AndChen153/Stability-Setup/data/Mar-15-2023/README.txt

scanlightMar-15-2023 13_34_51.csv
actually a light scan just renamed to dark scan for powerpoint testing purposes
