AndChen153/Stability-Setup/data/July-11-2022/DataPPT.pptx

## Slide 2

## Slide 3

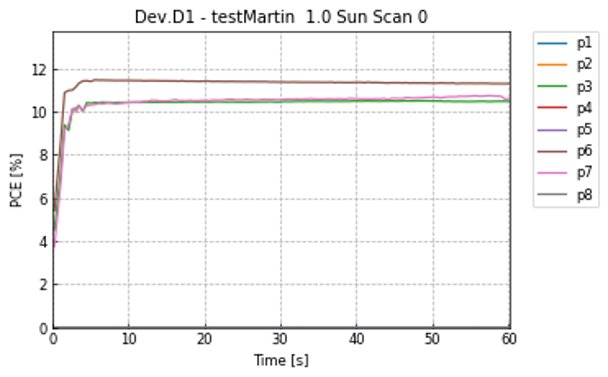
[picture p5: figure]
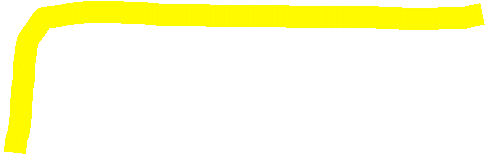
[picture p6: figure]

## Next Steps

- fine tune scan rate
- wire up new chips to samtec connector
- develop code to allow for collection of 8 pixels of data
- improve mppt algorithm to be faster and more accurate
- stress test setup for long time
