AndChen153/Stability-Setup/pcb/old/altium/LitosConnector/LitosConnector.txt

Board Information Report
Filename     : C:\Users\Andrew Chen\Dropbox\code\Stability-Setup\pcb\altium\LitosConnector\LitosConnector.PcbDoc
Date         : 3/11/2023
Time         : 11:18:13 PM
Time Elapsed : 00:00:00

General
    Board Size, 53mmx160.5mm
    Components on board, 7
count : 2
