AndChen153/Stability-Setup/data/Apr-25-2023 15_50_01/Apr-25-2023 15_50_06lightscan/Apr-25-2023 15_50_06lightscan DEVICE_1.png

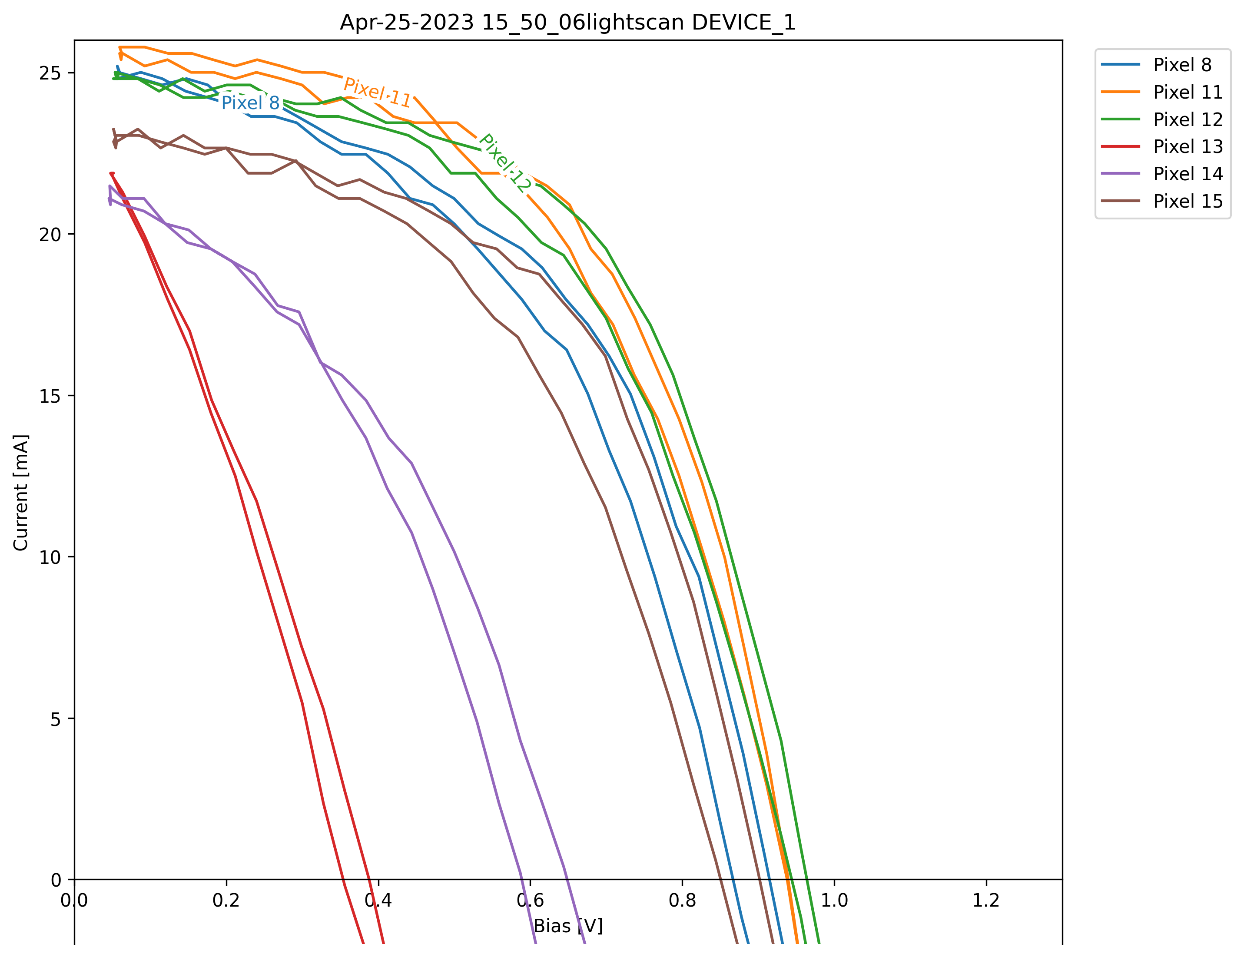
data/Apr-25-2023 15_50_01/Apr-25-2023 15_50_06lightscan/Apr-25-2023 15_50_06lightscan DEVICE_1.png
