AndChen153/Stability-Setup/data/Apr-25-2023 15_50_01/Apr-25-2023 15_50_06lightscan/Γ_JSC_BoxPlot.png

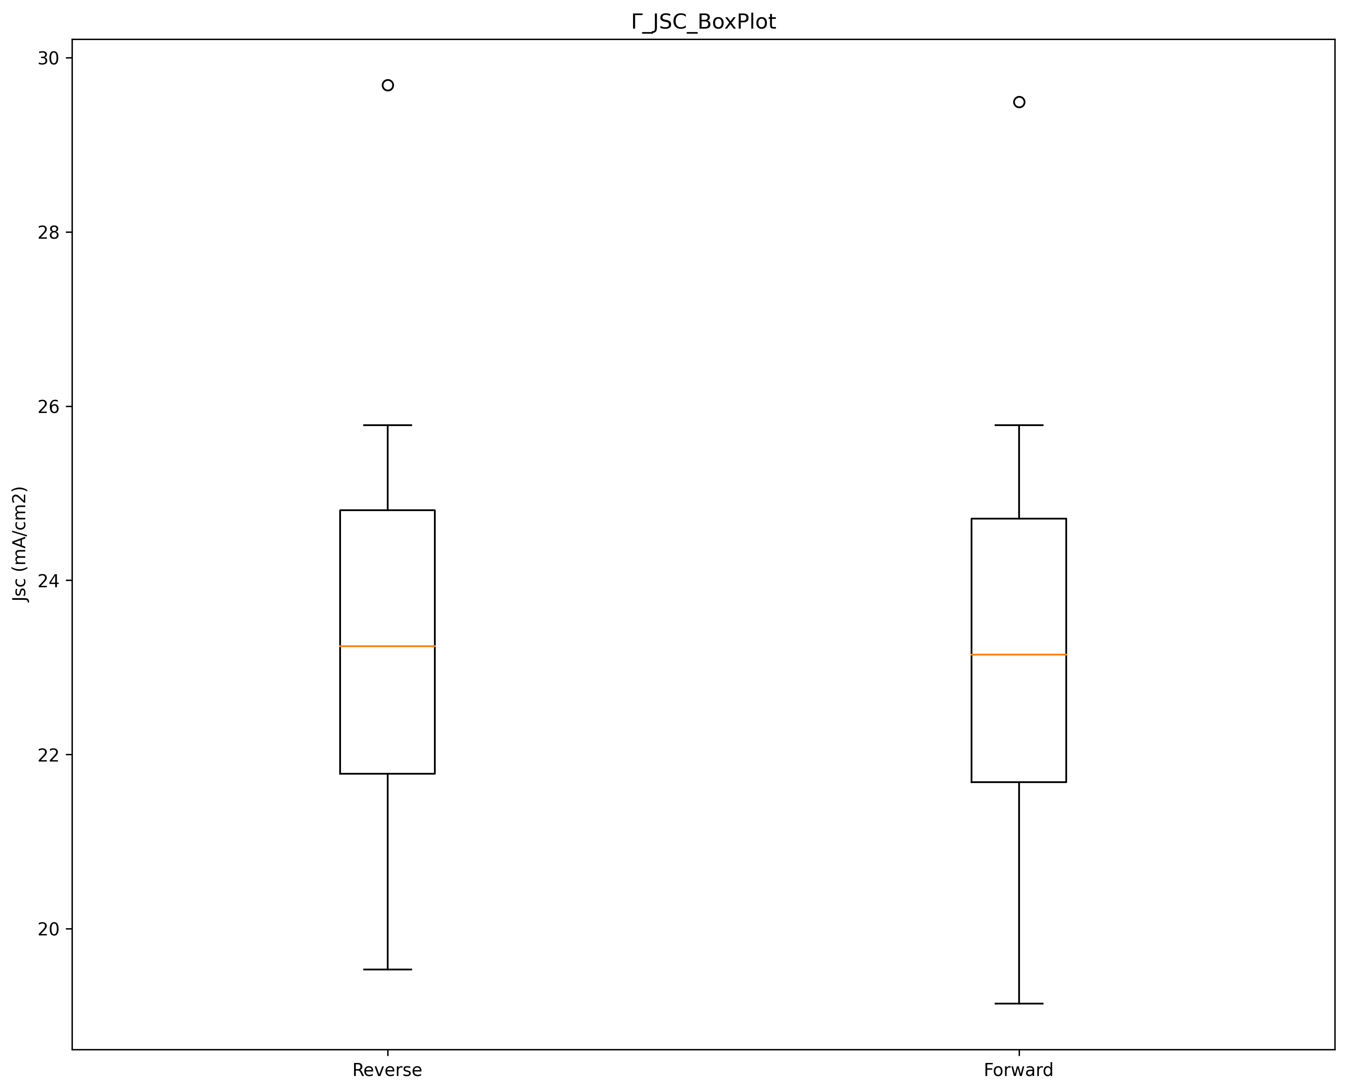
data/Apr-25-2023 15_50_01/Apr-25-2023 15_50_06lightscan/Γ_JSC_BoxPlot.png
