AndChen153/Stability-Setup/data/Apr-25-2023 15_50_01/Apr-25-2023 15_51_12PnO/Apr-25-2023 15_51_12PnO DEVICE_3.png

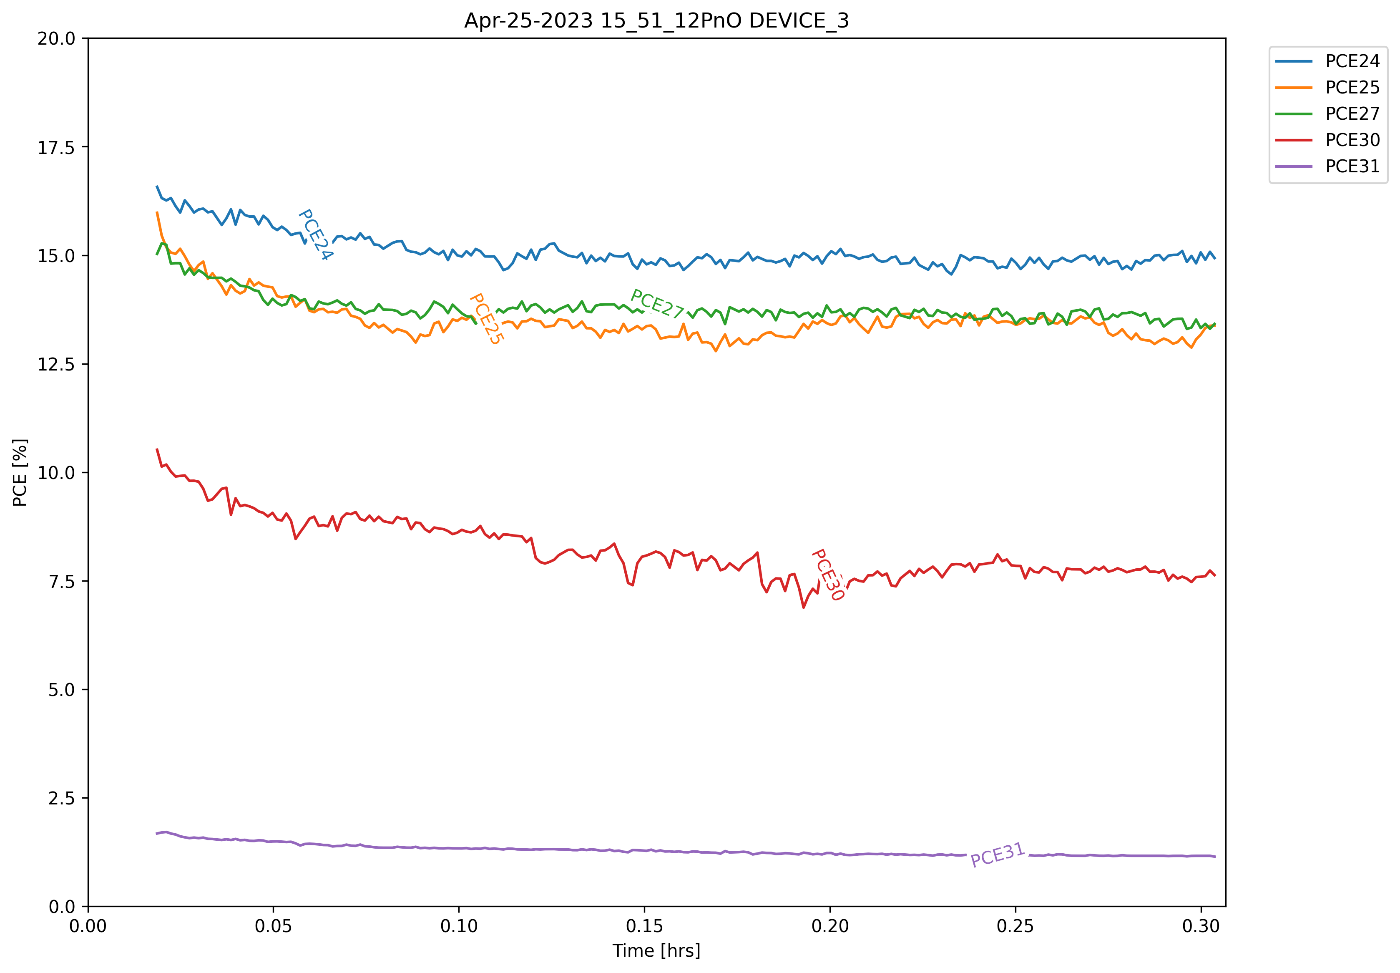
data/Apr-25-2023 15_50_01/Apr-25-2023 15_51_12PnO/Apr-25-2023 15_51_12PnO DEVICE_3.png
