AndChen153/Stability-Setup/data/Apr-25-2023 15_50_01/Apr-25-2023 15_51_12PnO/Γ_PCE_BoxPlot_(last values).png

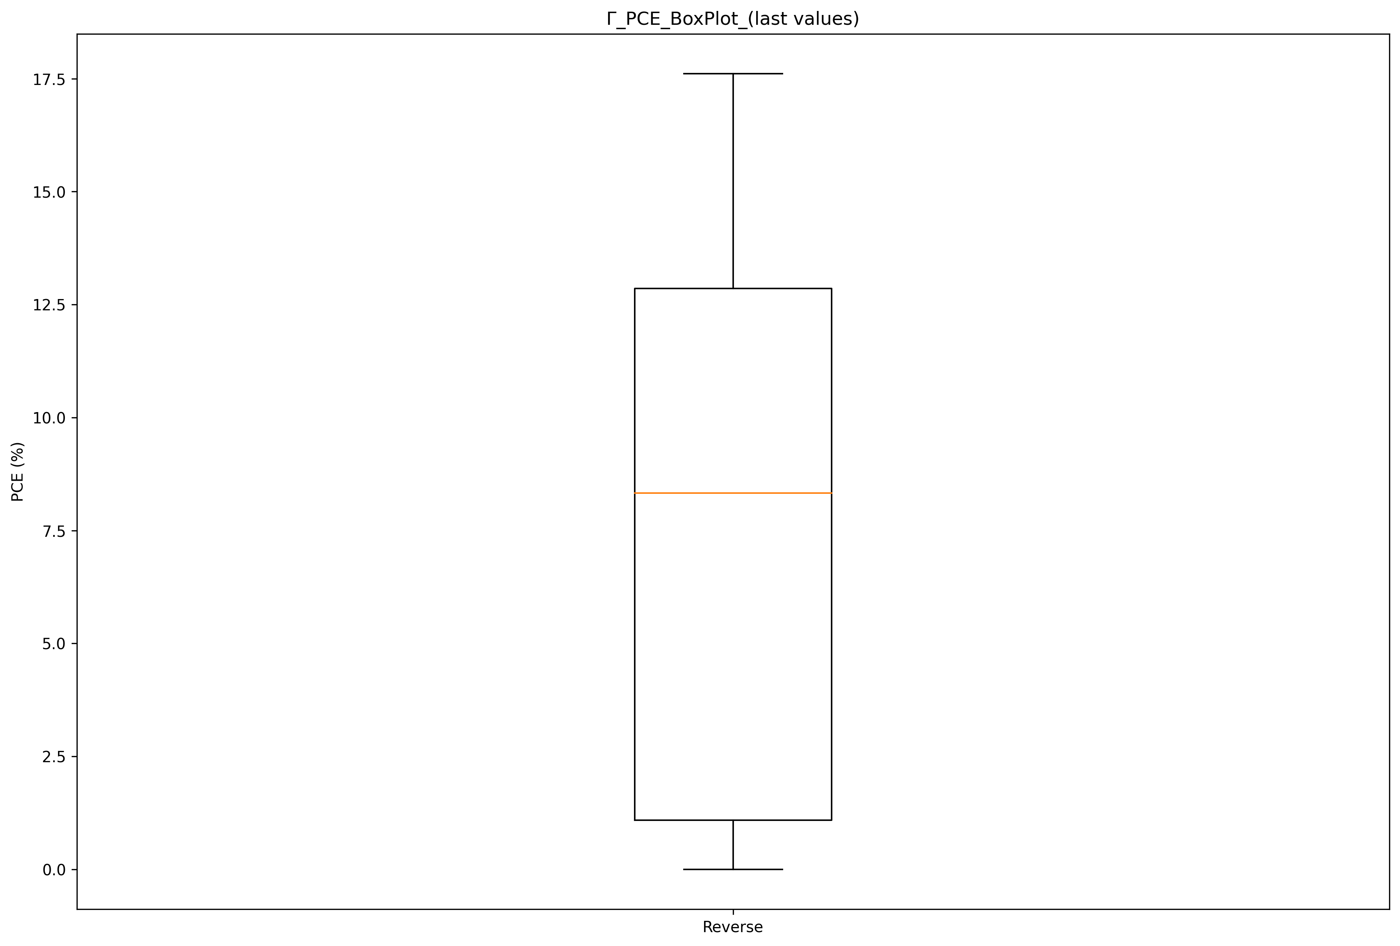
data/Apr-25-2023 15_50_01/Apr-25-2023 15_51_12PnO/Γ_PCE_BoxPlot_(last values).png
