AndChen153/Stability-Setup/data/Apr-26-2023 16_10_47/Apr-26-2023 16_13_25lightscan/Apr-26-2023 16_13_25lightscan DEVICE_0.png

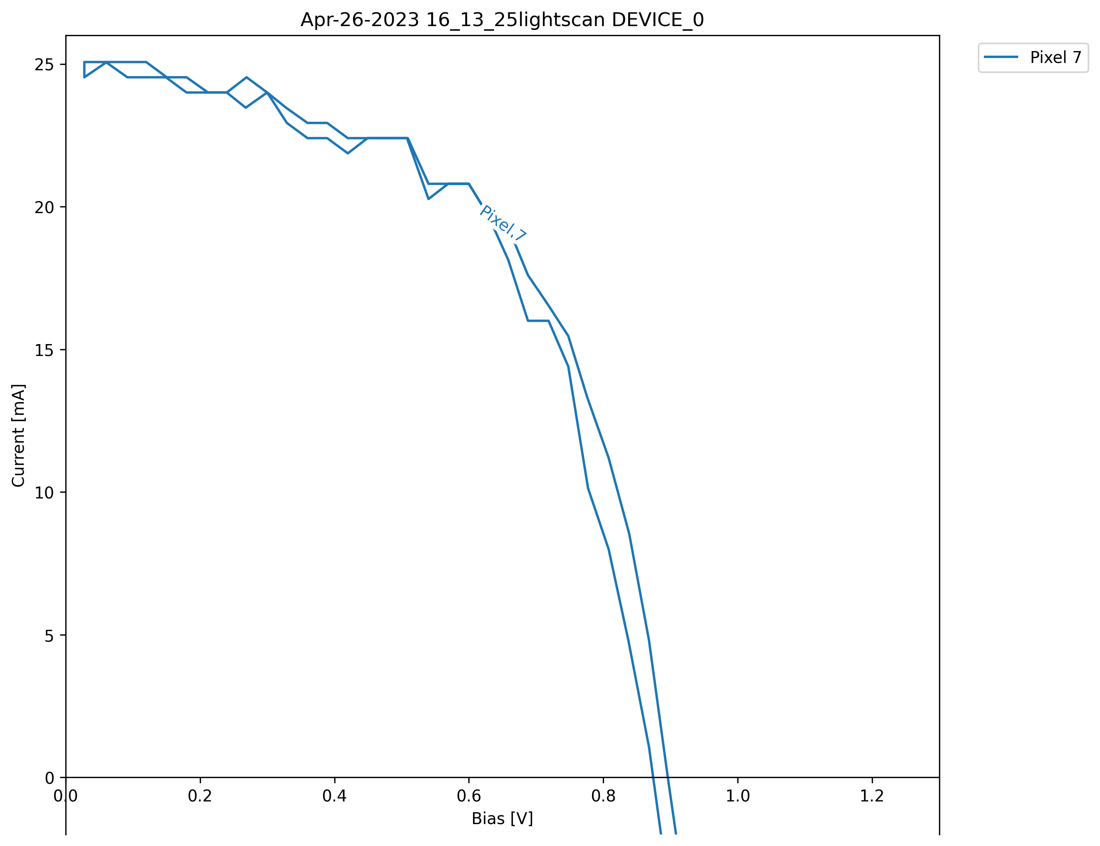
data/Apr-26-2023 16_10_47/Apr-26-2023 16_13_25lightscan/Apr-26-2023 16_13_25lightscan DEVICE_0.png
