AndChen153/Stability-Setup/data/Apr-26-2023 16_10_47/Apr-26-2023 16_14_17PnO/Apr-26-2023 16_14_17PnO DEVICE_0.png

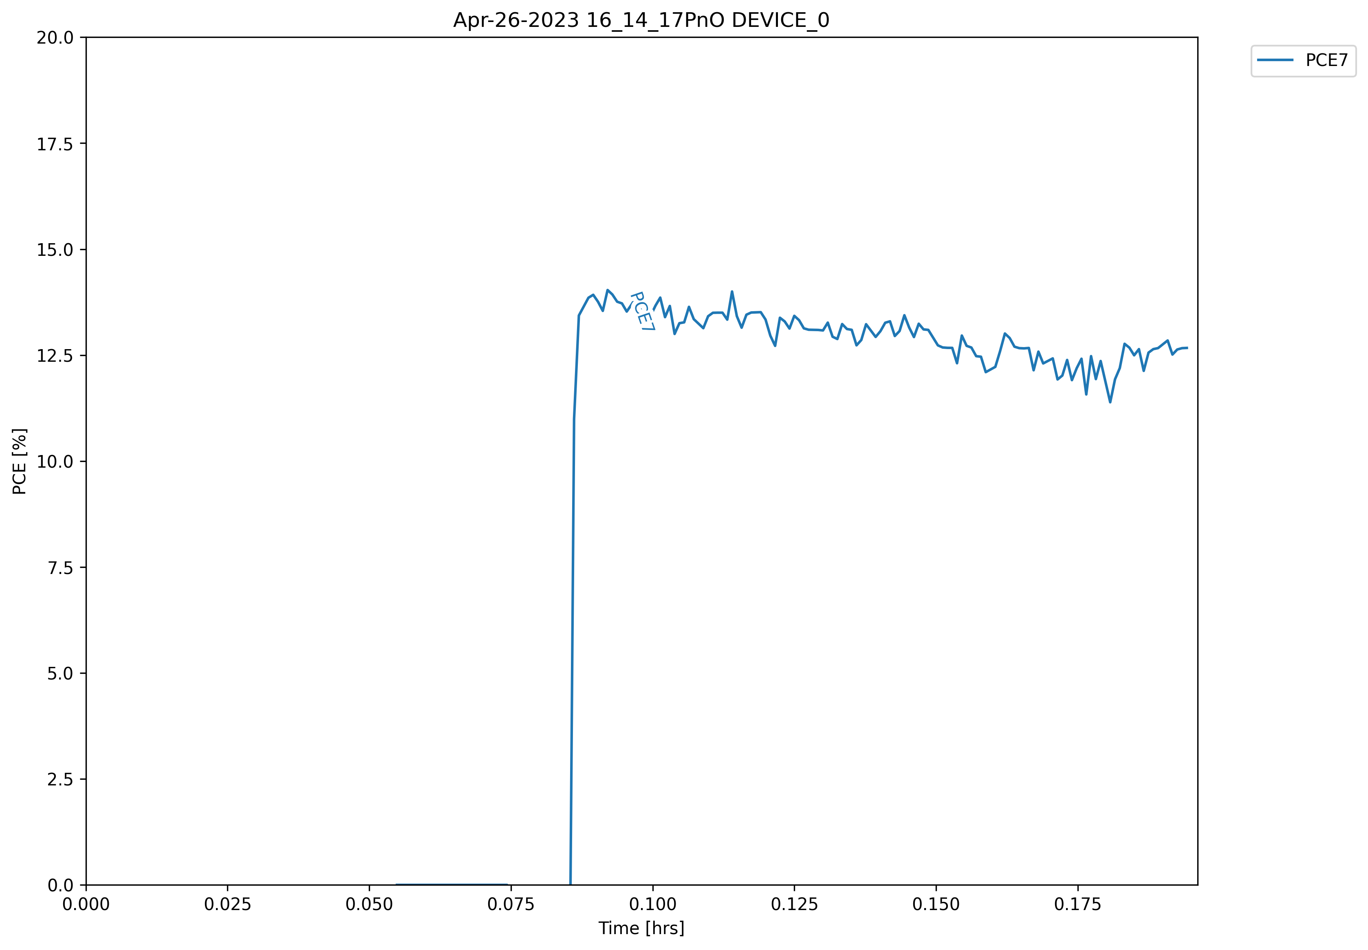
data/Apr-26-2023 16_10_47/Apr-26-2023 16_14_17PnO/Apr-26-2023 16_14_17PnO DEVICE_0.png
