AndChen153/Stability-Setup/data/Mar-15-2023/PnOMar-15-2023 13_29_55/PnOMar-15-2023 13_29_55 DEVICE_3.png

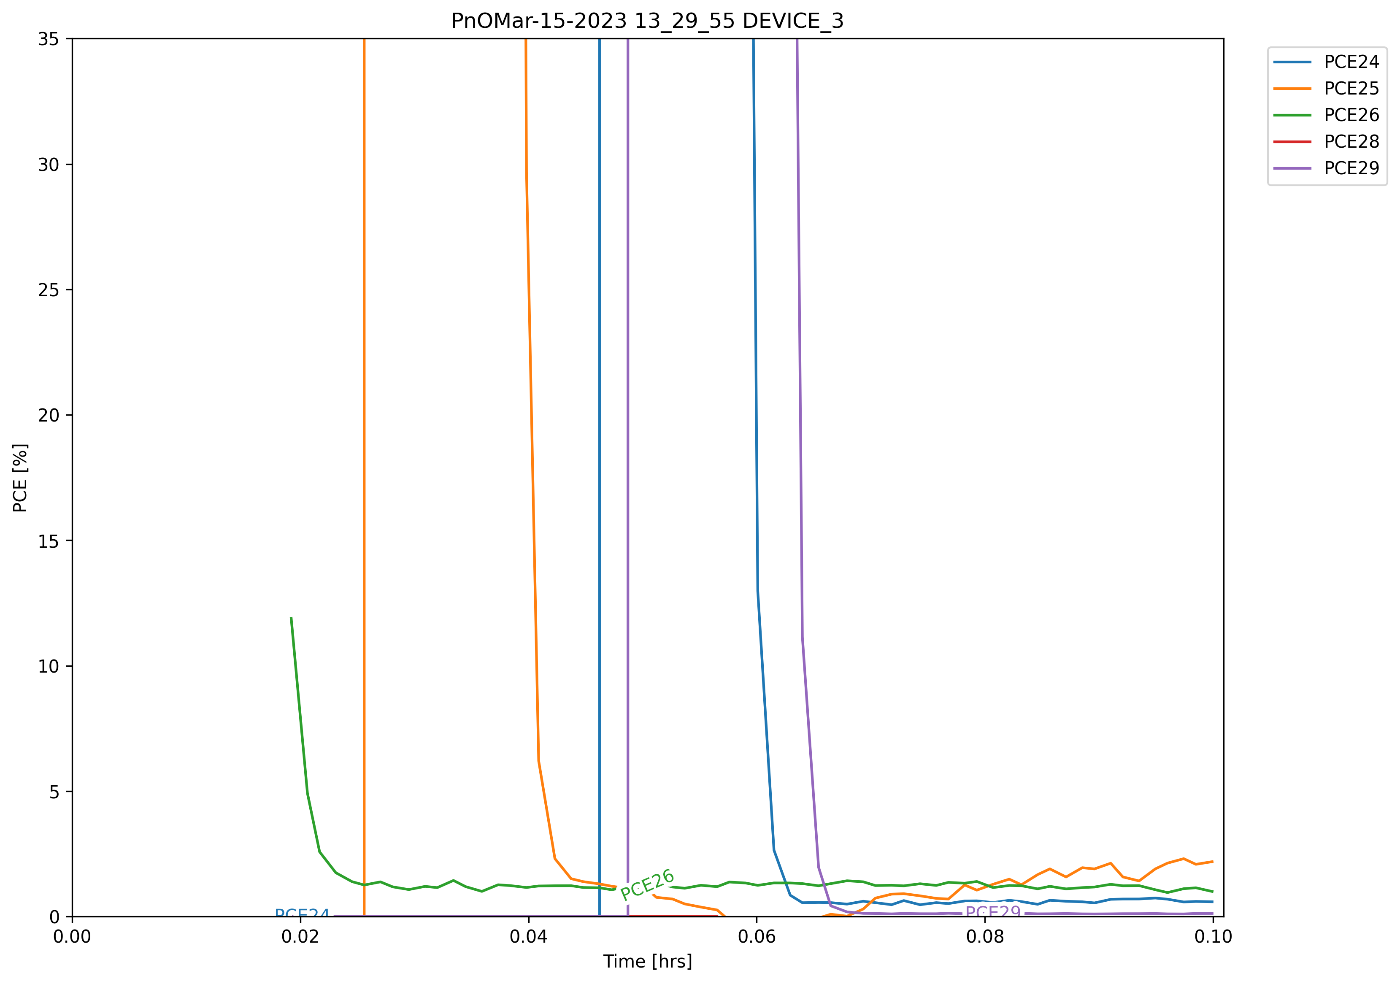
data/Mar-15-2023/PnOMar-15-2023 13_29_55/PnOMar-15-2023 13_29_55 DEVICE_3.png
