AndChen153/Stability-Setup/data/Mar-15-2023/scandarkMar-15-2023 13_34_51/scandarkMar-15-2023 13_34_51 DEVICE_1.png

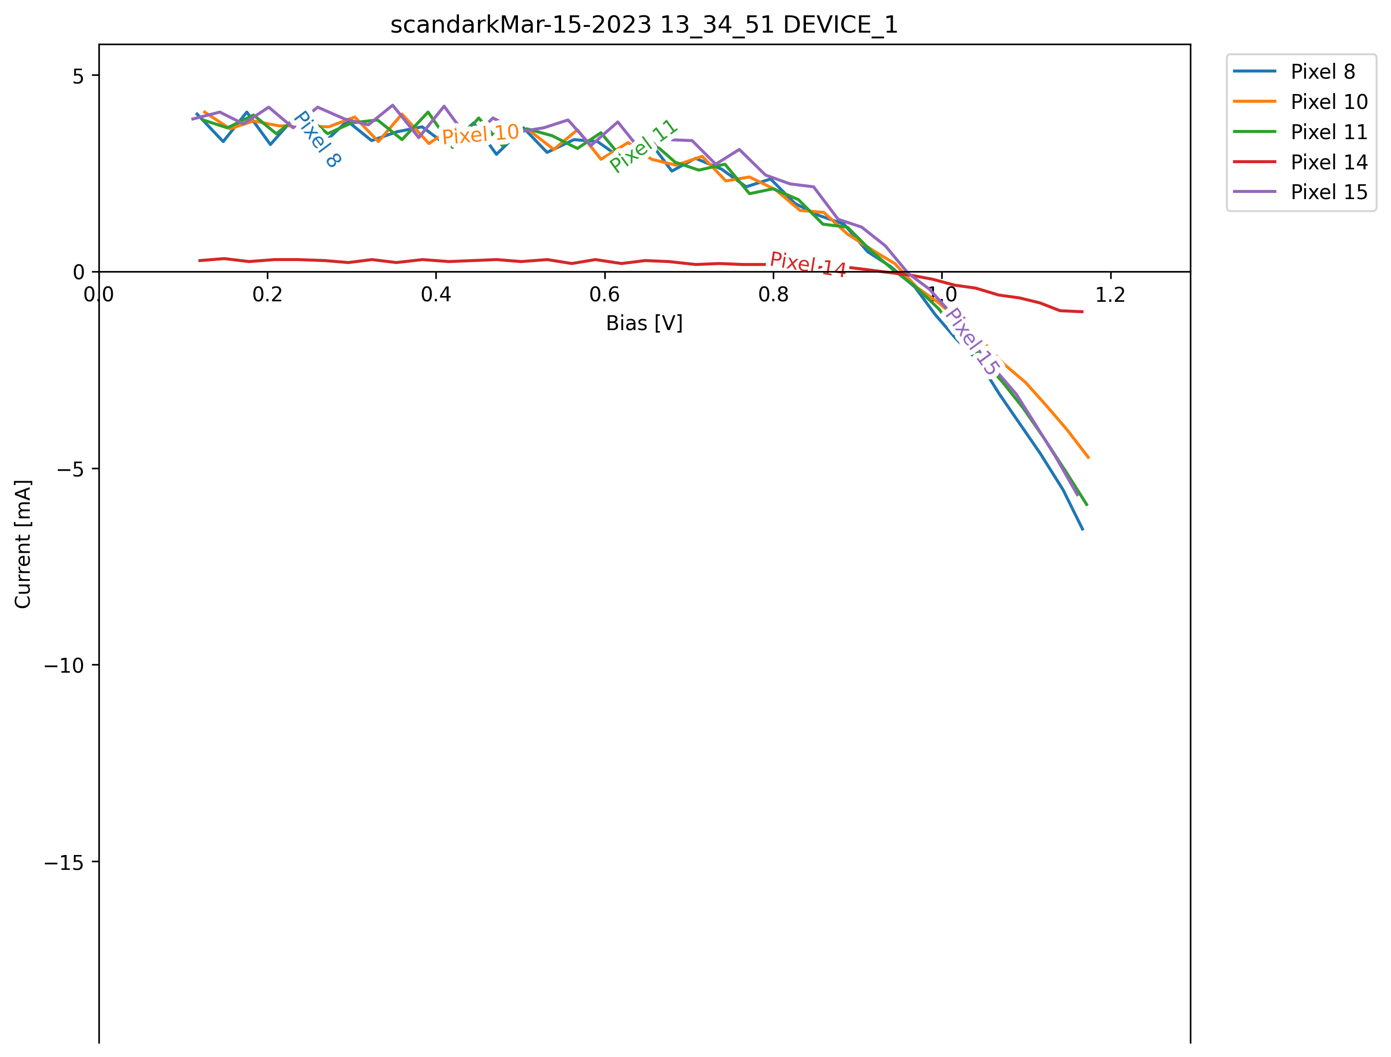
data/Mar-15-2023/scandarkMar-15-2023 13_34_51/scandarkMar-15-2023 13_34_51 DEVICE_1.png
