AndChen153/Stability-Setup/data/Mar-15-2023/scandarkMar-15-2023 13_34_51/Γ_VOC_BoxPlot.png

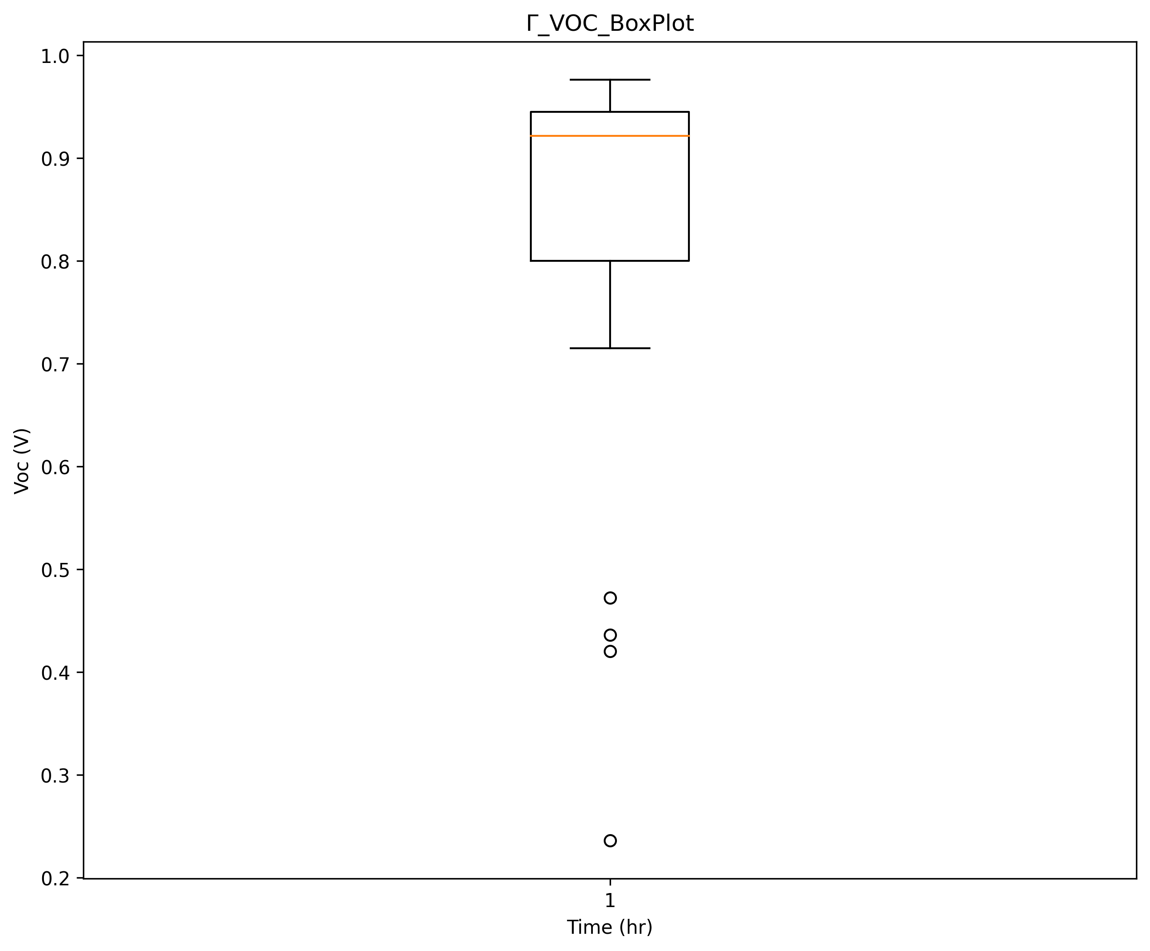
data/Mar-15-2023/scandarkMar-15-2023 13_34_51/Γ_VOC_BoxPlot.png
