AndChen153/Stability-Setup/data/Mar-15-2023/scanlightMar-15-2023 13_28_50/scanlightMar-15-2023 13_28_50 DEVICE_0.png

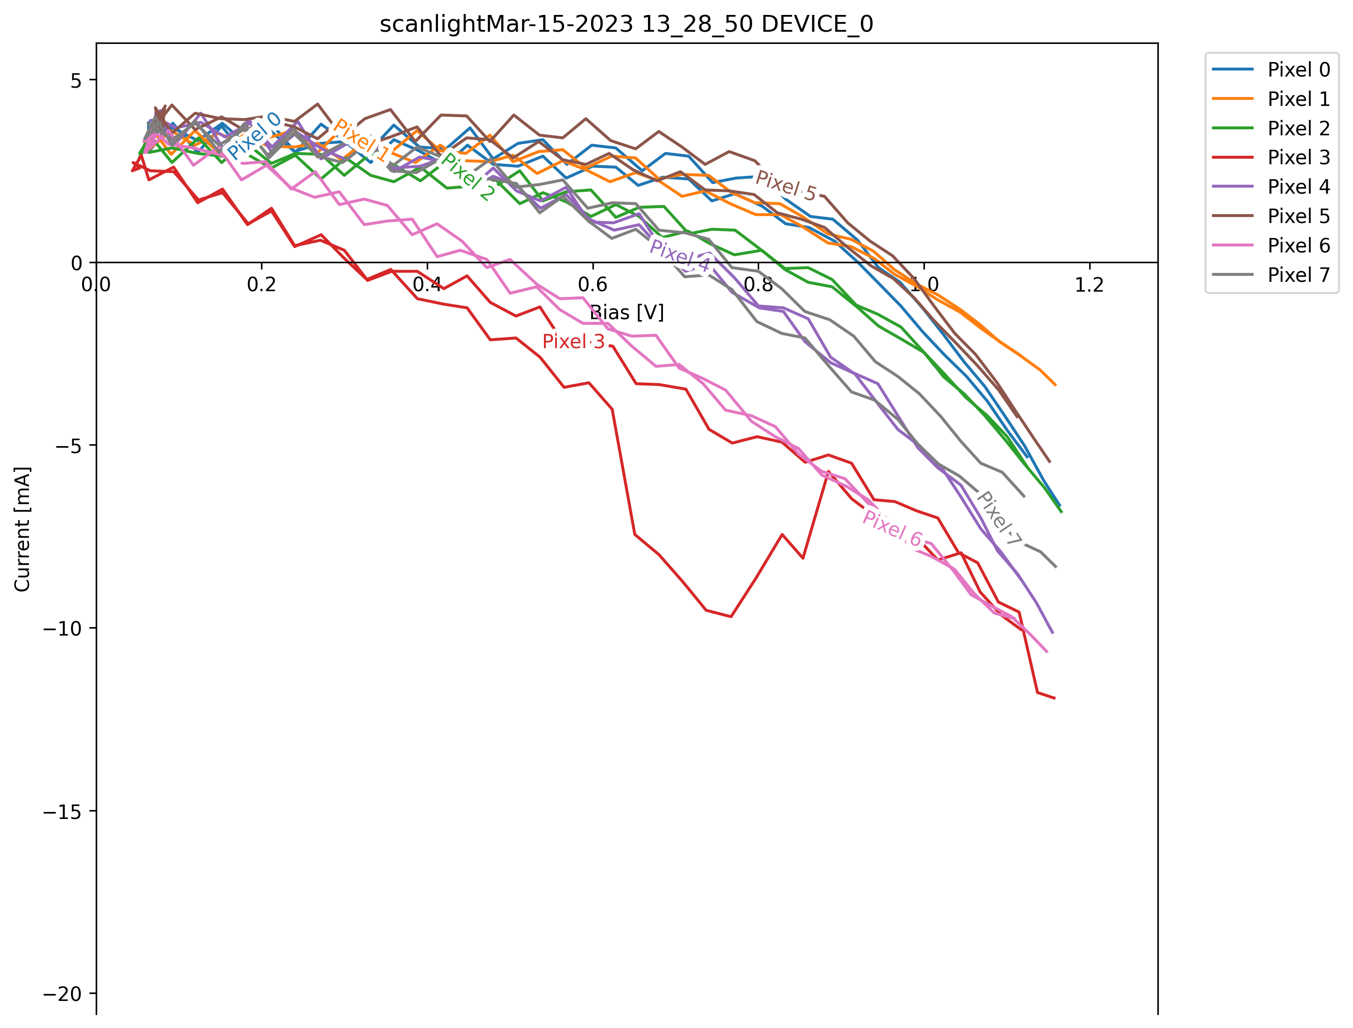
data/Mar-15-2023/scanlightMar-15-2023 13_28_50/scanlightMar-15-2023 13_28_50 DEVICE_0.png
