AndChen153/Stability-Setup/data/Oct-26-2023 14_16_23/Oct-26-2023 14_16_26lightID0scan/Γ_FF_BoxPlot.png

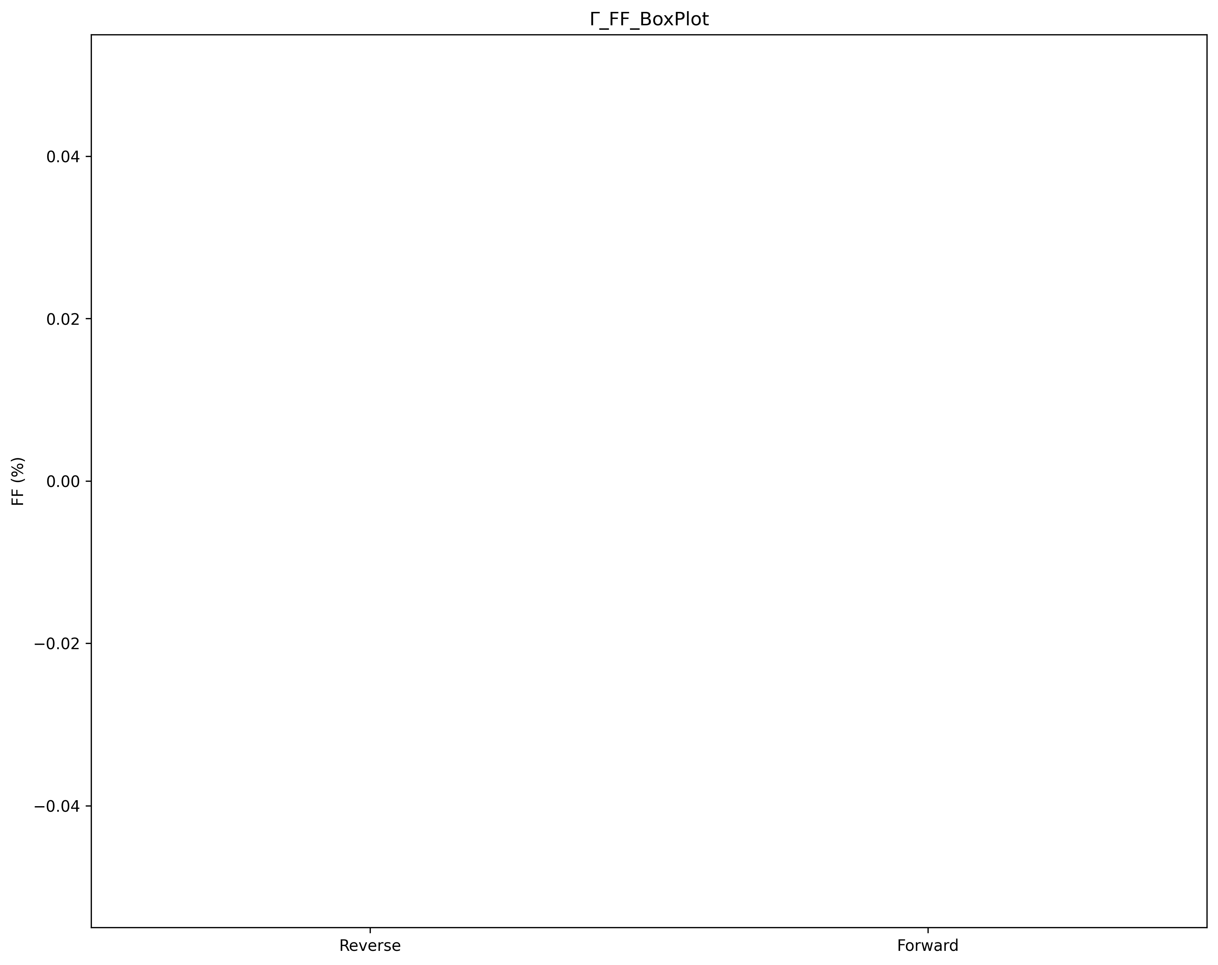
data/Oct-26-2023 14_16_23/Oct-26-2023 14_16_26lightID0scan/Γ_FF_BoxPlot.png
