AndChen153/Stability-Setup/data/photodiodetest/0p/Nov-08-2023 15_57_40lightID1scan/Nov-08-2023 15_57_40lightID1scan.png

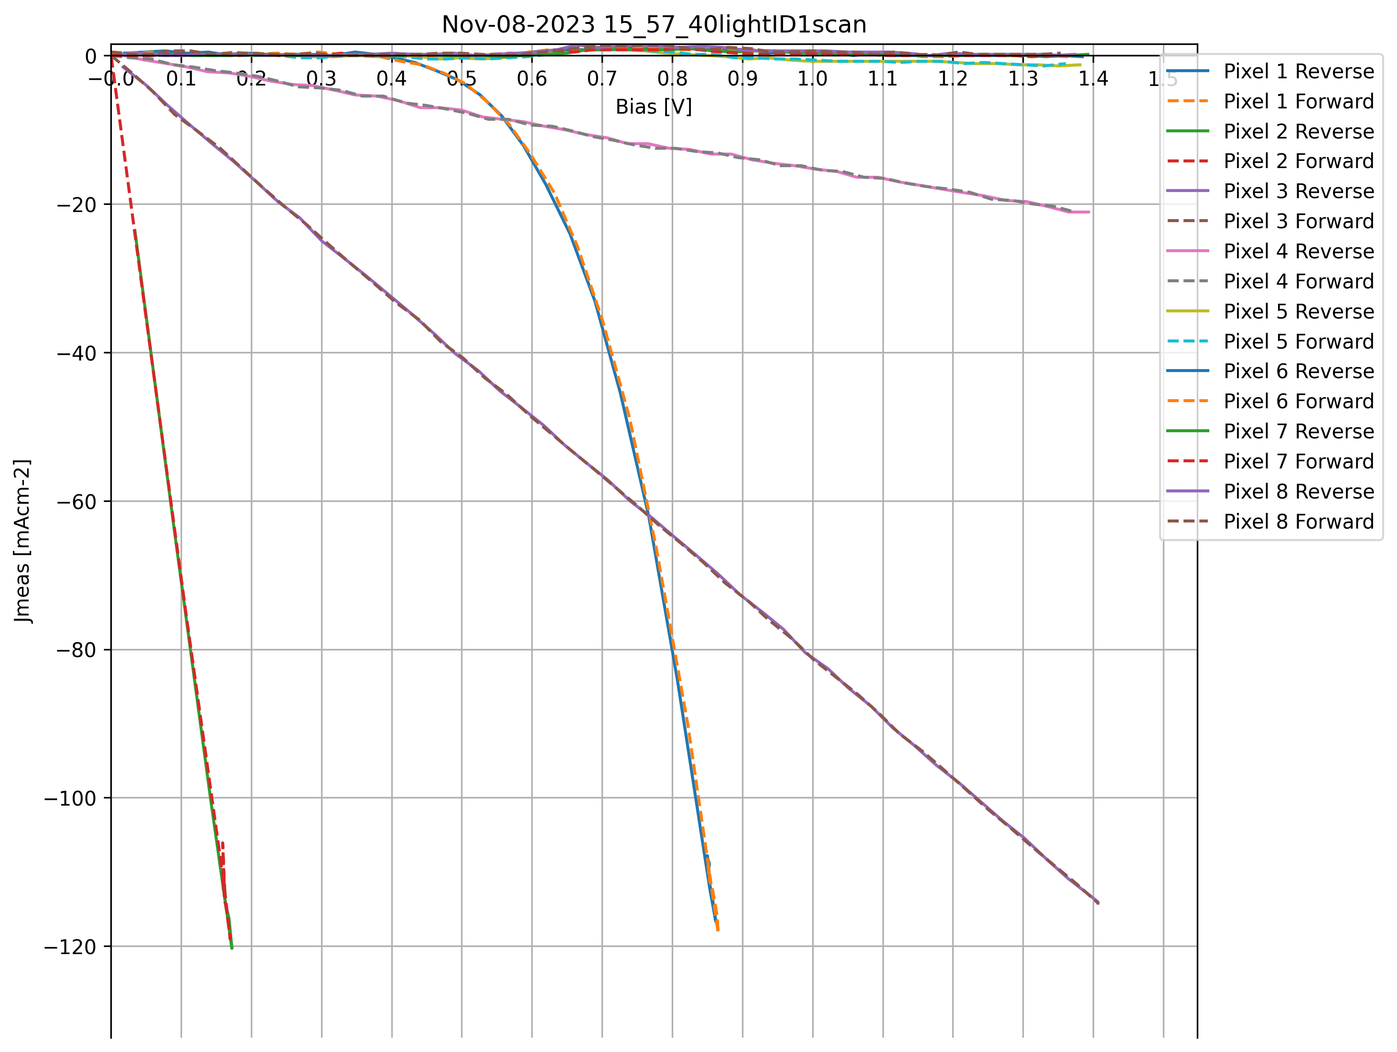
data/photodiodetest/0p/Nov-08-2023 15_57_40lightID1scan/Nov-08-2023 15_57_40lightID1scan.png
