AndChen153/Stability-Setup/data/photodiodetest/0p/Nov-08-2023 15_57_40lightID2scan/Γ_VOC_BoxPlot.png

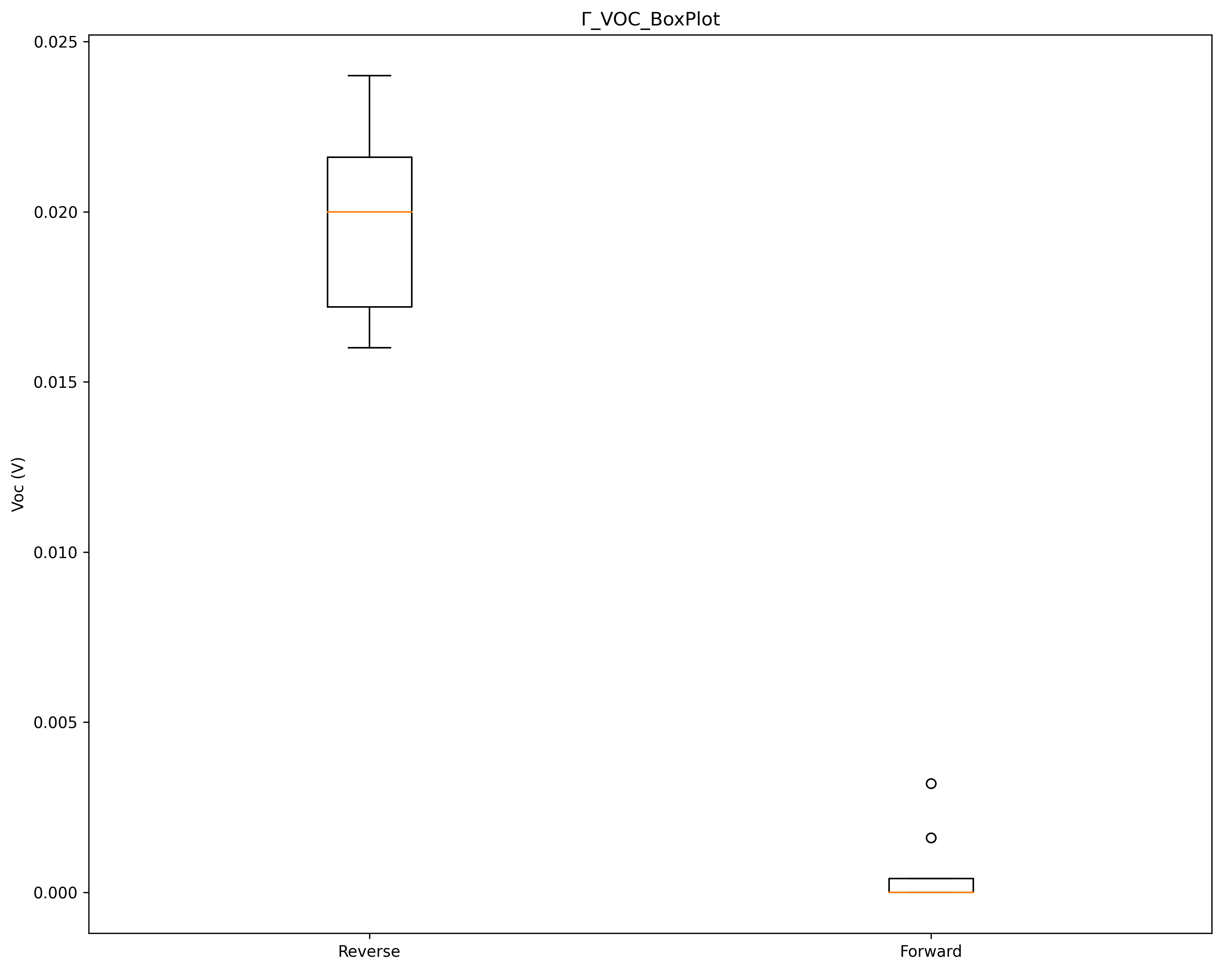
data/photodiodetest/0p/Nov-08-2023 15_57_40lightID2scan/Γ_VOC_BoxPlot.png
