AndChen153/Stability-Setup/data/photodiodetest/20p/Nov-08-2023 15_56_12lightID1scan/Nov-08-2023 15_56_12lightID1scan.png

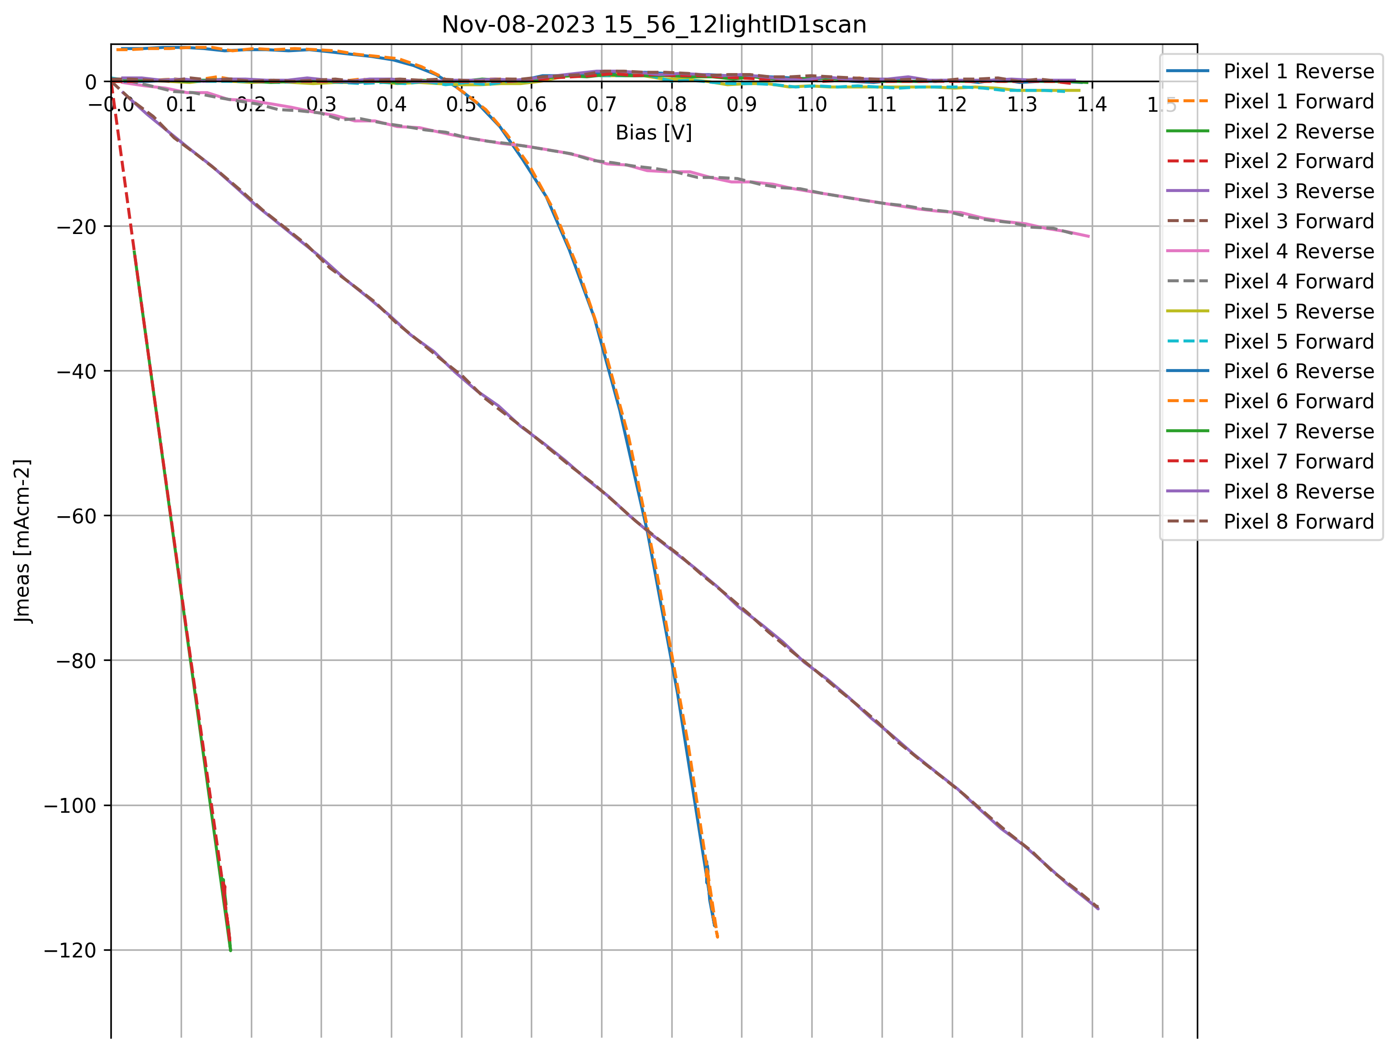
data/photodiodetest/20p/Nov-08-2023 15_56_12lightID1scan/Nov-08-2023 15_56_12lightID1scan.png
