AndChen153/Stability-Setup/data/photodiodetest/20p/Nov-08-2023 15_56_12lightID2scan/Γ_JSC_BoxPlot.png

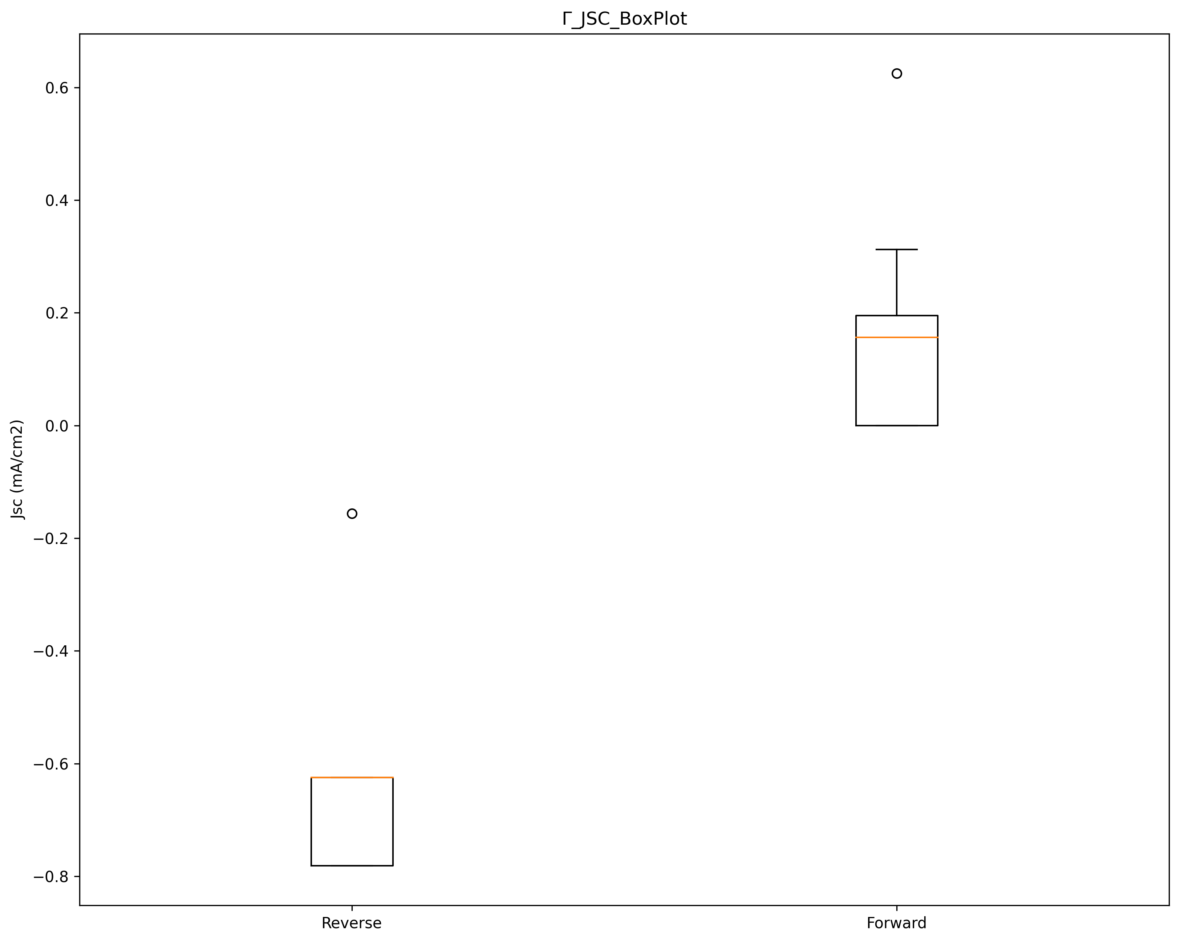
data/photodiodetest/20p/Nov-08-2023 15_56_12lightID2scan/Γ_JSC_BoxPlot.png
