AndChen153/Stability-Setup/data/photodiodetest/30p/Nov-08-2023 15_10_30lightID1scan/Γ_JSC_BoxPlot.png

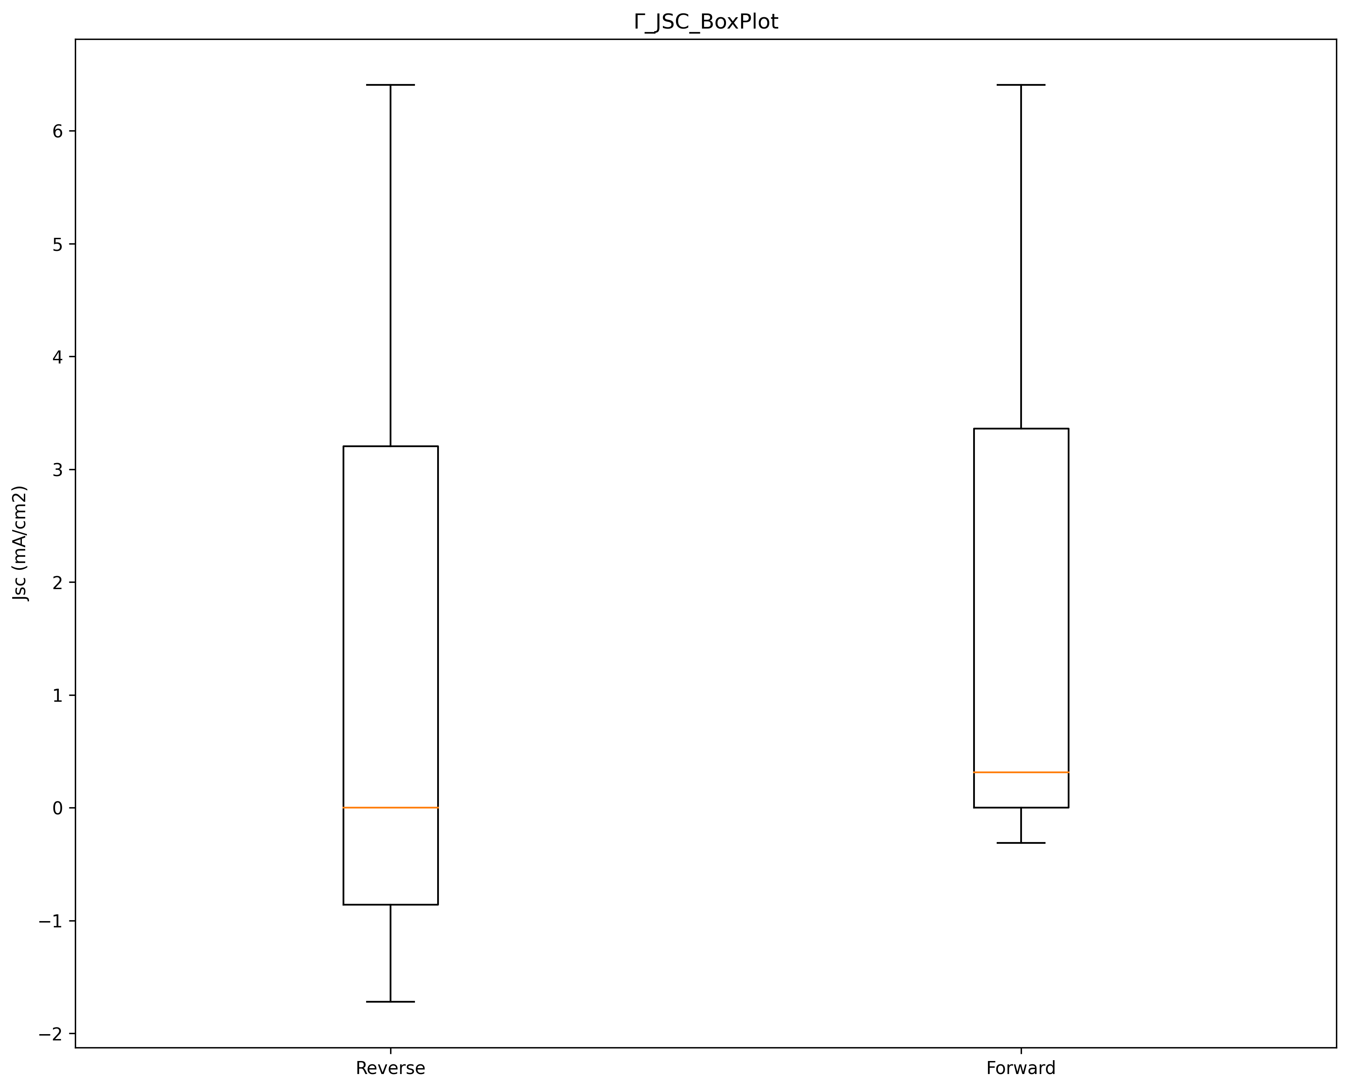
data/photodiodetest/30p/Nov-08-2023 15_10_30lightID1scan/Γ_JSC_BoxPlot.png
