AndChen153/Stability-Setup/data/photodiodetest/40p/Nov-08-2023 15_54_32lightID1scan/Γ_VOC_BoxPlot.png

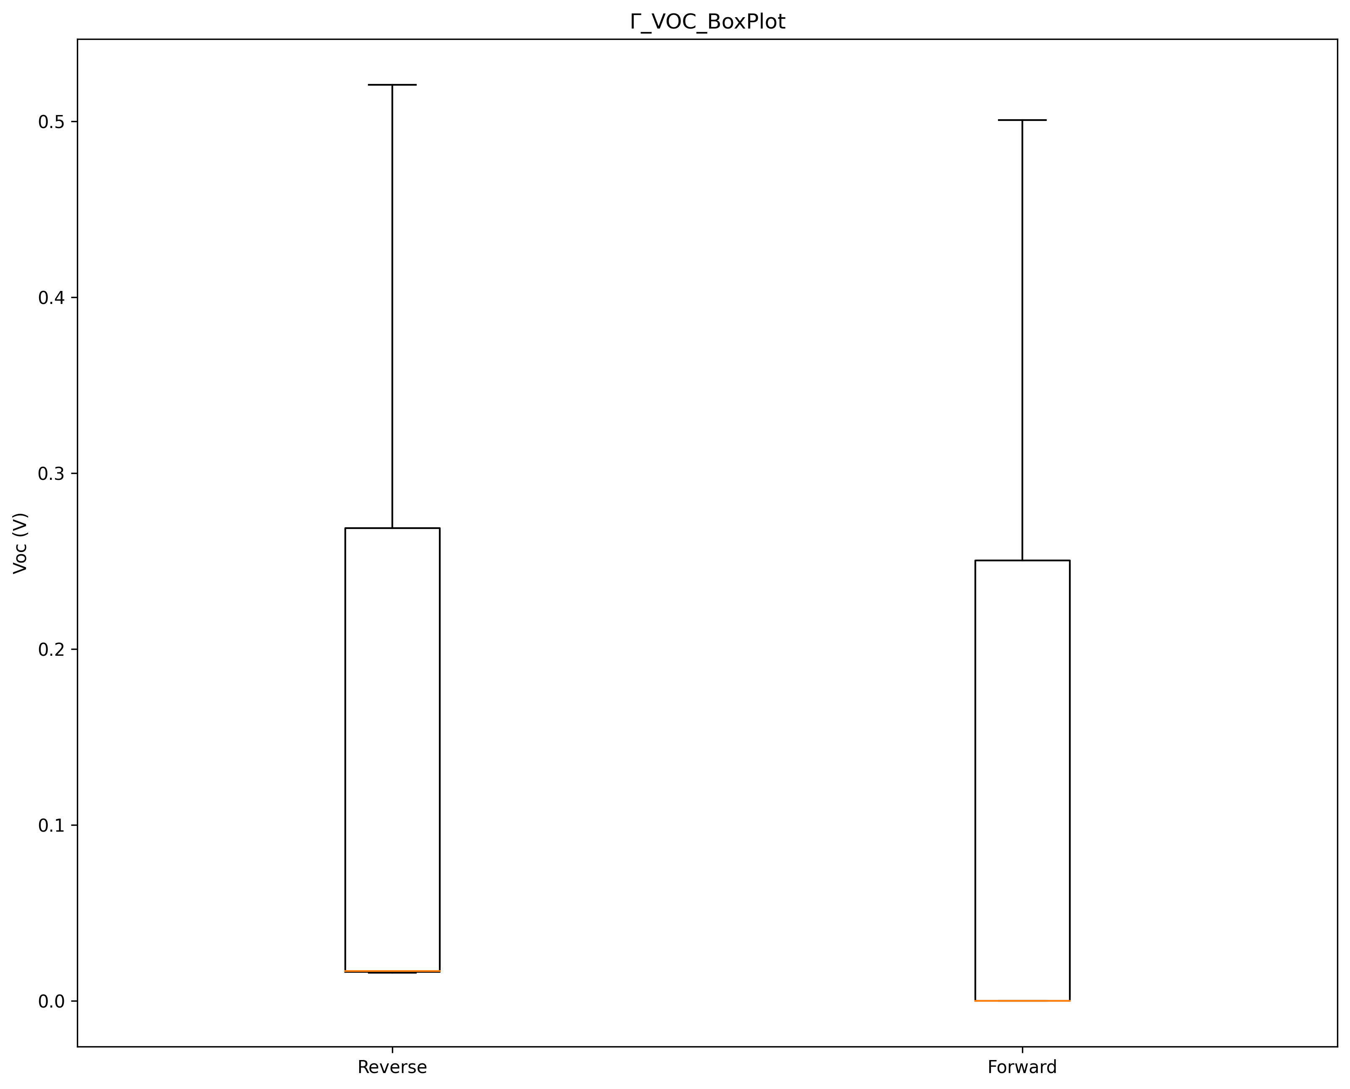
data/photodiodetest/40p/Nov-08-2023 15_54_32lightID1scan/Γ_VOC_BoxPlot.png
