AndChen153/Stability-Setup/data/photodiodetest/60p/Nov-08-2023 15_52_34lightID1scan/Nov-08-2023 15_52_34lightID1scan.png

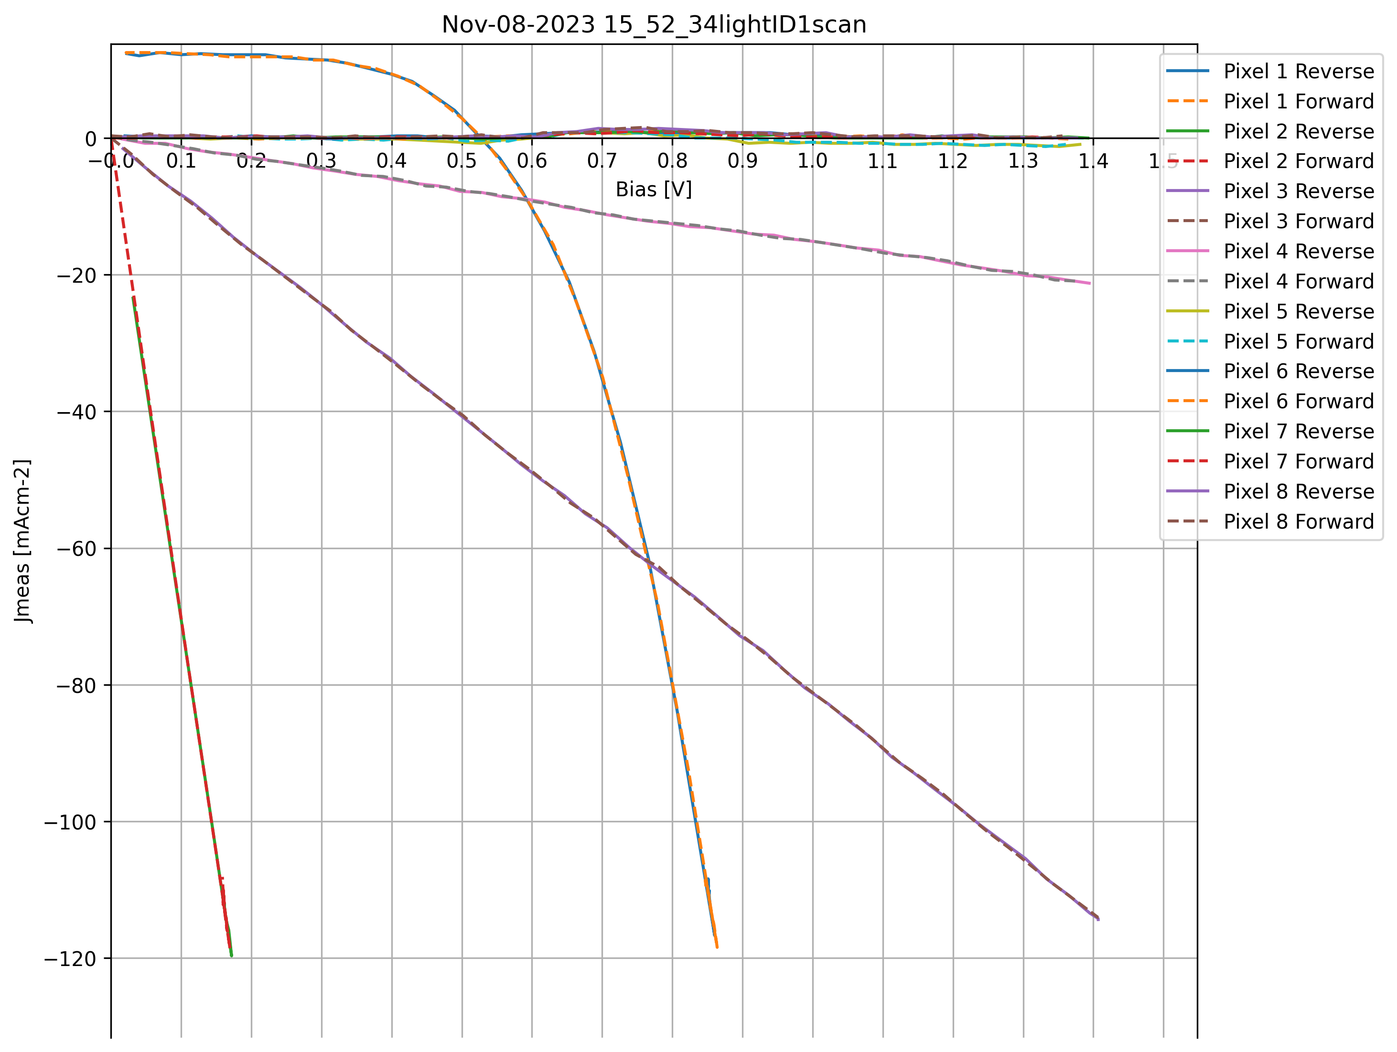
data/photodiodetest/60p/Nov-08-2023 15_52_34lightID1scan/Nov-08-2023 15_52_34lightID1scan.png
