AndChen153/Stability-Setup/data/photodiodetest/80p/Nov-08-2023 15_05_51lightID1scan/Γ_JSC_BoxPlot.png

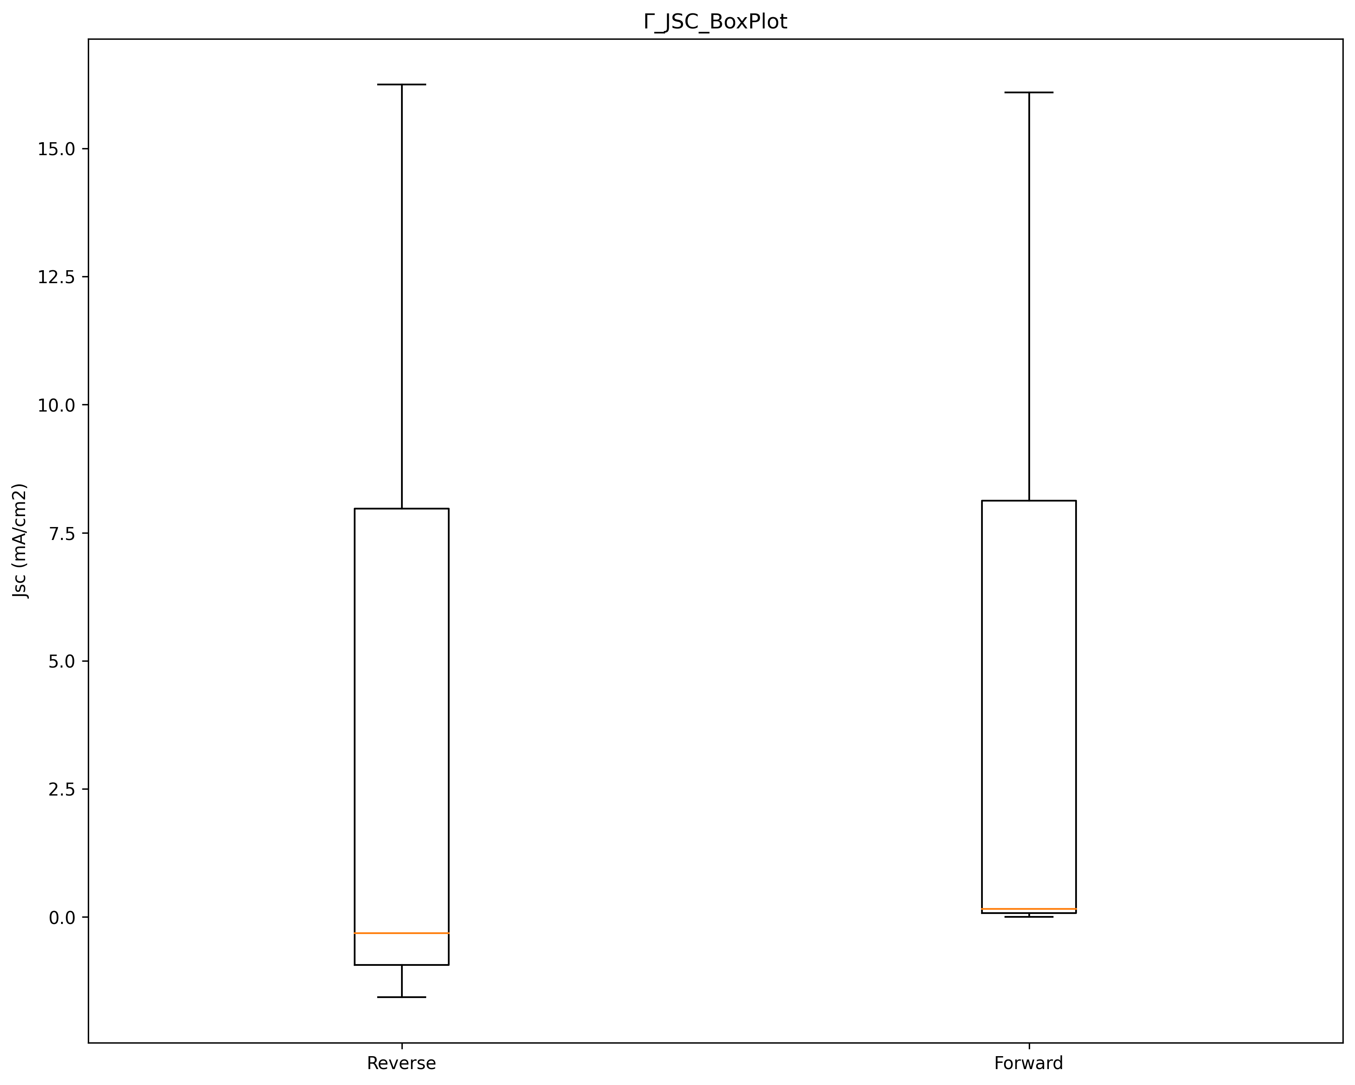
data/photodiodetest/80p/Nov-08-2023 15_05_51lightID1scan/Γ_JSC_BoxPlot.png
