AndChen153/Stability-Setup/data/photodiodetest/100p/Nov-08-2023 14_40_34lightID1scan/Nov-08-2023 14_40_34lightID1scan.png

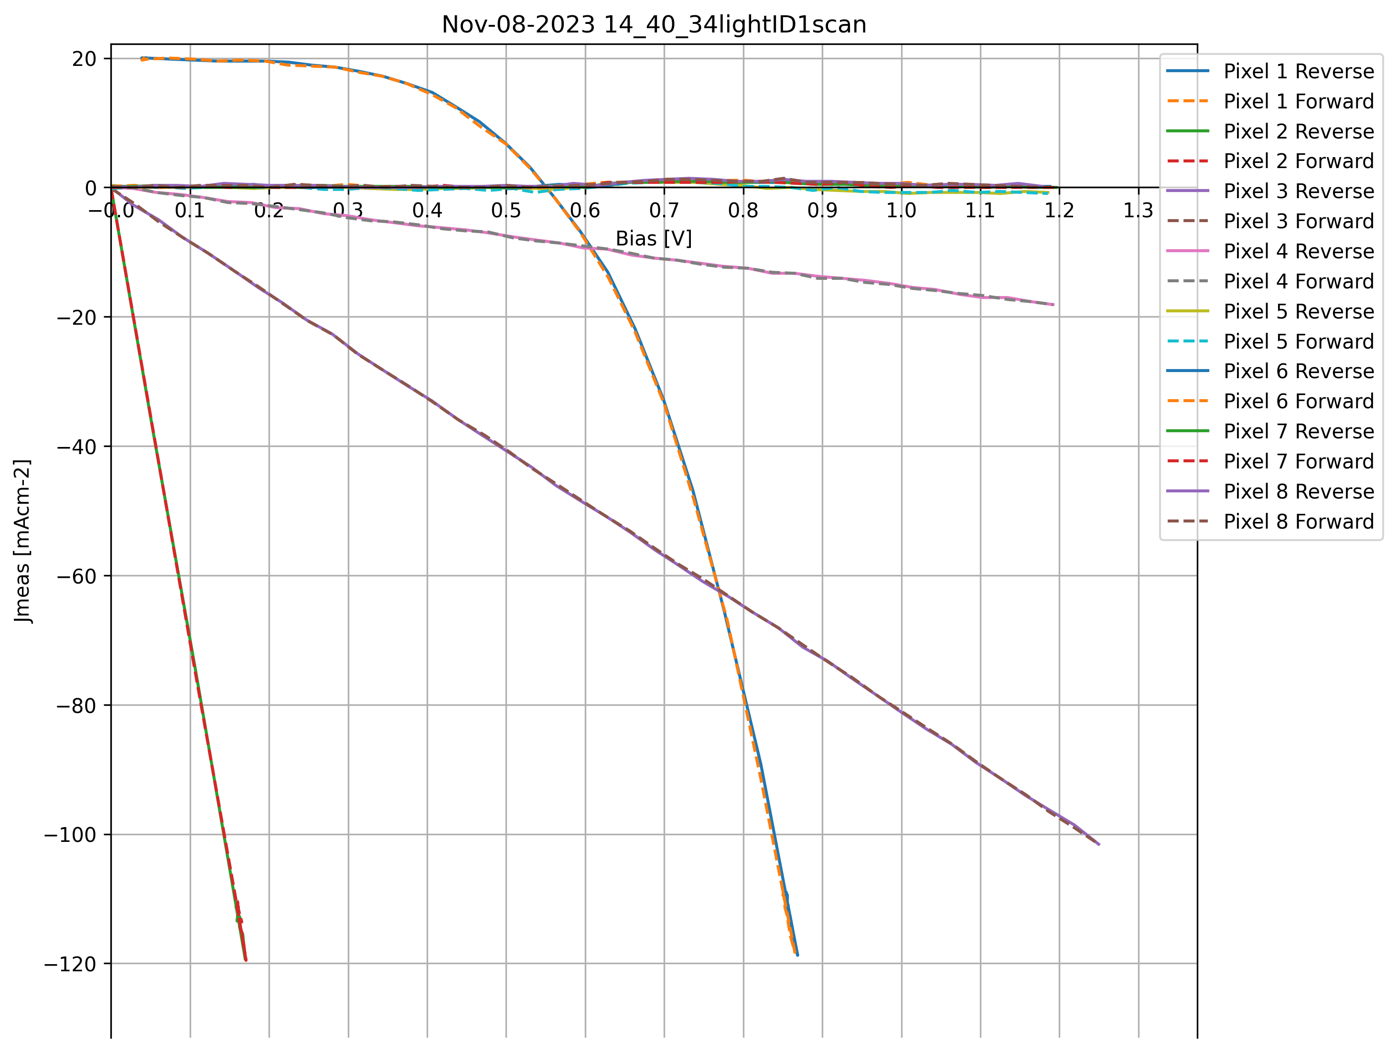
data/photodiodetest/100p/Nov-08-2023 14_40_34lightID1scan/Nov-08-2023 14_40_34lightID1scan.png
