AndChen153/Stability-Setup/data/photodiodetest/100p/Nov-08-2023 14_40_34lightID2scan/Nov-08-2023 14_40_34lightID2scan.png

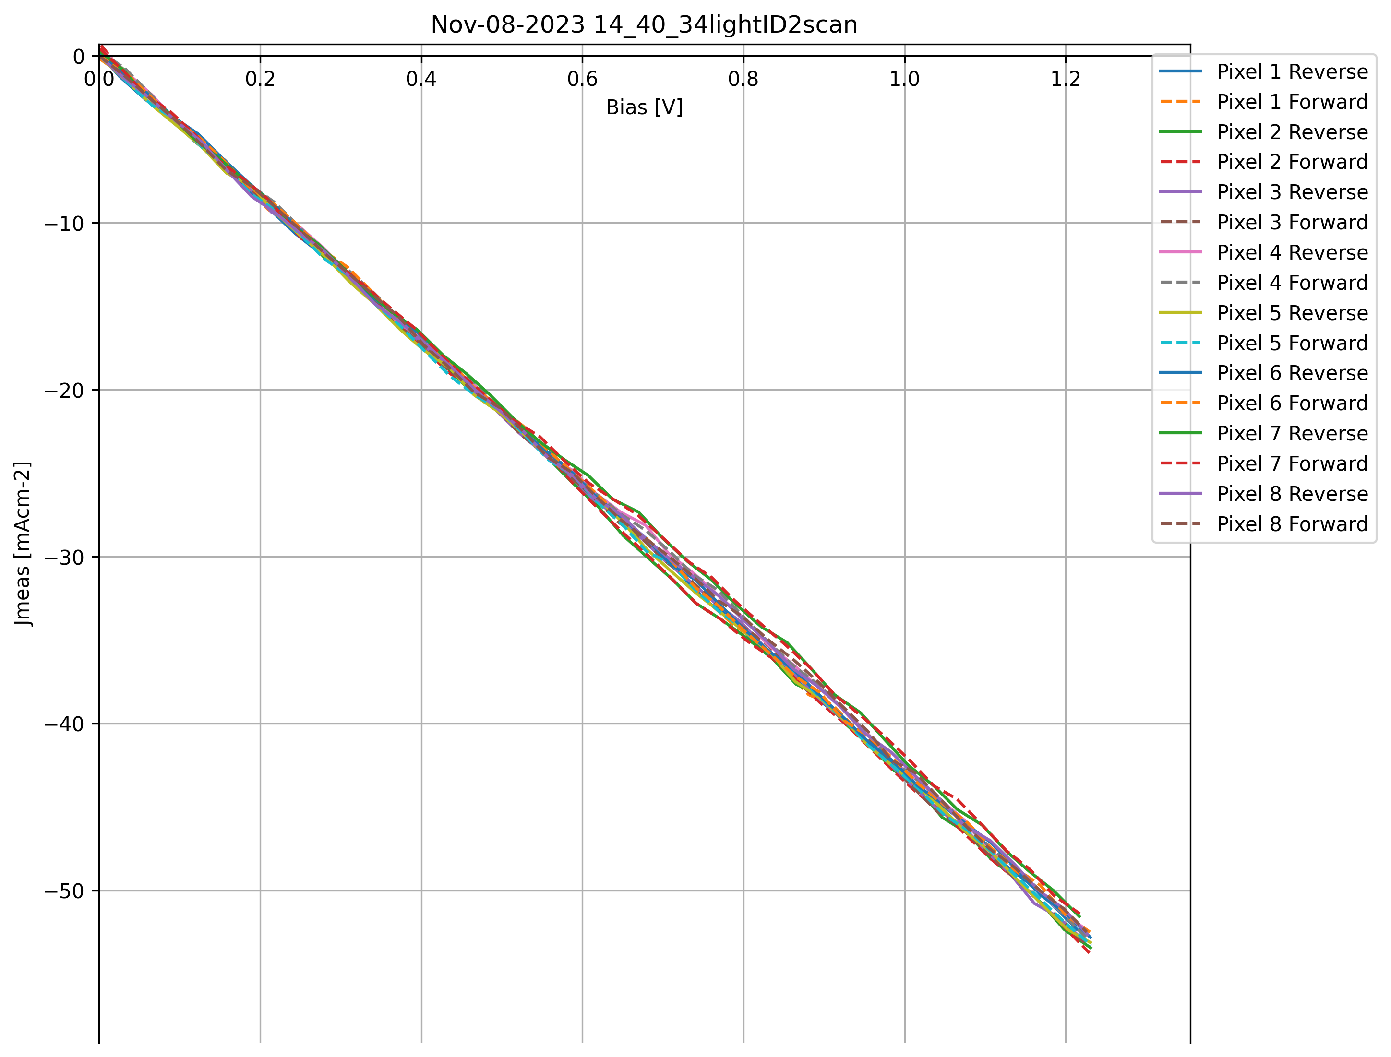
data/photodiodetest/100p/Nov-08-2023 14_40_34lightID2scan/Nov-08-2023 14_40_34lightID2scan.png
