AndChen153/Stability-Setup/data/photodiodetest/litos80p.png

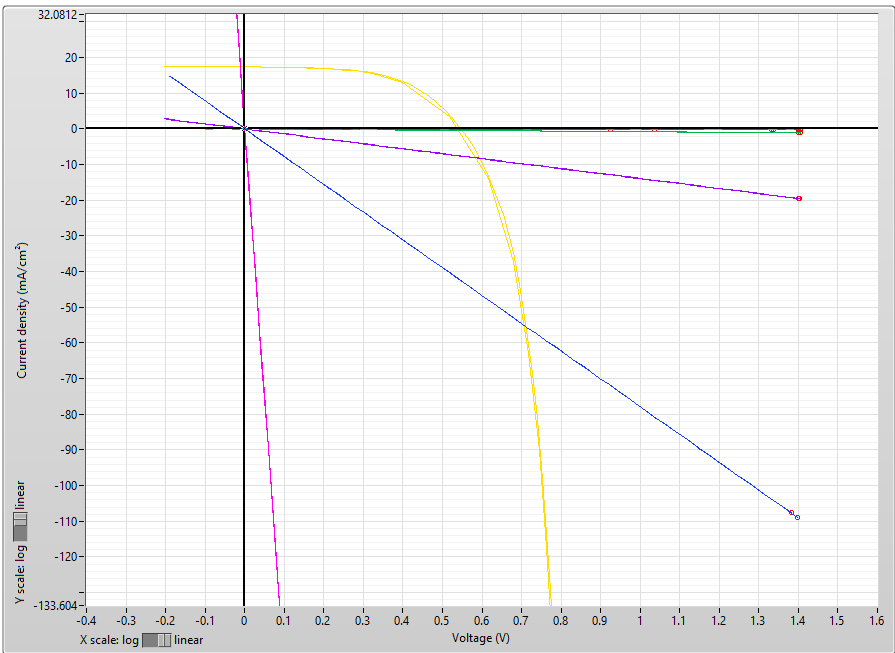
data/photodiodetest/litos80p.png
