AndChen153/Stability-Setup/data/photodiodetest/litos100p.png

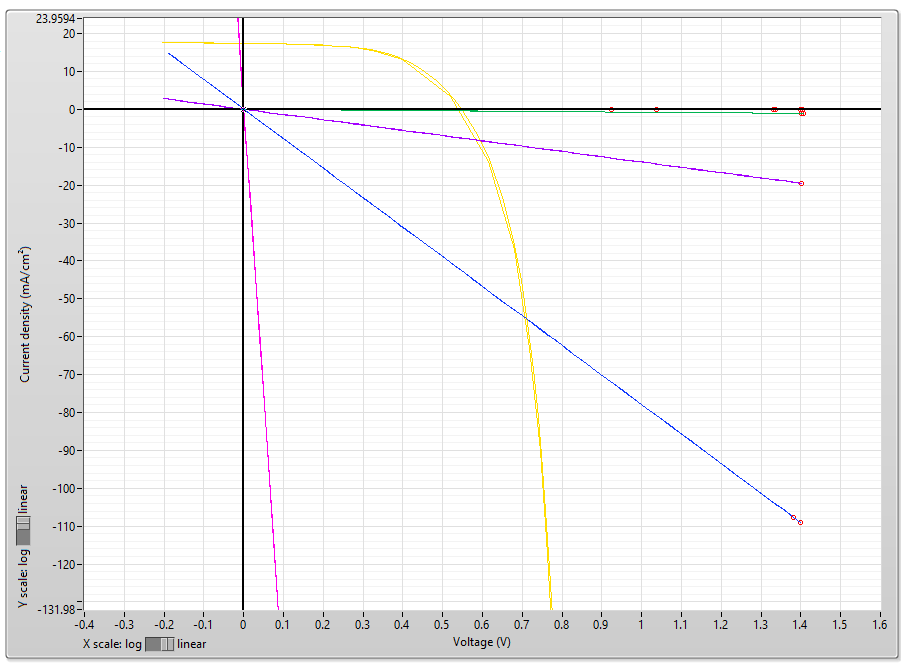
data/photodiodetest/litos100p.png
