AndChen153/Stability-Setup/data/photodiodetest/Litos_analyzed/0/photo - 0p_0.0Sun.png

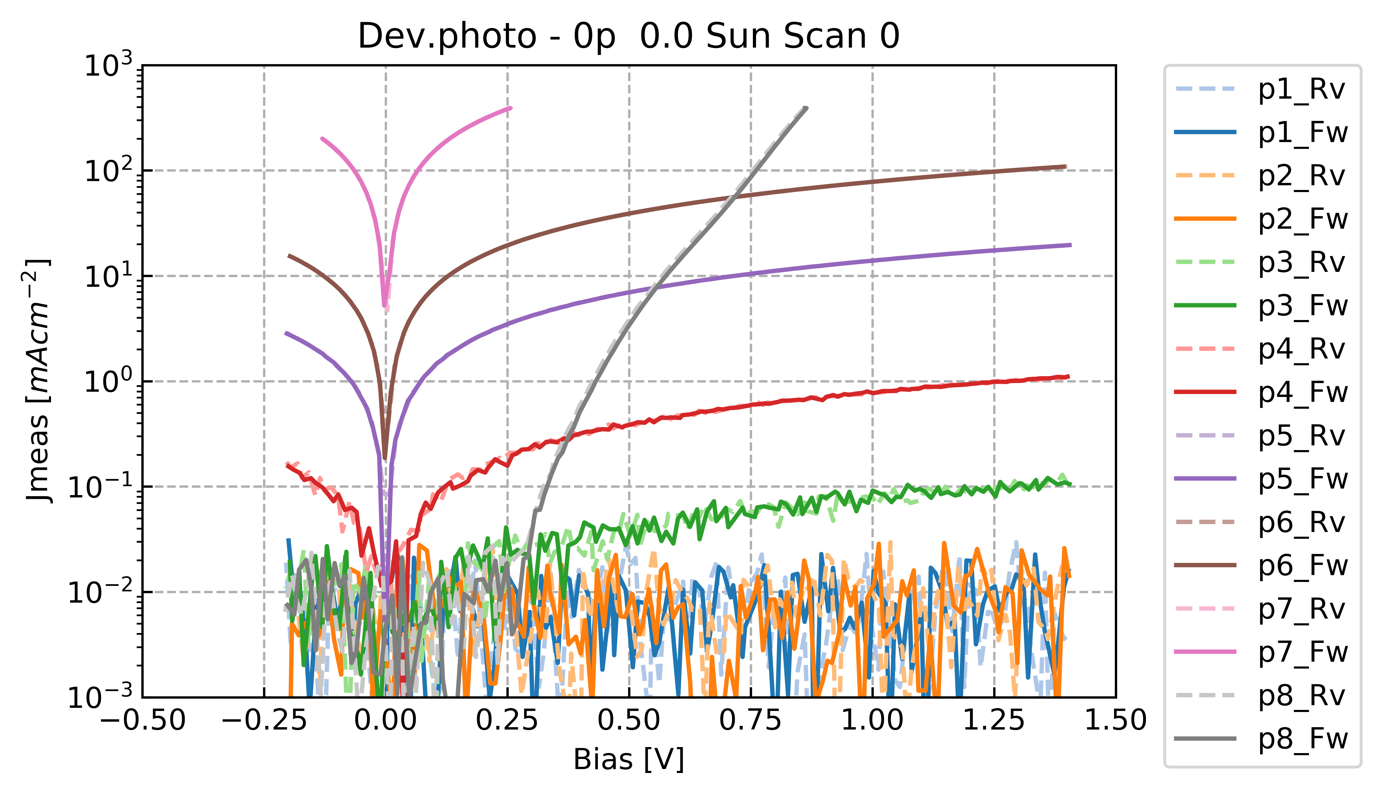
data/photodiodetest/Litos_analyzed/0/photo - 0p_0.0Sun.png
