AndChen153/Stability-Setup/data/photodiodetest/Litos_analyzed/20/Boxplot_Jsc_devices.png

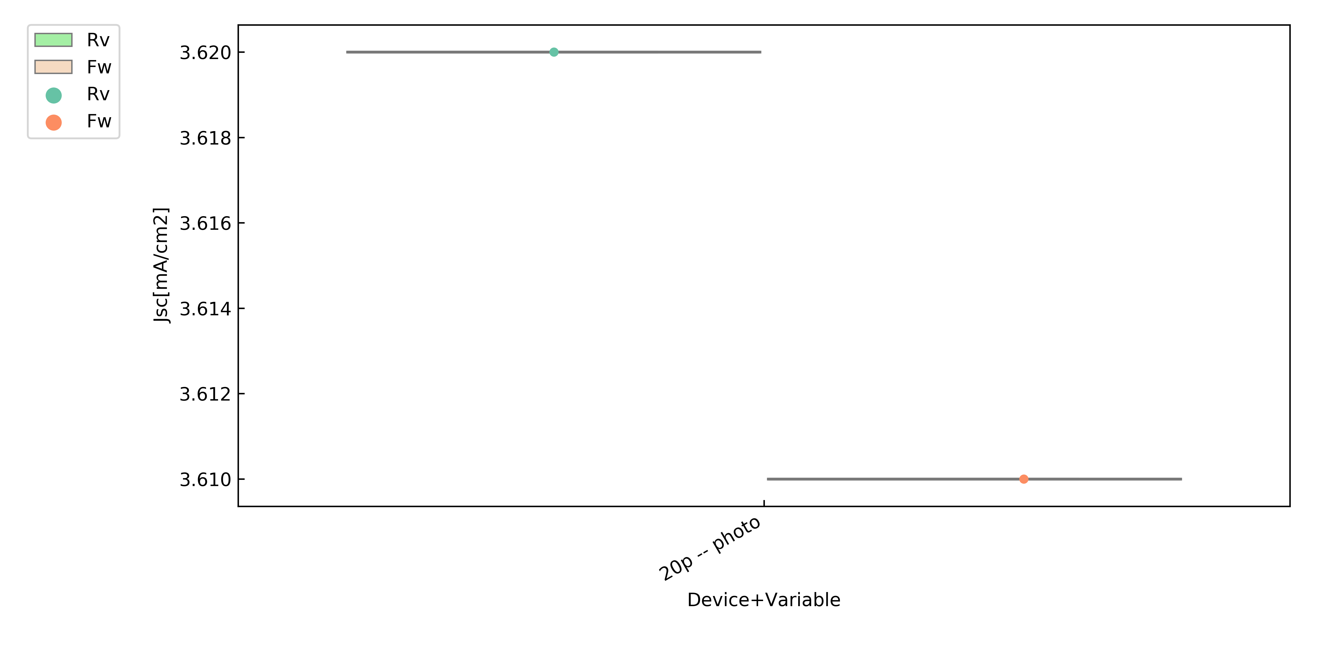
data/photodiodetest/Litos_analyzed/20/Boxplot_Jsc_devices.png
