AndChen153/Stability-Setup/data/photodiodetest/Litos_analyzed/20/Boxplot_Jsc_variables.png

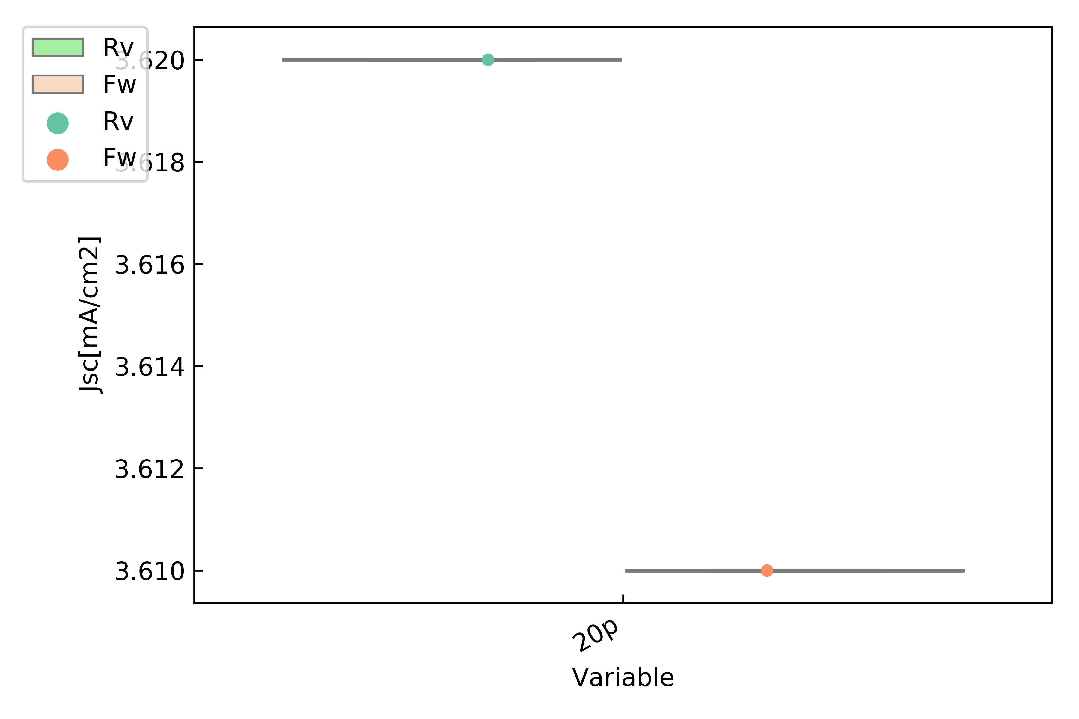
data/photodiodetest/Litos_analyzed/20/Boxplot_Jsc_variables.png
