AndChen153/Stability-Setup/data/photodiodetest/Litos_analyzed/20/Boxplot_Voc_variables.png

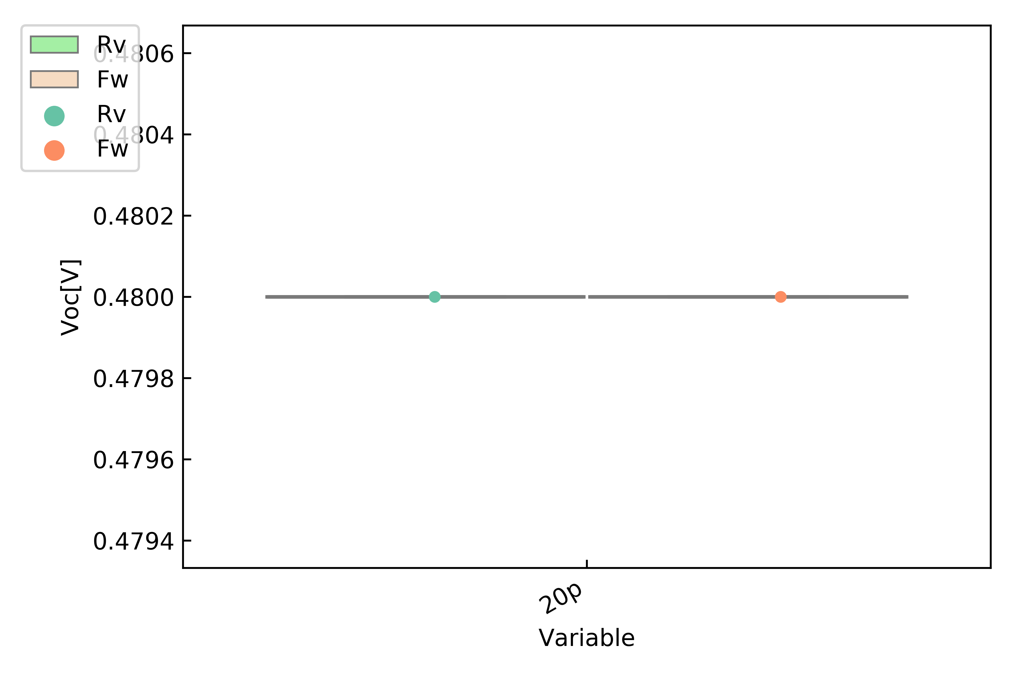
data/photodiodetest/Litos_analyzed/20/Boxplot_Voc_variables.png
