AndChen153/Stability-Setup/data/photodiodetest/Litos_analyzed/20/photo - 20p_0.2Sun.png

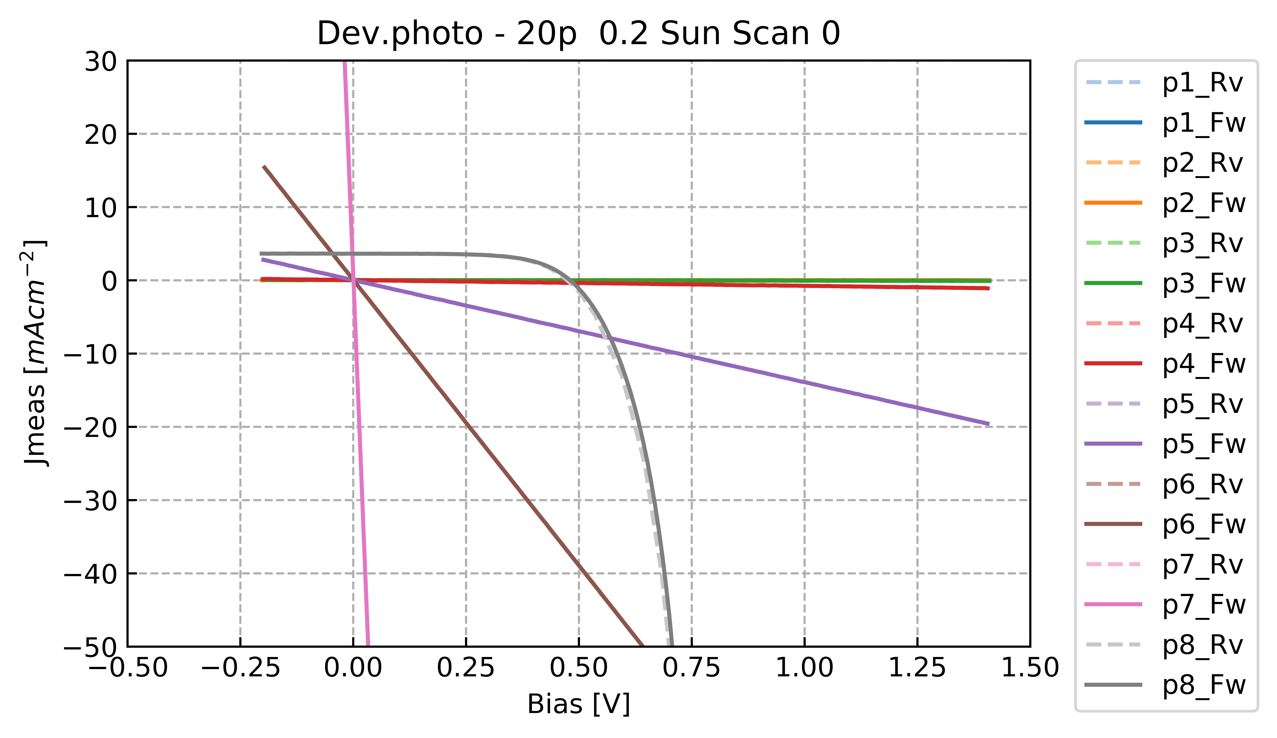
data/photodiodetest/Litos_analyzed/20/photo - 20p_0.2Sun.png
