AndChen153/Stability-Setup/data/photodiodetest/Litos_analyzed/20/Yield_per_device.png

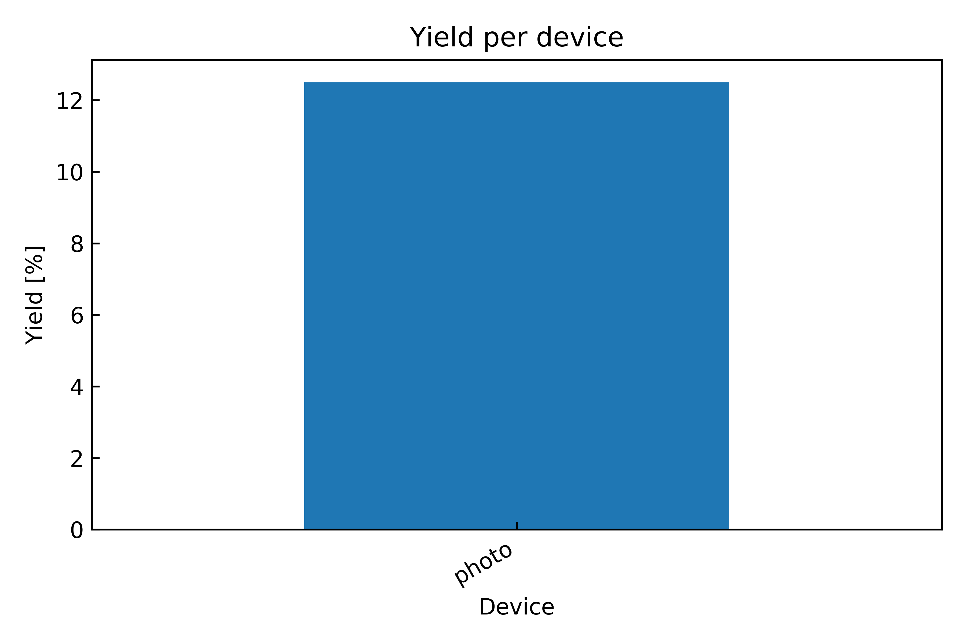
data/photodiodetest/Litos_analyzed/20/Yield_per_device.png
