AndChen153/Stability-Setup/data/photodiodetest/Litos_analyzed/80/photo - 80p_0.8Sun.png

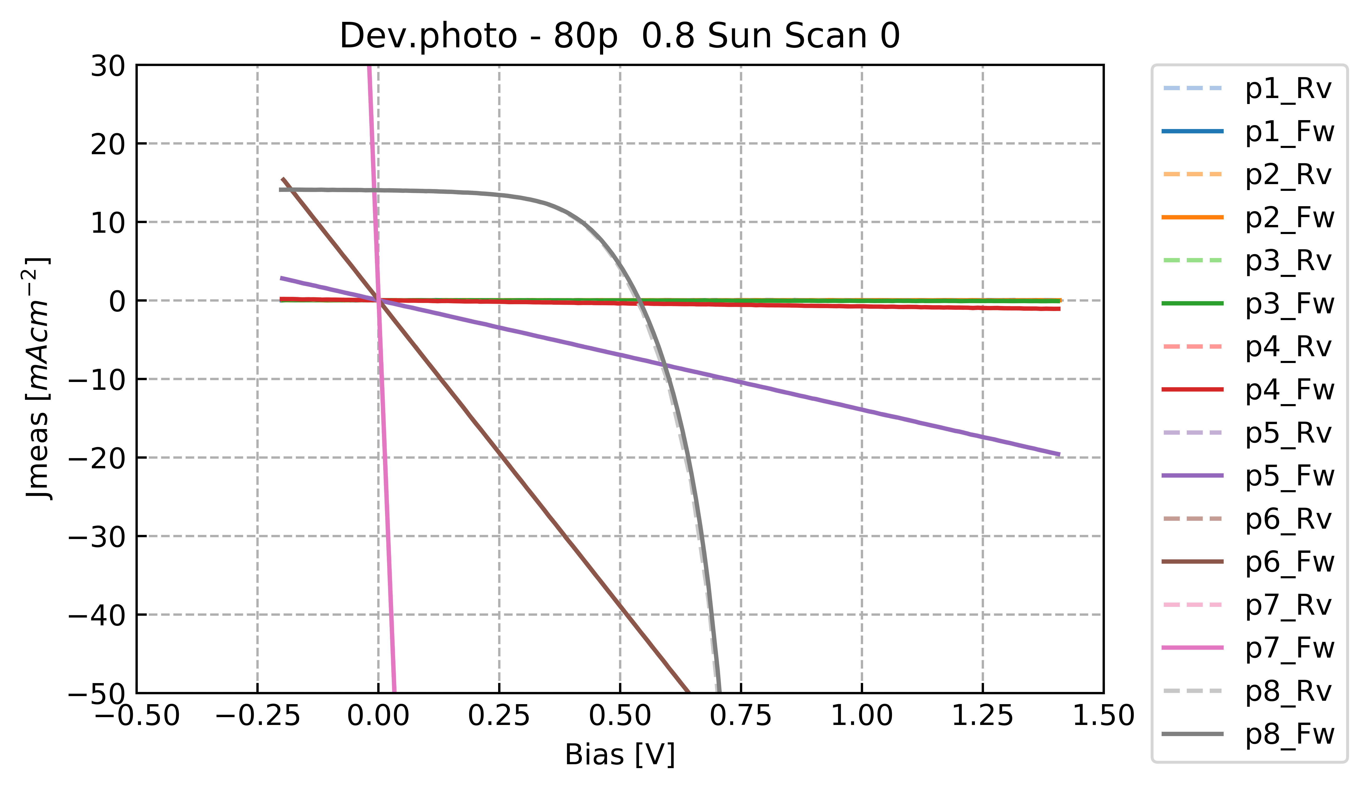
data/photodiodetest/Litos_analyzed/80/photo - 80p_0.8Sun.png
