AndChen153/Stability-Setup/mppt_timeseries_power.png

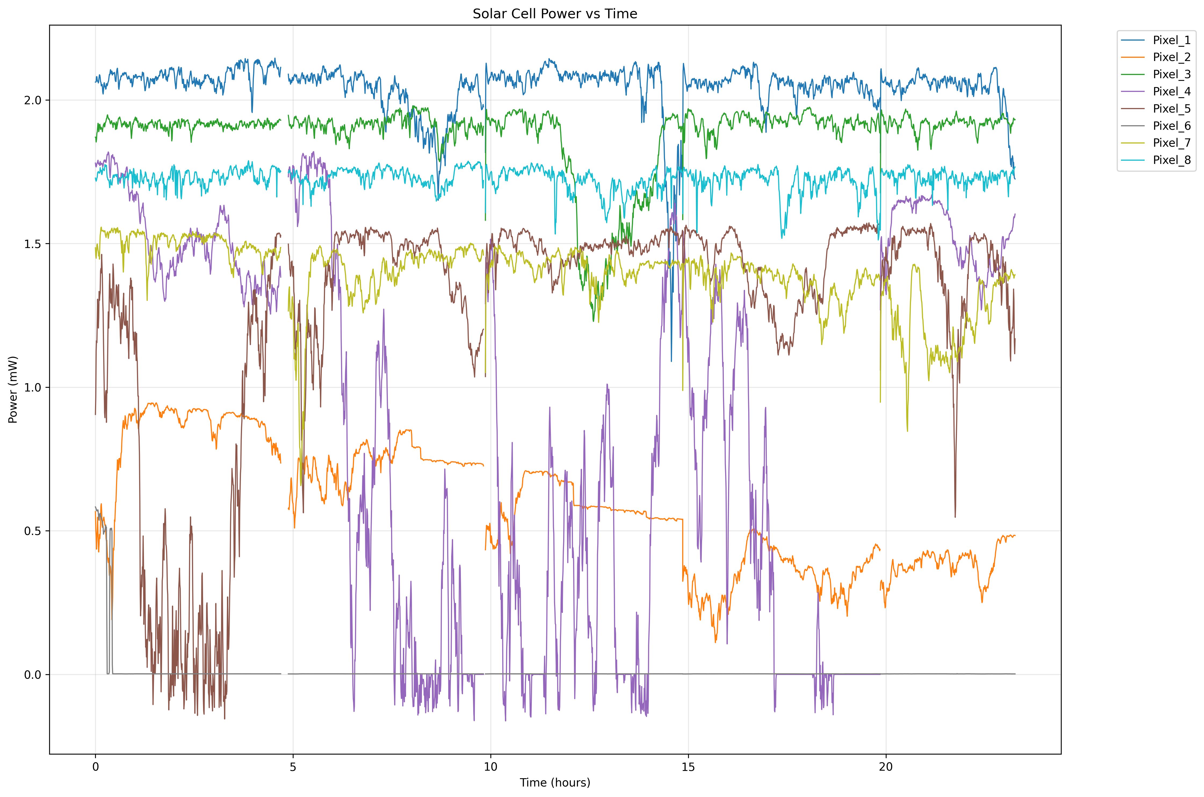
mppt_timeseries_power.png
