AndChen153/Stability-Setup/presentations/image.png

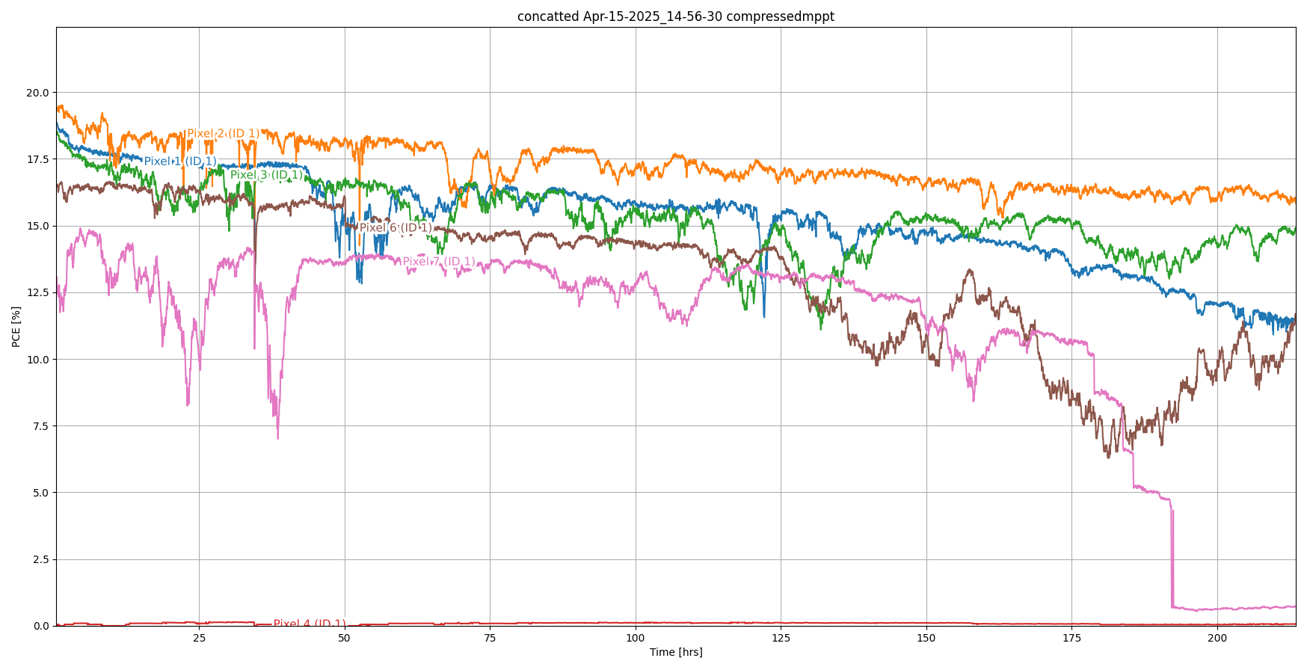
presentations/image.png
