AndChen153/Stability-Setup/pcb/BOM_stability_setup_1_1_2025-02-06.csv

ID | Name | Designator | Footprint | Quantity | Manufacturer Part | Manufacturer | Supplier | Supplier Part | Price
1 | 4.7kΩ | R1,R2 | R0603 | 2 | CRCW06034K70FKEA | VISHAY(威世) | LCSC | C844931 | 0.004
2 | 100nF | C1,C5,C8,C11,C14,C17,C20,C23,C3,C6,C9,C12,C15,C18,C21,C24 | C0603 | 16 | GRM188R71C104KA01D | muRata(村田) | LCSC | C45000 | 0.012
3 | 10uF | C2,C4,C7,C10,C13,C16,C19,C22 | C0805 | 8 | GRM21BR71A106KE51L | muRata(村田) | LCSC | C86038 | 0.029
4 | MCP4725A0T-E/CH | P0,P1 | SOT-23-6_L2.9-W1.6-P0.95-LS2.8-BL | 2 | MCP4725A0T-E/CH | MICROCHIP(美国微芯) | LCSC | C144198 | 0.848
5 | MCP4725A1T-E/CH | P2,P3 | SOT-23-6_L2.9-W1.6-P0.95-LS2.8-BR | 2 | MCP4725A1T-E/CH | MICROCHIP(美国微芯) | LCSC | C61423 | 1.552
6 | MCP4725A2T-E/CH | P4,P5 | SOT-23-6_L2.9-W1.6-P0.95-LS2.8-BR | 2 | MCP4725A2T-E/CH | MICROCHIP(美国微芯) | LCSC | C623439 | 2.327
7 | MCP4725A3T-E/CH | P6,P7 | SOT-23-6_L2.9-W1.6-P0.95-LS2.8-BR | 2 | MCP4725A3T-E/CH | MICROCHIP(美国微芯) | LCSC | C623440 | 2.806
8 | MCP1702T-3302E/CB | V1 | SOT-23-3_L2.9-W1.3-P1.90-LS2.4-BR | 1 | MCP1702T-3302E/CB | MICROCHIP(美国微芯) | LCSC | C33844 | 0.531
9 | 0527461671 | FPC1 | FPC-SMD_16P-P0.50_MOLEX_0527461671 | 1 | 0527461671 | MOLEX | LCSC | C3169781 | 0.671
10 | INA219BIDCNT | I0,I1,I2,I3,I4,I5,I6,I7 | SOT-23-8_L2.9-W1.6-P0.65-LS2.8-BR | 8 | INA219BIDCNT | TI(德州仪器) | LCSC | C2653868 | 2.11
11 | 10Ω | R3,R4,R5,R6,R7,R8,R9,R10 | R0603 | 8 | RT0603BRD0710RL | YAGEO(国巨) | LCSC | C861082 | 0.024
12 | ARDUINO_NANO_Every | U1 | COMM-TH_ARDUINO_NANO | 1 | ARDUINO_NANO | null | LCSC | C9900017879
