AndChen153/Stability-Setup/Stability-Setup_Python/data_visualization/Example Auto PPT.pptx

## Example Auto PPT

Andrew Chen

## PnO Measurement Conditions

- Voltage Range: 0.9
- Voltage Step Size: 0.01
- Voltage Read Count: 5
- Voltage Delay Time: 20
- Voltage Measurement Time: 6

## Averaged PNO Traces (no dead cells)


## Scan params

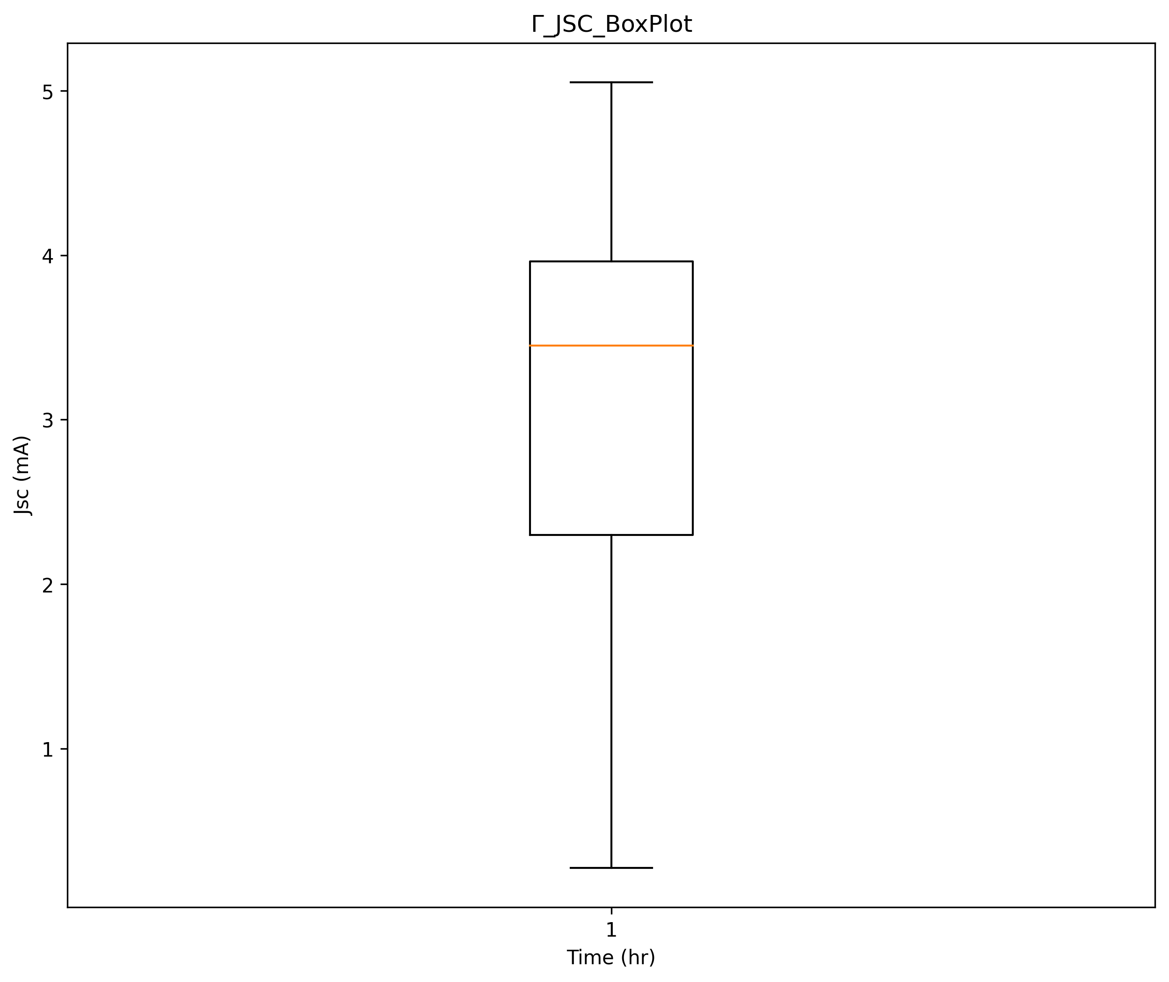
[picture p84: figure]

## Dark JV Before | Dark JV After

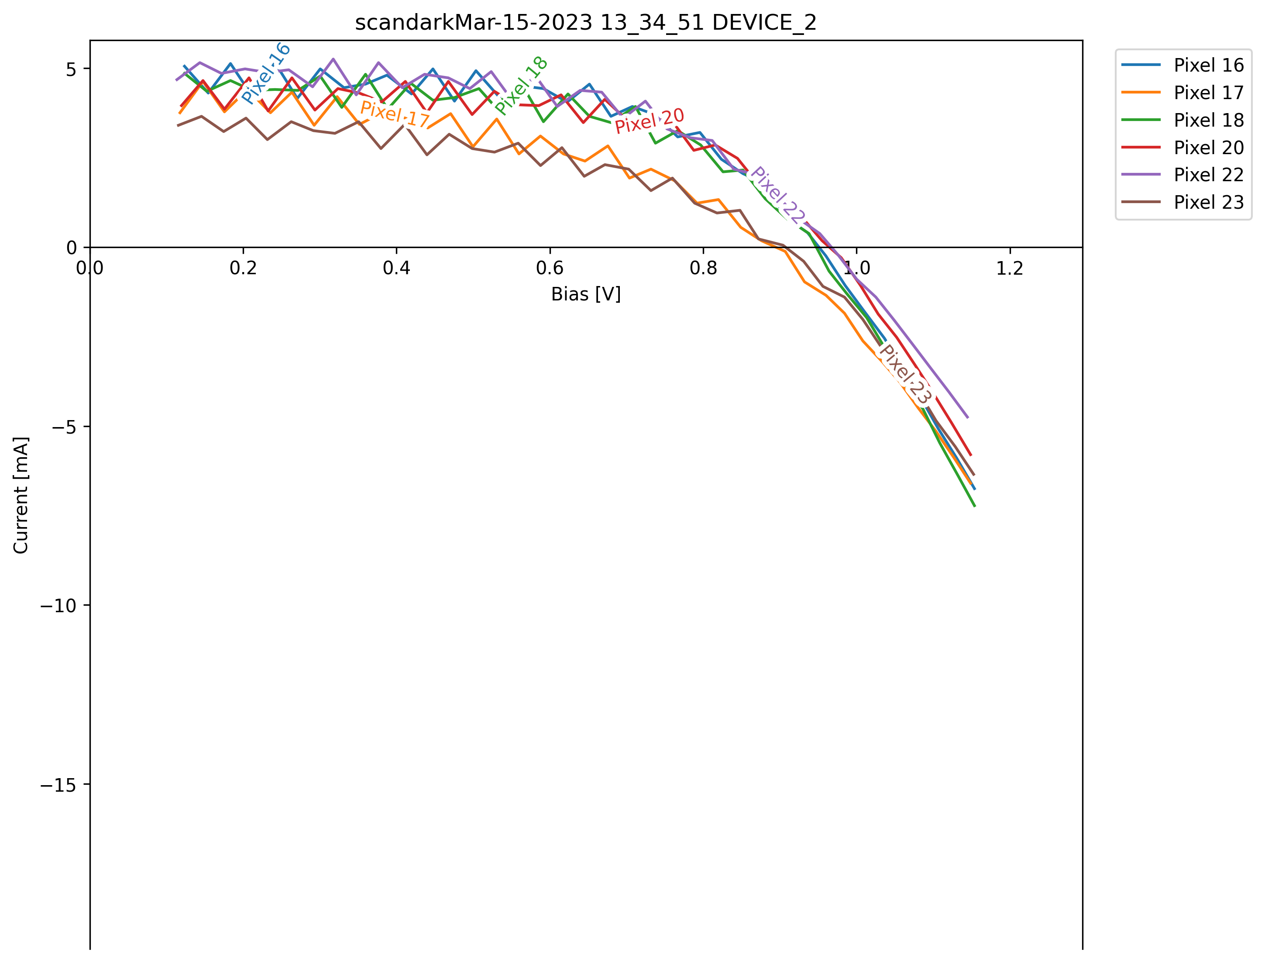
[picture p85: figure]

## Light JV Before | Light JV After

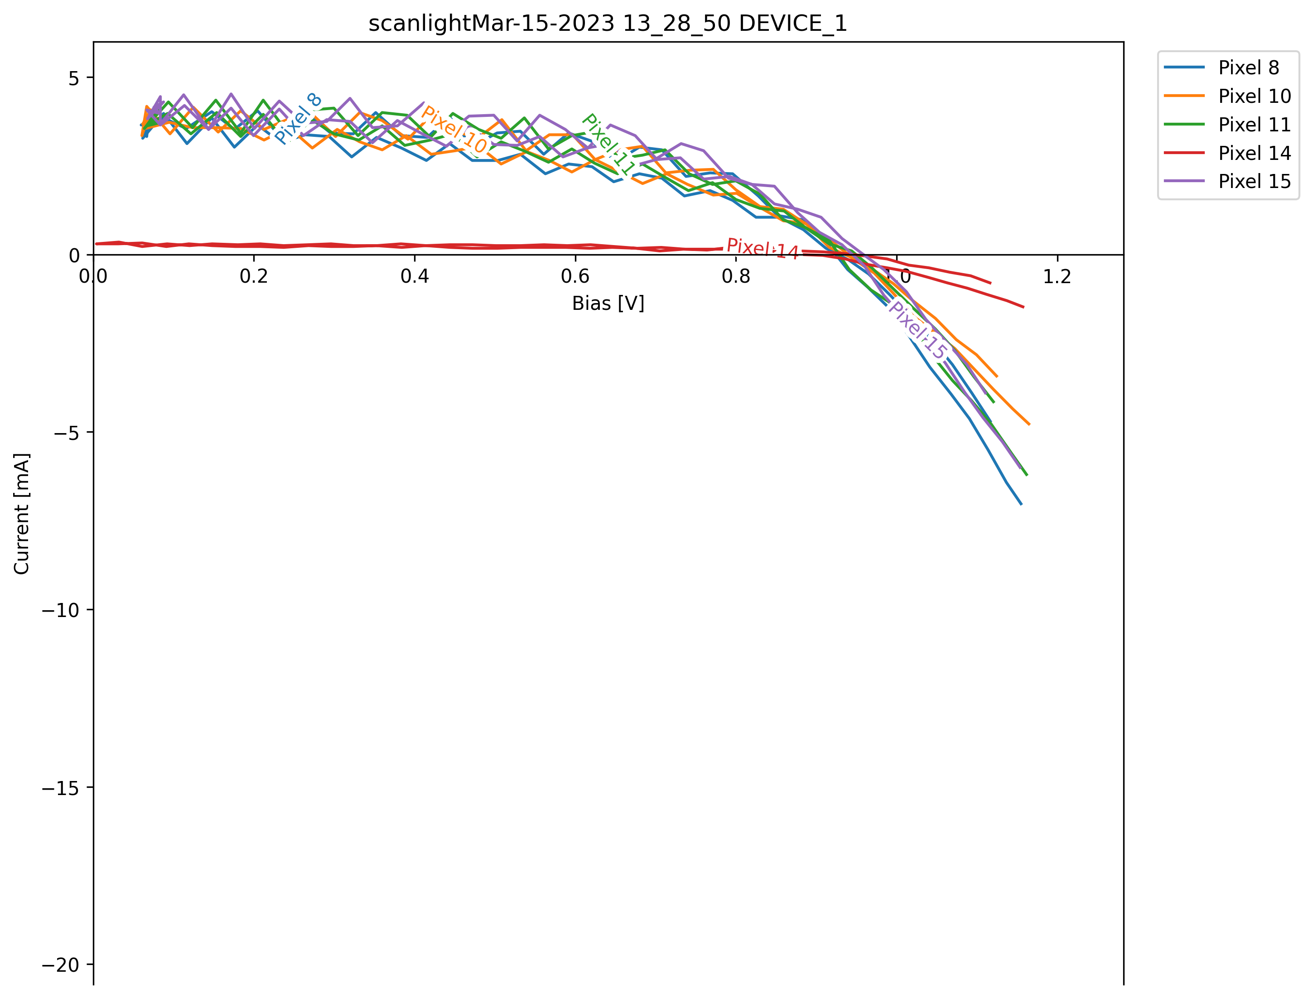
[picture p86: figure]
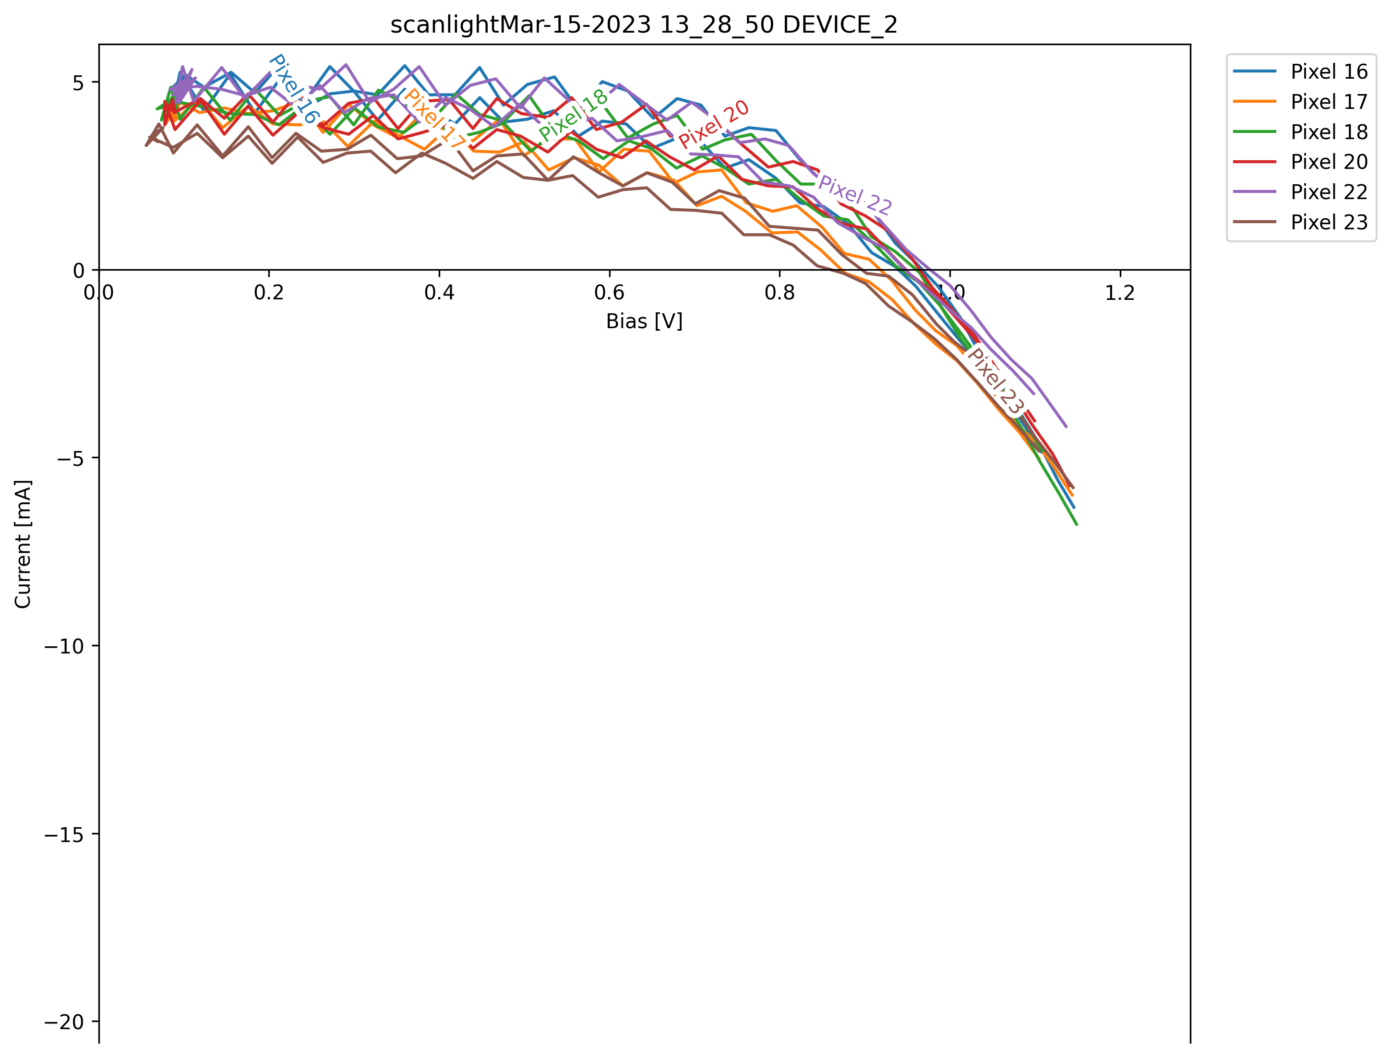
[picture p87: figure]
