AndChen153/Stability-Setup/pcb/old/Gerber_PCB_stabilitySetup1_0_2/How-to-order-PCB.txt

How to Order PCB

Please refer to:
https://docs.easyeda.com/en/PCB/Order-PCB
