AndChen153/Stability-Setup/Stability-Setup_Python/assets/delete.png

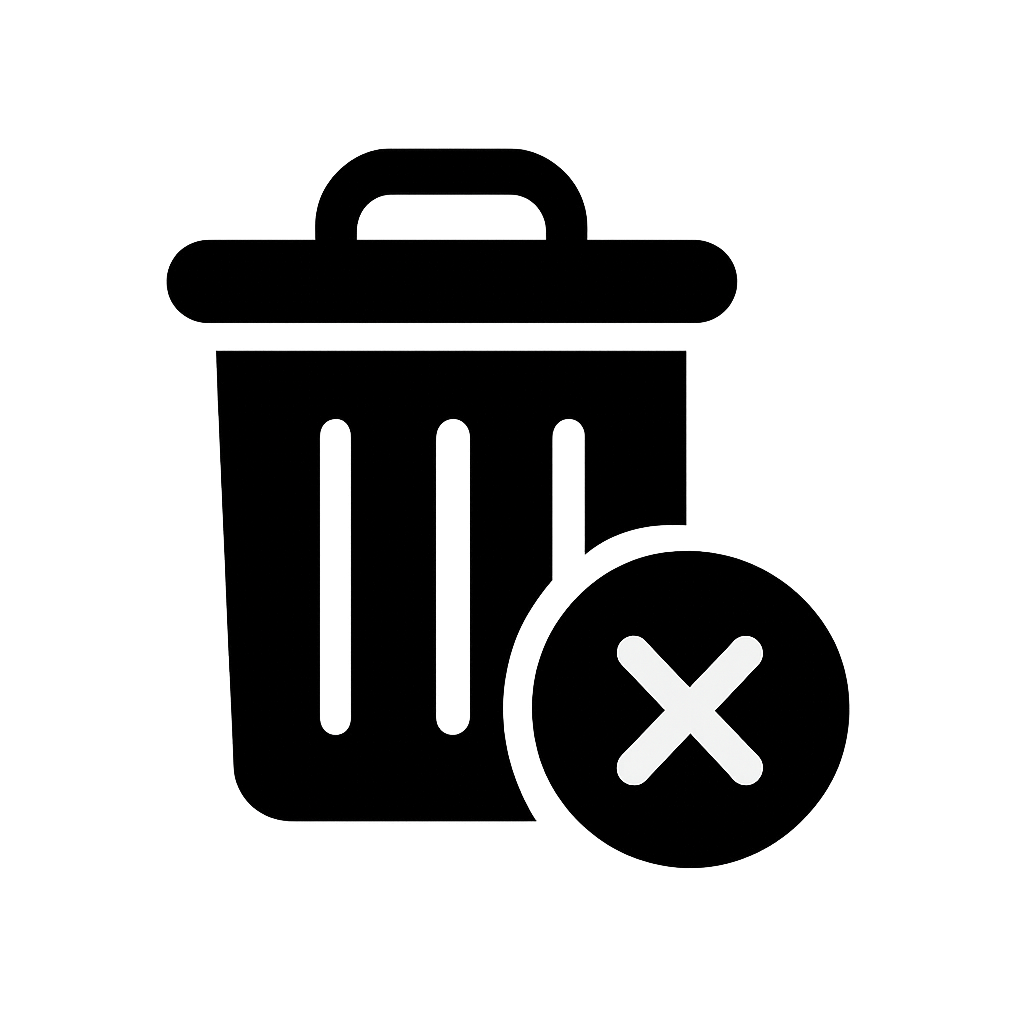
Stability-Setup_Python/assets/delete.png
