AndChen153/Stability-Setup/Stability-Setup_Python/assets/edit.png

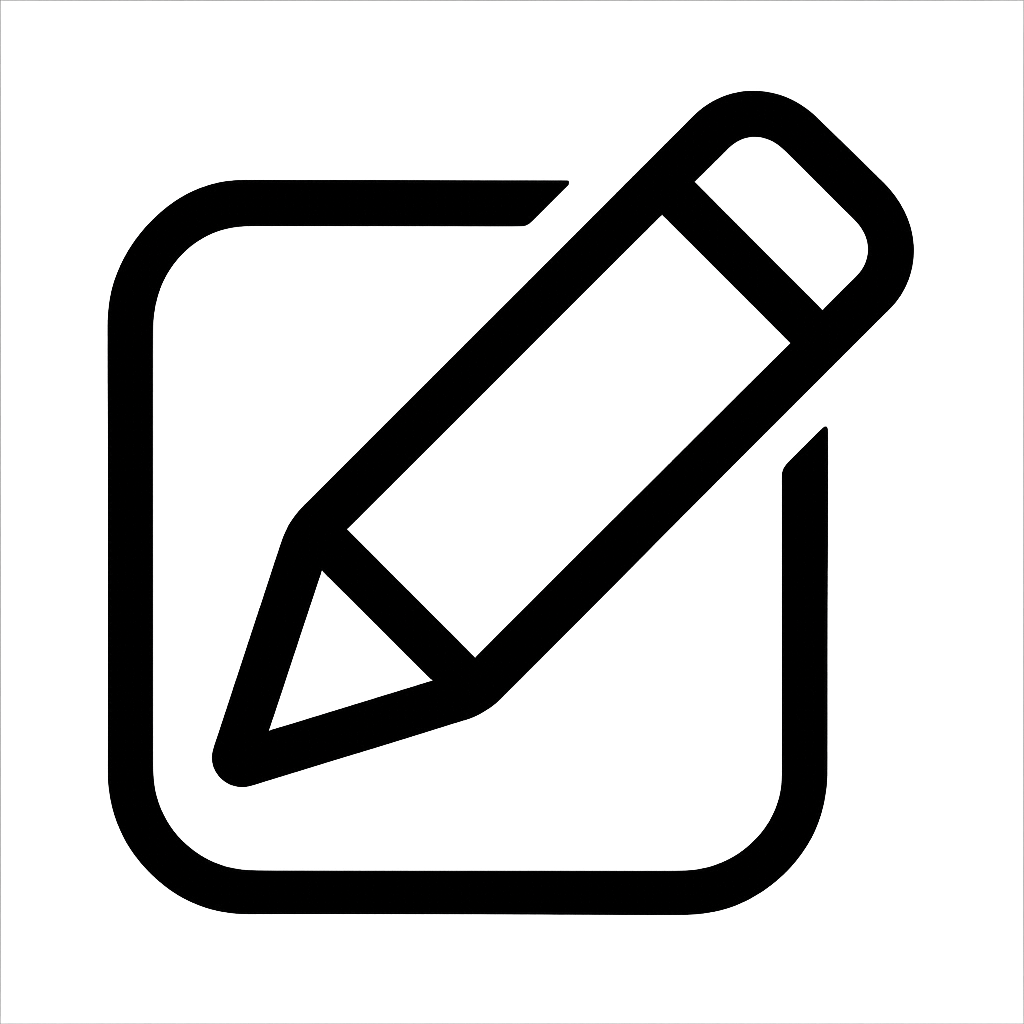
Stability-Setup_Python/assets/edit.png
