AndChen153/Stability-Setup/Stability-Setup_Python/assets/start.png

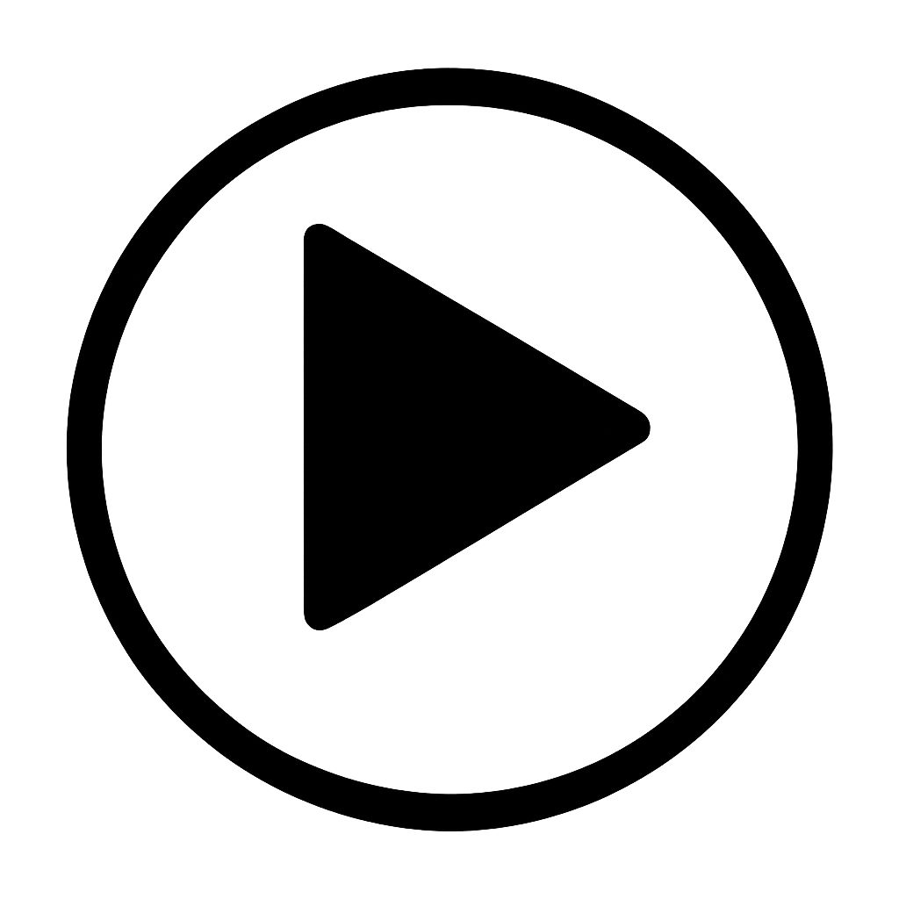
Stability-Setup_Python/assets/start.png
