AndChen153/Stability-Setup/Stability-Setup_Python/data_visualization/Comparison_FF_BoxPlot.png

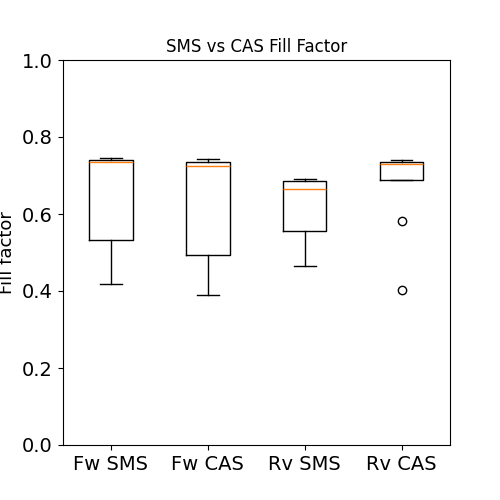
Stability-Setup_Python/data_visualization/Comparison_FF_BoxPlot.png
