AndChen153/Stability-Setup/Stability-Setup_Python/data_visualization/Comparison_PCE_BoxPlot.png

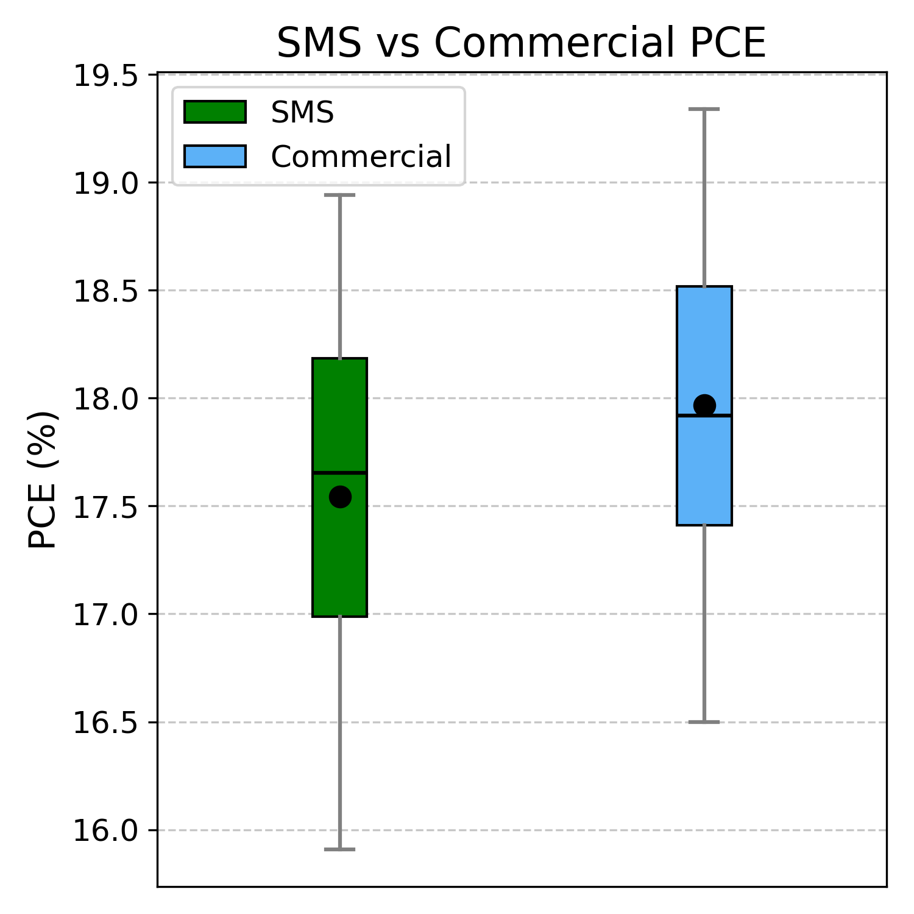
Stability-Setup_Python/data_visualization/Comparison_PCE_BoxPlot.png
