AndChen153/Stability-Setup/Stability-Setup_Python/data_visualization/JV_Plot.png

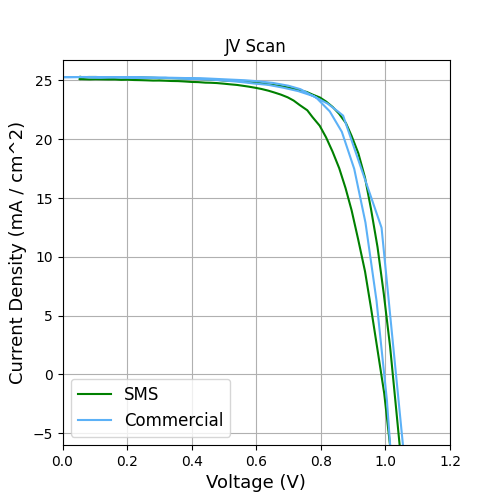
Stability-Setup_Python/data_visualization/JV_Plot.png
