AndChen153/Stability-Setup/Stability-Setup_Python/data_visualization/mppt_power_comparison.png

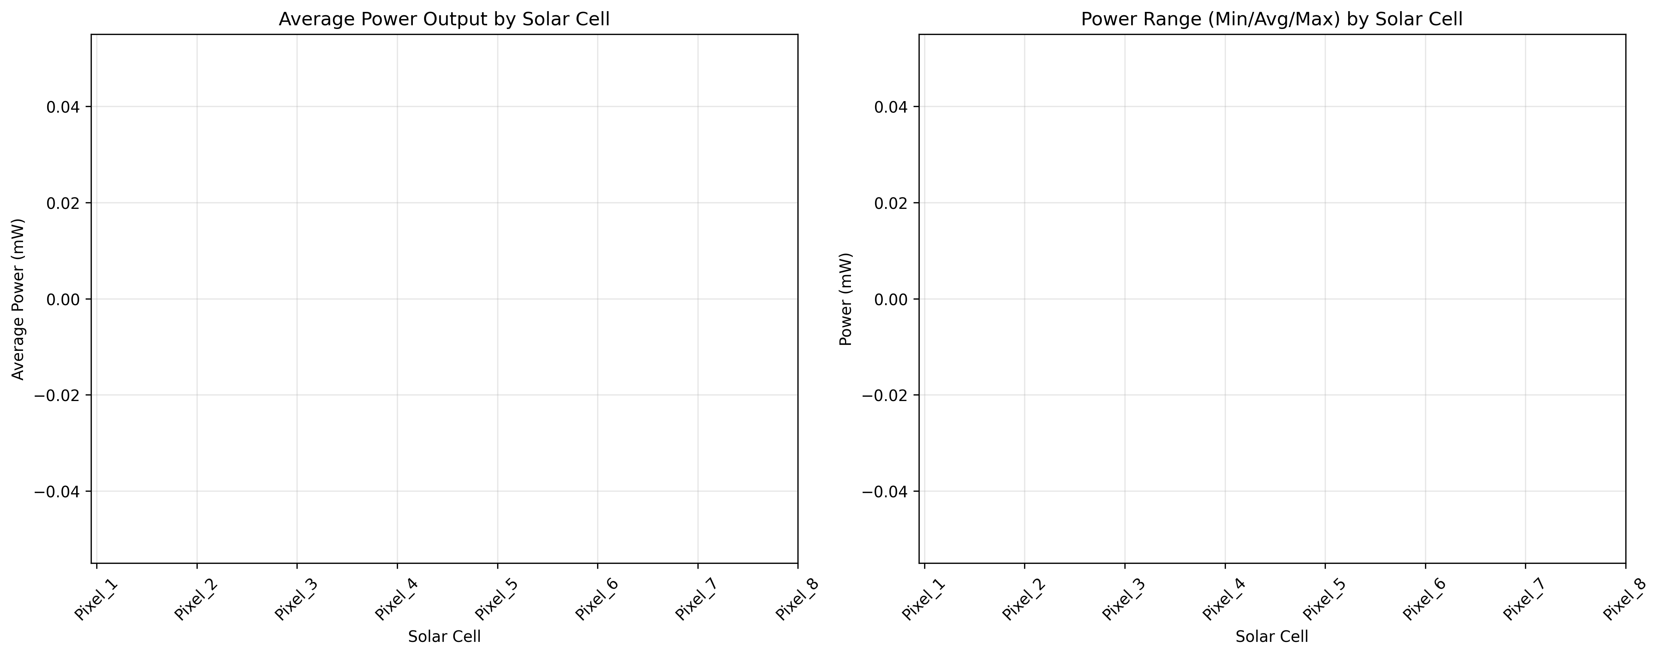
Stability-Setup_Python/data_visualization/mppt_power_comparison.png
