AndChen153/Stability-Setup/Stability-Setup_Python/data_visualization/mppt_timeseries_voltage.png

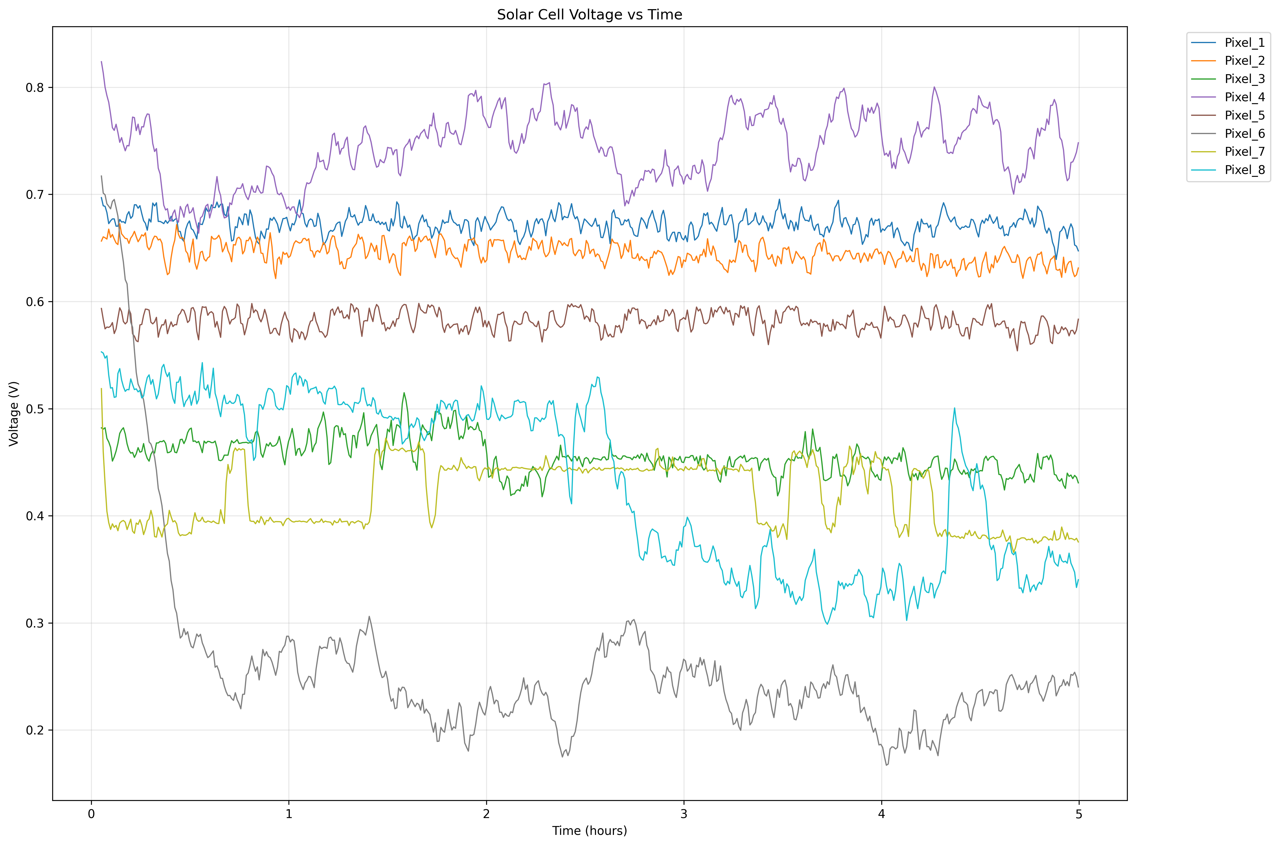
Stability-Setup_Python/data_visualization/mppt_timeseries_voltage.png
