AndChen153/Stability-Setup/Stability-Setup_Python/data_visualization/styled_boxplot.png

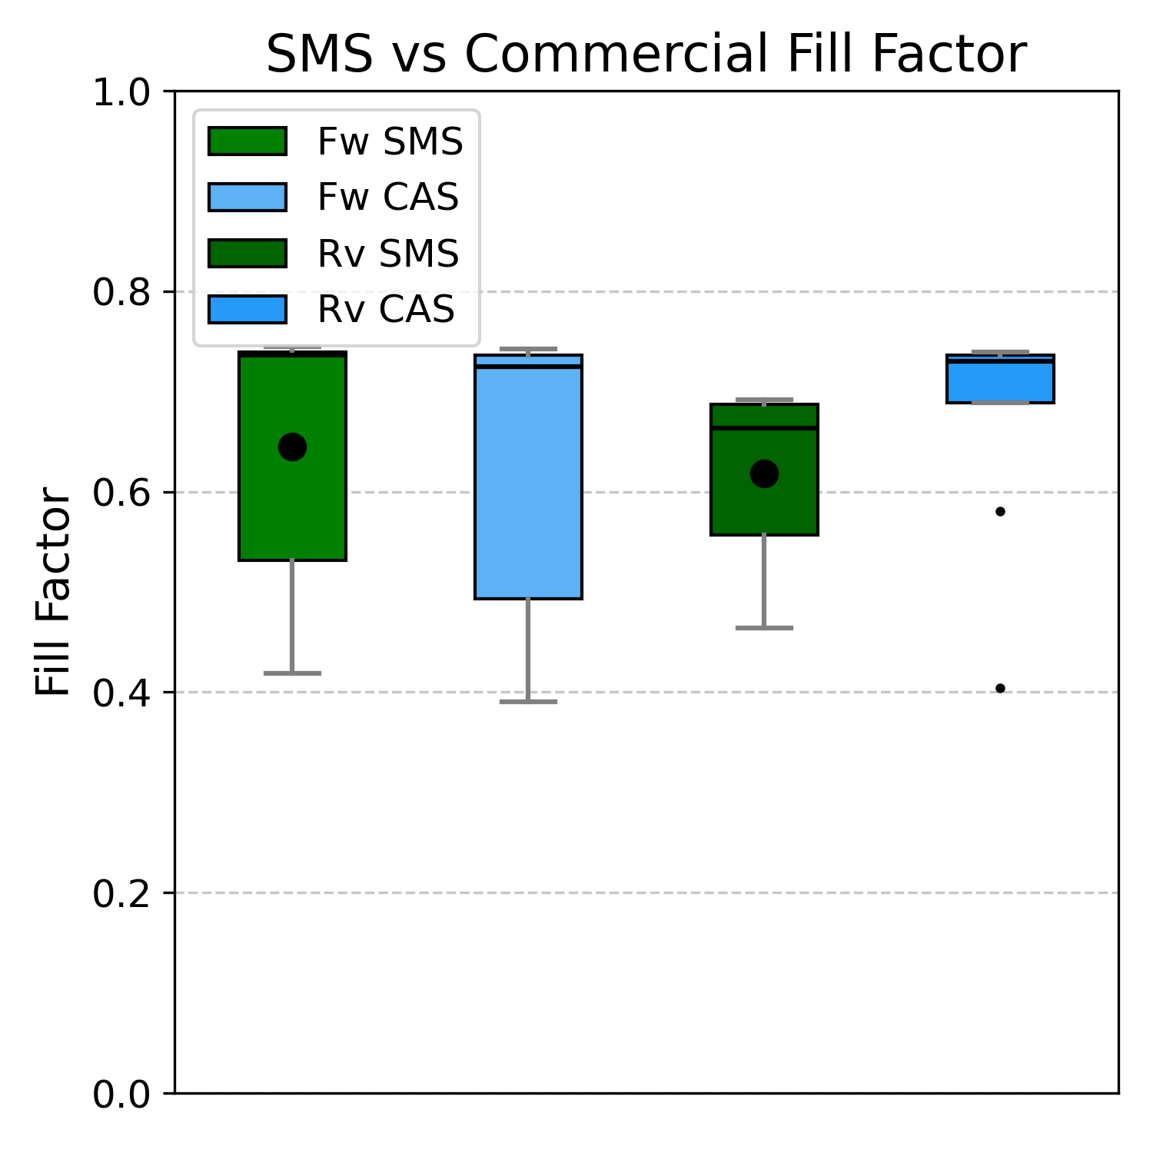
Stability-Setup_Python/data_visualization/styled_boxplot.png
