AndChen153/Stability-Setup/data/Sept 9 MPPT 8 Pixel test/2022.09.09 - Batch#17_MPPTTEST/2022-09-09 -- Batch12_MPPTTEST Charts/2022-09-09 -- Batch12_MPPTTEST.pptx

## Batch12_MPPTTEST

2022/09/09

## Slide 2

# | Variable

SK17 | MPPTTEST

Au

spiro-OMeTAD

Cs0.05FA0.79MA0.16PbI2.49Br0.51

TiO2-c | TiO2-mp

Substrate | FTO

Au

## Slide 3

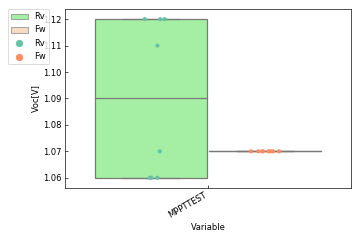
[picture p111: figure]
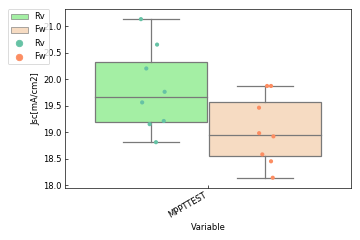
[picture p112: figure]
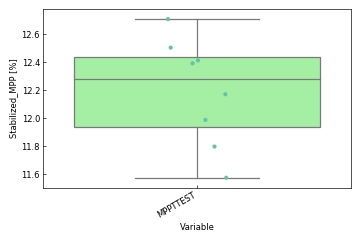
[picture p113: figure]
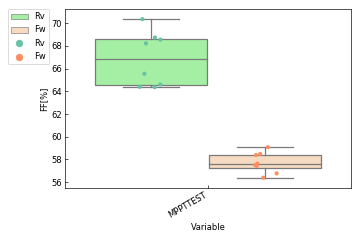
[picture p114: figure]
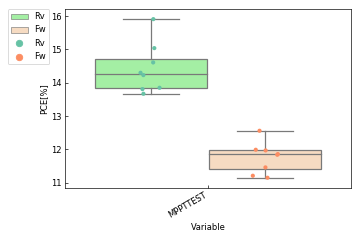
[picture p115: figure]

## Slide 4

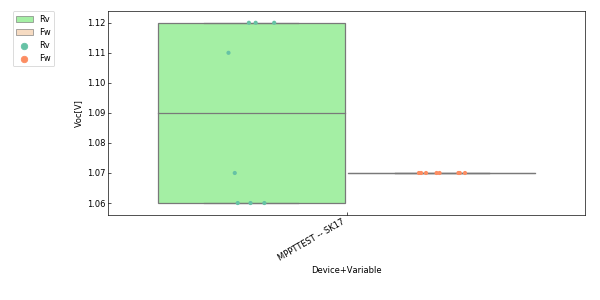
[picture p116: figure]
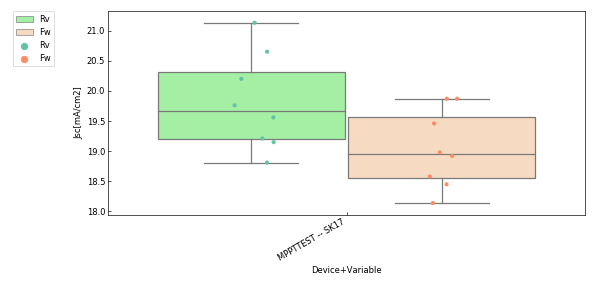
[picture p117: figure]
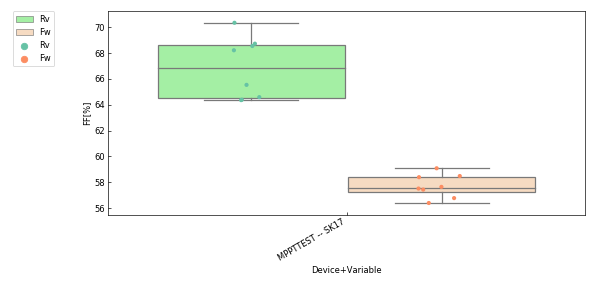
[picture p118: figure]
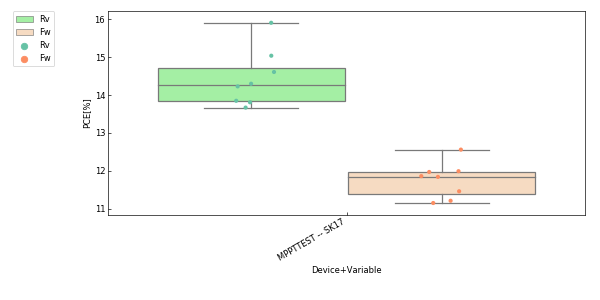
[picture p119: figure]

## Slide 5

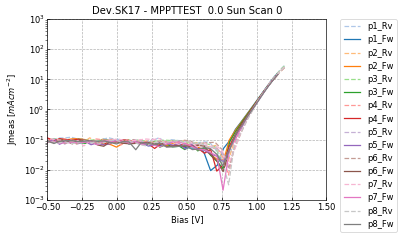
[picture p120: figure]

## Slide 6

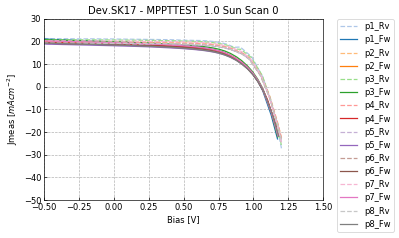
[picture p121: figure]

## Slide 7

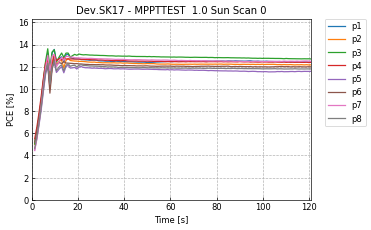
[picture p122: figure]
