AndChen153/Stability-Setup/data/Sept 9 MPPT 8 Pixel test/MPPTComparison.xlsx

Time | Pixel 0 | Pixel 1 | Pixel 2 | Pixel 3 | Pixel 4 | Pixel 5 | Pixel 6 | Pixel 7 |  |  |  |  |  |  |  |  |  |  | Volts_output | Pixel 0 mA |  | Pixel 1 mA |  | Pixel 2 mA |  | Pixel 3 mA |  | Pixel 4 mA |  | Pixel 5 mA |  | Pixel 6 mA |  | Pixel 7 mA
1.220272 | 4.980941 | 5.041543 | 5.504957 | 4.485132 | 4.48513152 | 5.194197757 | 4.436014866 | 4.646511872 |  |  |  |  |  |  |  |  |  |  | 1.2 | -4.5 | -35.15625 | -3.925 | -30.6640625 | -4.3 | -33.59375 | -3.9 | -30.46875 | -3.075 | -24.0234375 | -2.95 | -23.046875 | -3.3 | -25.78125 | -3.2 | -25
2.180213 | 6.022859 | 6.129665 | 6.568499 | 5.496738 | 5.49673779 | 6.224072832 | 5.561044212 | 5.674124082 |  |  |  |  |  |  |  |  |  |  | 1.17 | -3.525 | -27.5390625 | -3.175 | -24.8046875 | -3.4 | -26.5625 | -3.15 | -24.609375 | -2.425 | -18.9453125 | -2.325 | -18.1640625 | -2.6 | -20.3125 | -2.65 | -20.703125
3.117598 | 7.340737 | 7.500714 | 7.900295 | 6.772249 | 6.772249194 | 7.517077049 | 6.960060658 | 6.94491618 |  |  |  |  |  |  |  |  |  |  | 1.14 | -2.625 | -20.5078125 | -2.4 | -18.75 | -2.55 | -19.921875 | -2.4 | -18.75 | -1.75 | -13.671875 | -1.7 | -13.28125 | -1.95 | -15.234375 | -2 | -15.625
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
