AndChen153/Stability-Setup/data/Nov-4-good-tests/PCB/PnONov-04-2022 15_24_06.png

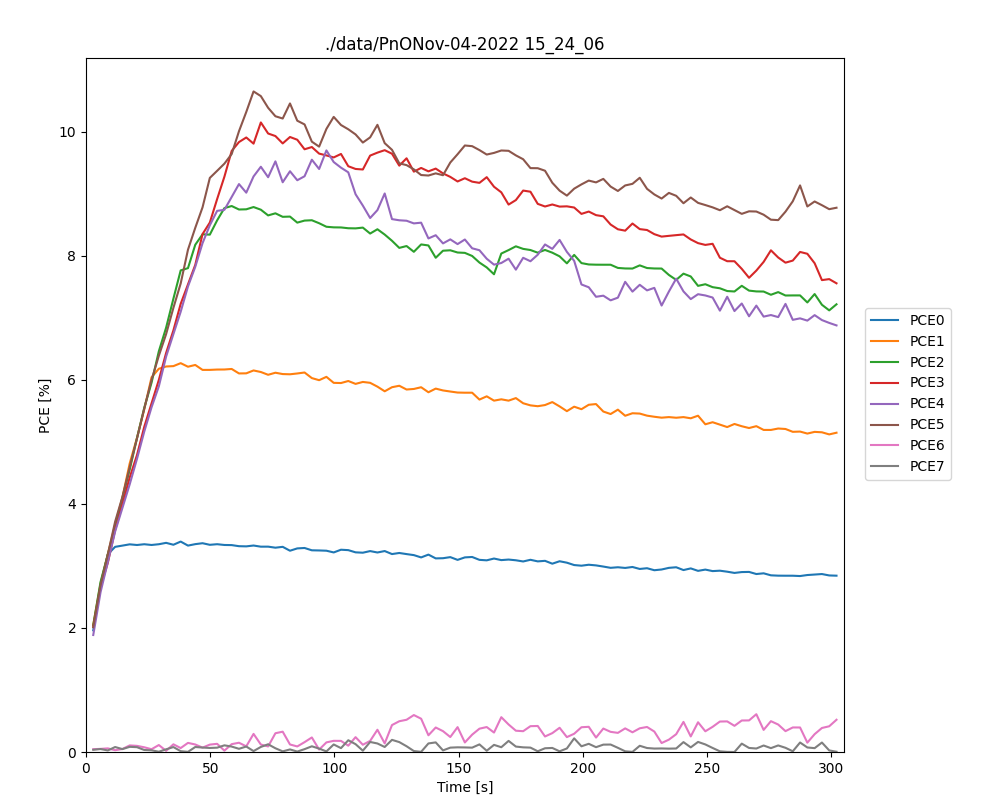
data/Nov-4-good-tests/PCB/PnONov-04-2022 15_24_06.png
