AndChen153/Stability-Setup/data/Nov-4-good-tests/PCB/scandarkNov-04-2022 14_33_54.png

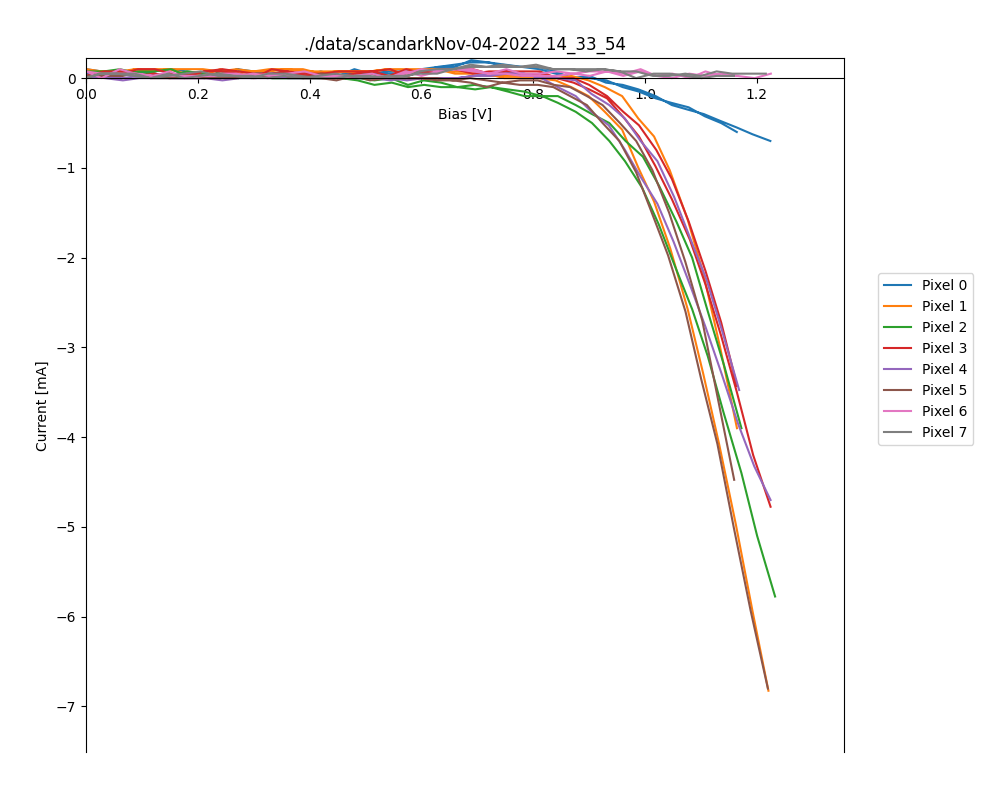
data/Nov-4-good-tests/PCB/scandarkNov-04-2022 14_33_54.png
