AndChen153/Stability-Setup/data/Nov-4-good-tests/PCB/scanlightNov-04-2022 14_35_24.png

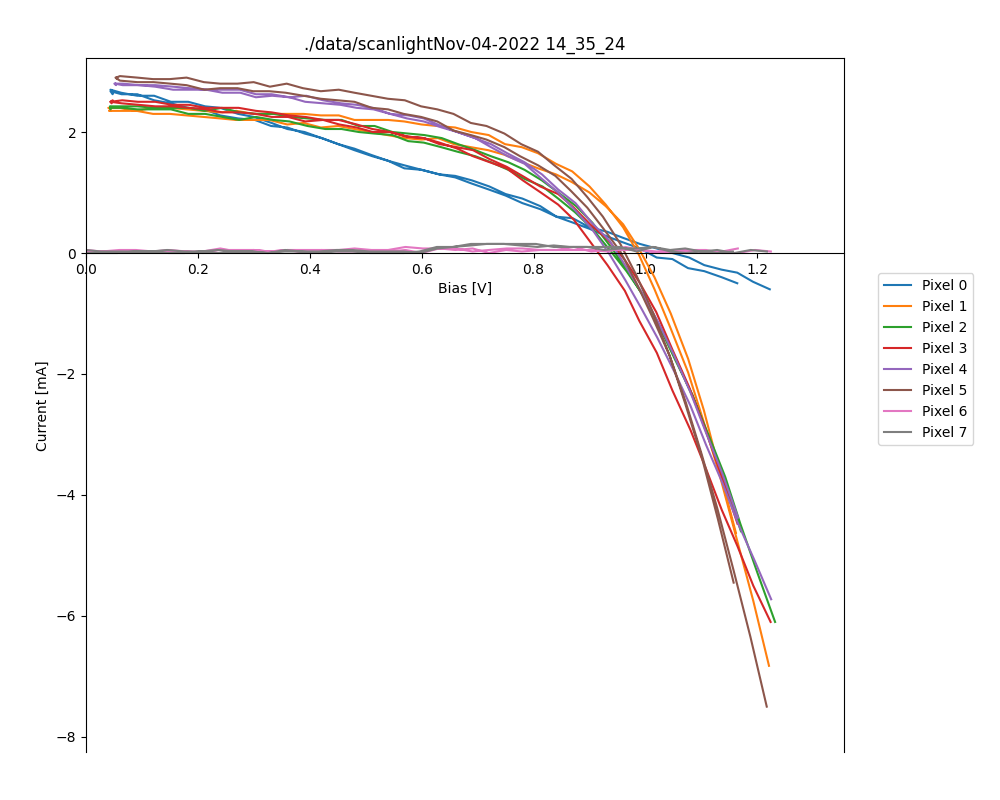
data/Nov-4-good-tests/PCB/scanlightNov-04-2022 14_35_24.png
