AndChen153/Stability-Setup/data/Sept 9 MPPT 8 Pixel test/2022.09.09 - Batch#17_MPPTTEST/2022-09-09 -- Batch12_MPPTTEST Charts/Boxplot_stabilizedPCE.png

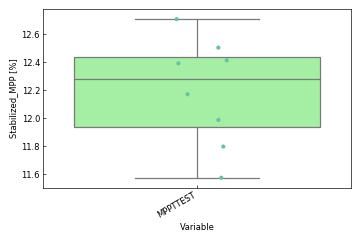
data/Sept 9 MPPT 8 Pixel test/2022.09.09 - Batch#17_MPPTTEST/2022-09-09 -- Batch12_MPPTTEST Charts/Boxplot_stabilizedPCE.png
