AndChen153/Stability-Setup/data/Testing PNO wait times/PnOMar-03-2023 18_12_02.png

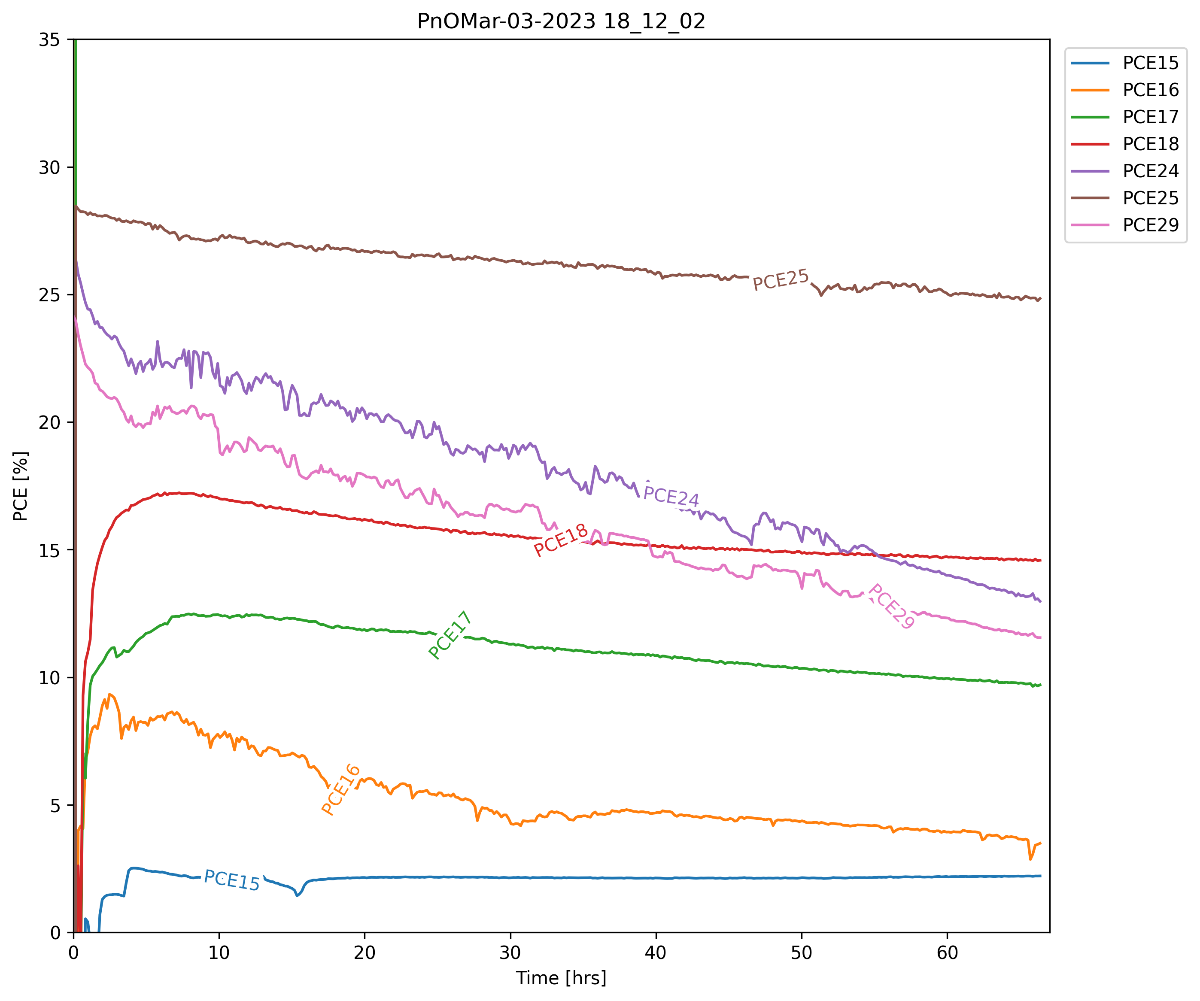
data/Testing PNO wait times/PnOMar-03-2023 18_12_02.png
