AndChen153/Stability-Setup/data/Testing PNO wait times/PnOMar-06-2023 12_52_31.png

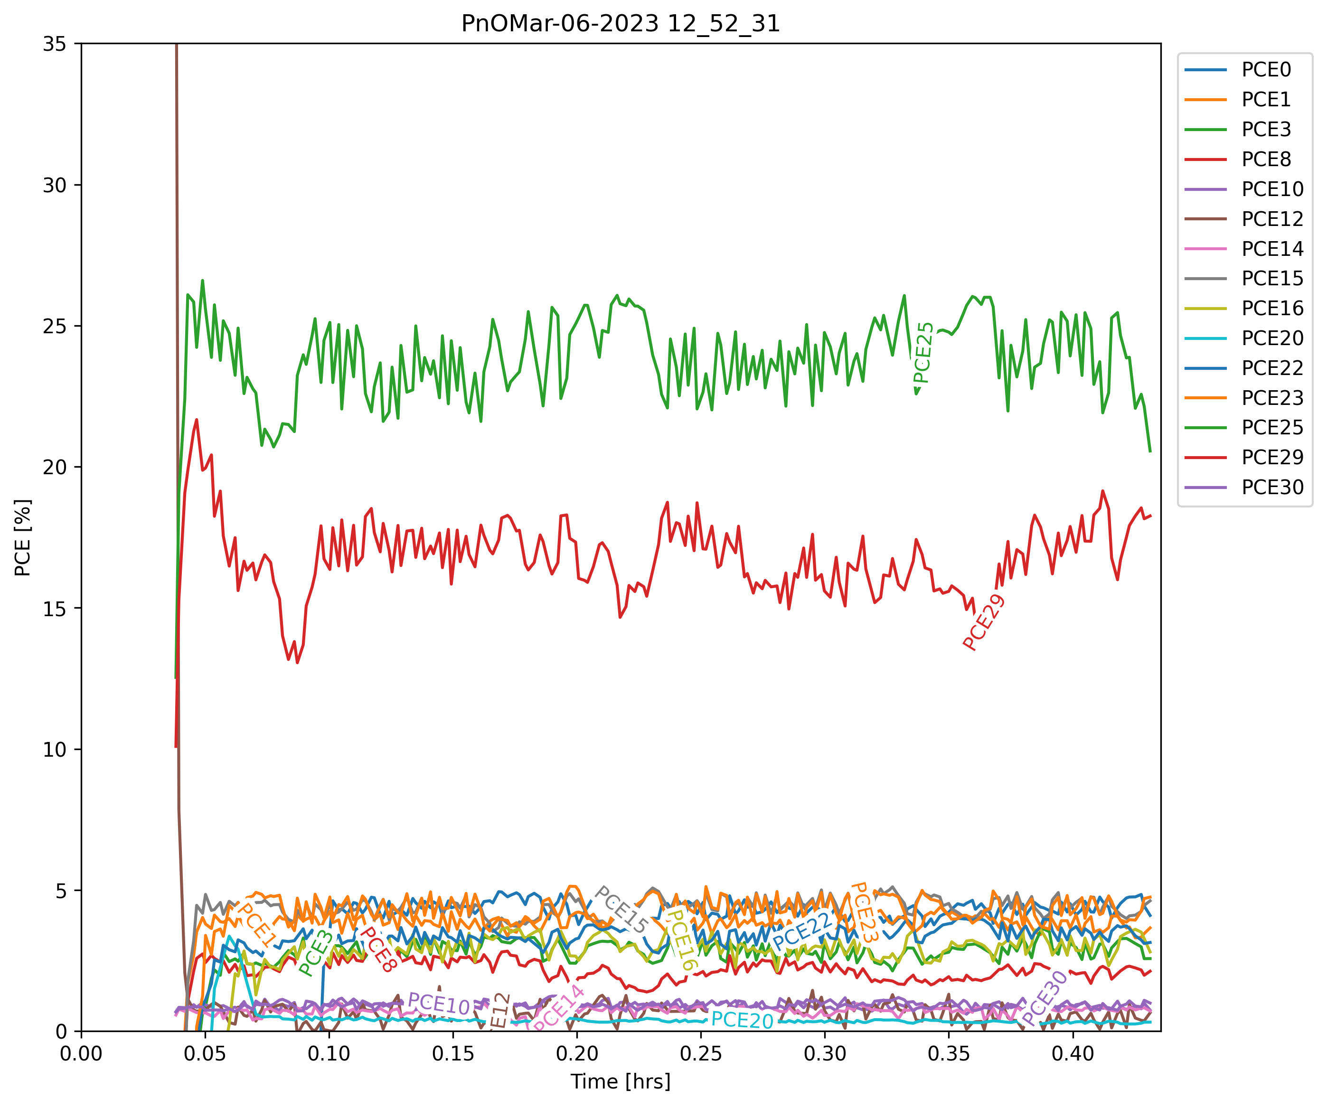
data/Testing PNO wait times/PnOMar-06-2023 12_52_31.png
