AndChen153/Stability-Setup/data/Testing PNO wait times/PnOMar-06-2023 13_26_50.png

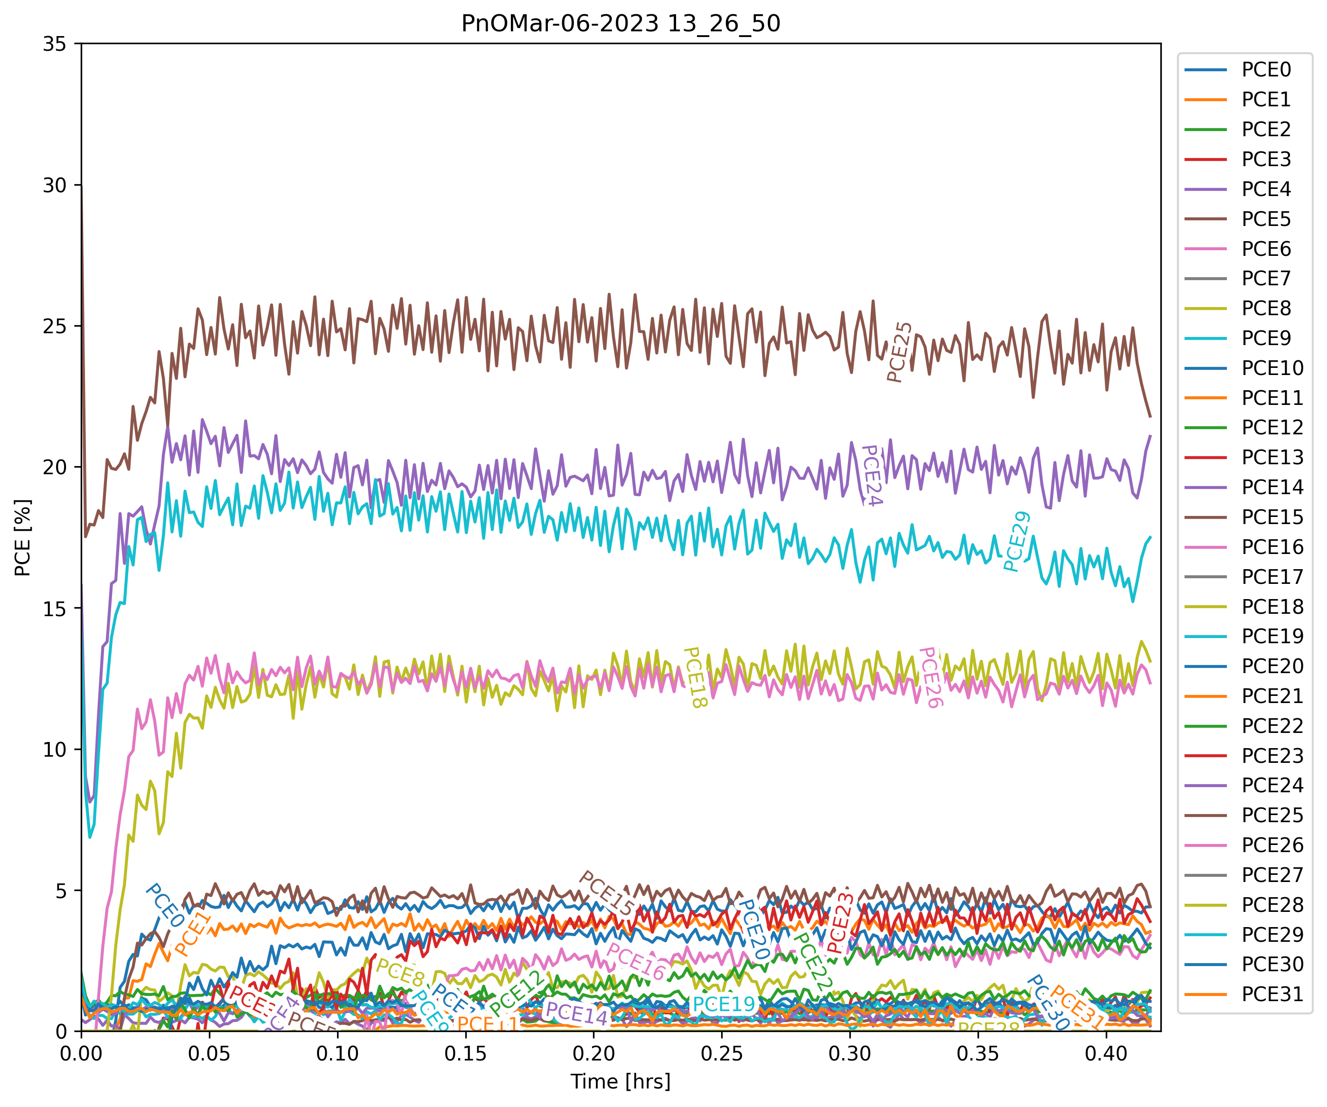
data/Testing PNO wait times/PnOMar-06-2023 13_26_50.png
