AndChen153/Stability-Setup/data/Testing PNO wait times/PnOMar-06-2023 13_53_23.png

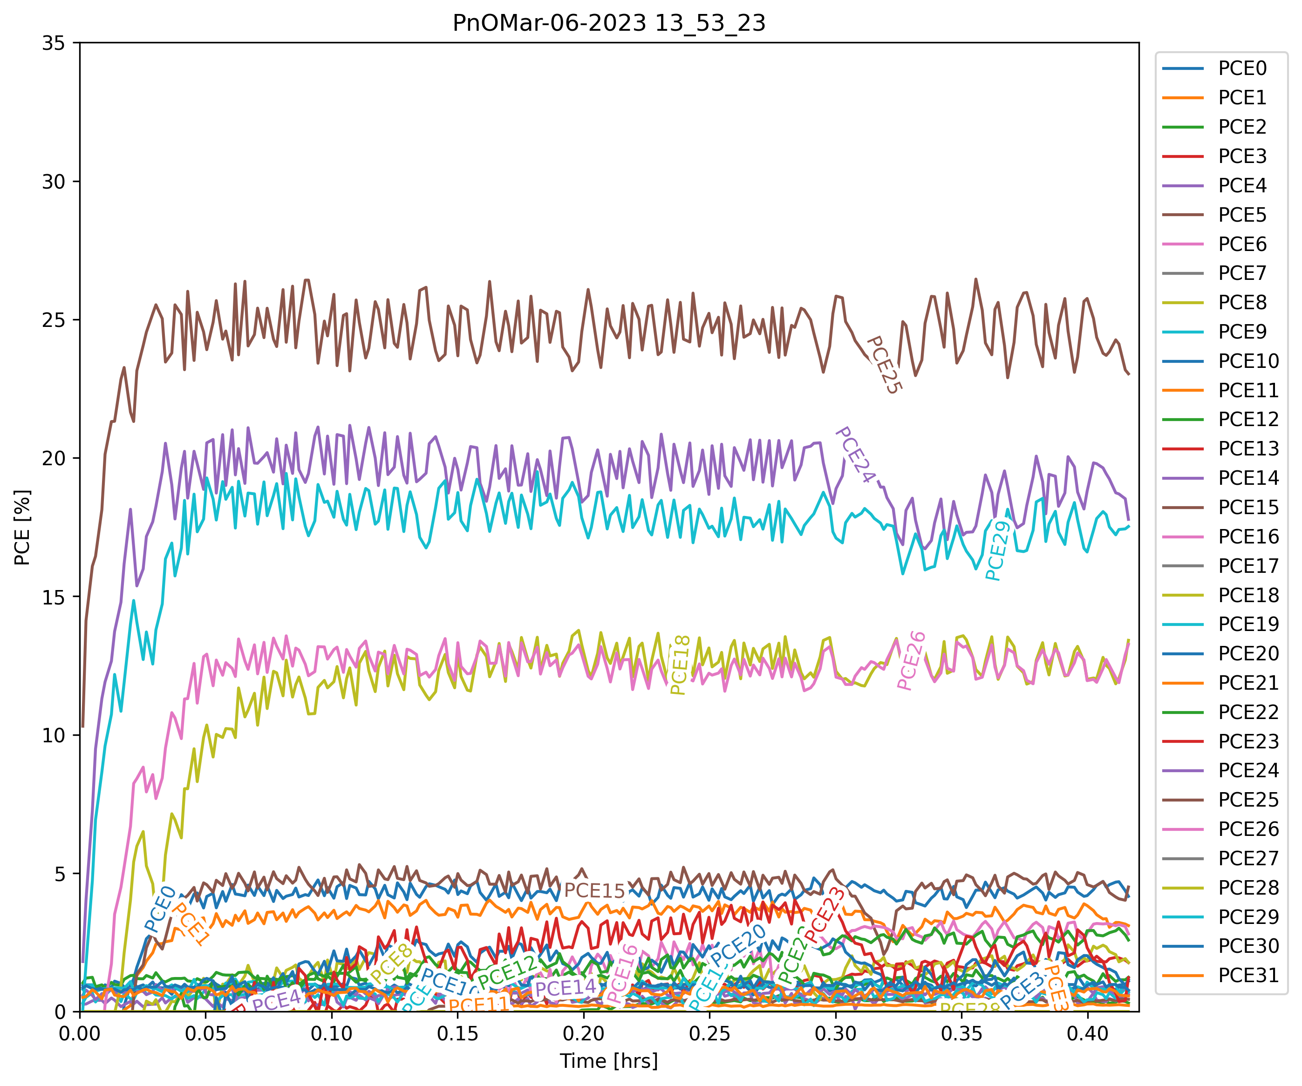
data/Testing PNO wait times/PnOMar-06-2023 13_53_23.png
