AndChen153/Stability-Setup/data/Testing PNO wait times/PnOMar-06-2023 14_19_19.png

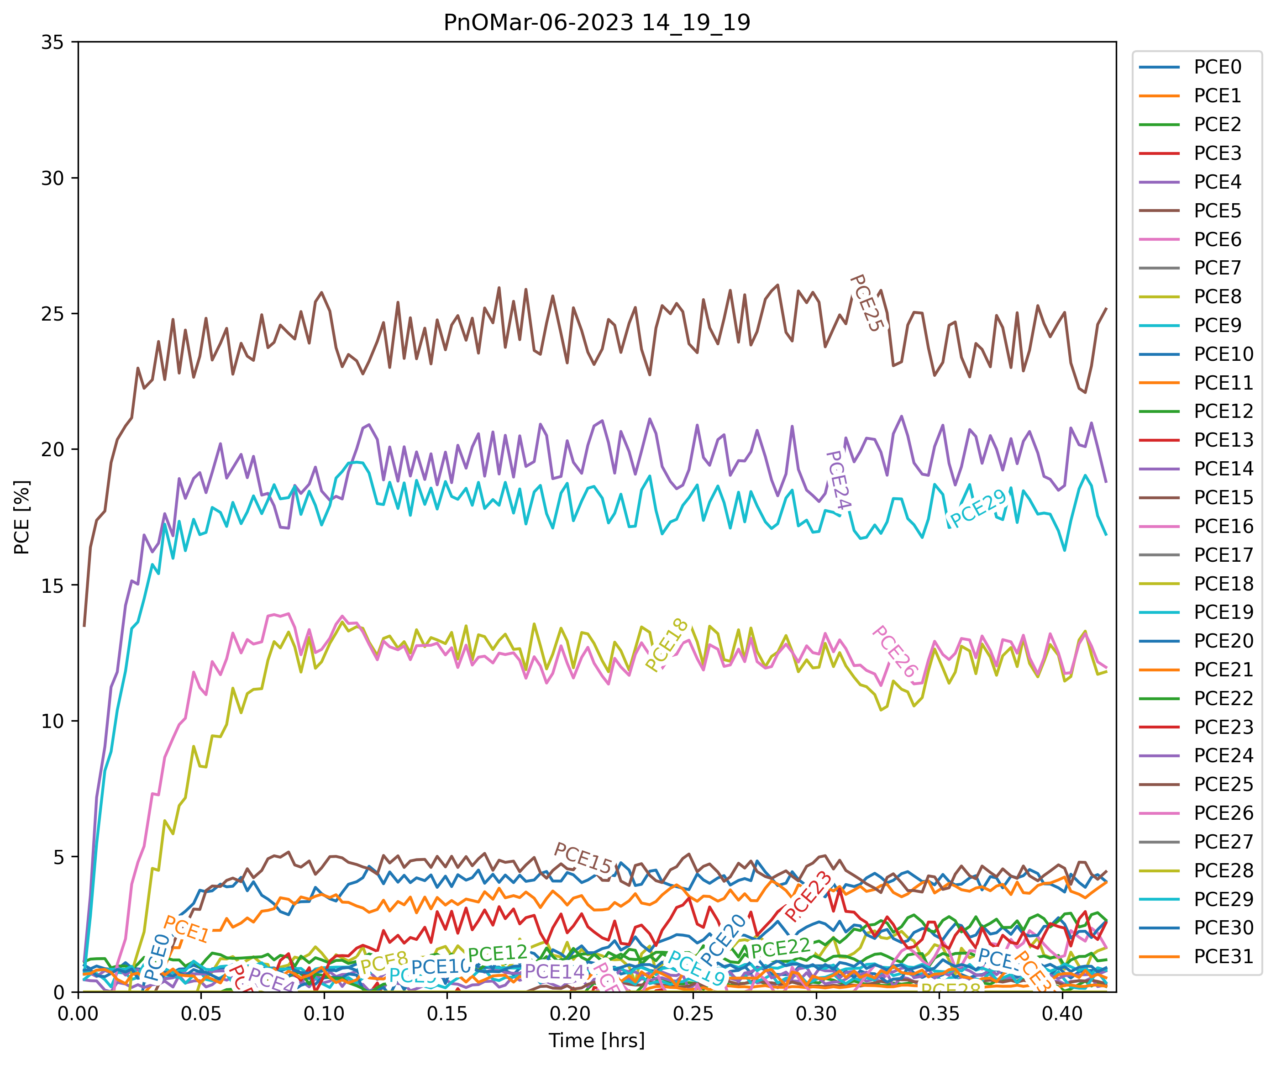
data/Testing PNO wait times/PnOMar-06-2023 14_19_19.png
