AndChen153/Stability-Setup/data/Testing PNO wait times/scanlightMar-03-2023 17_16_10.png

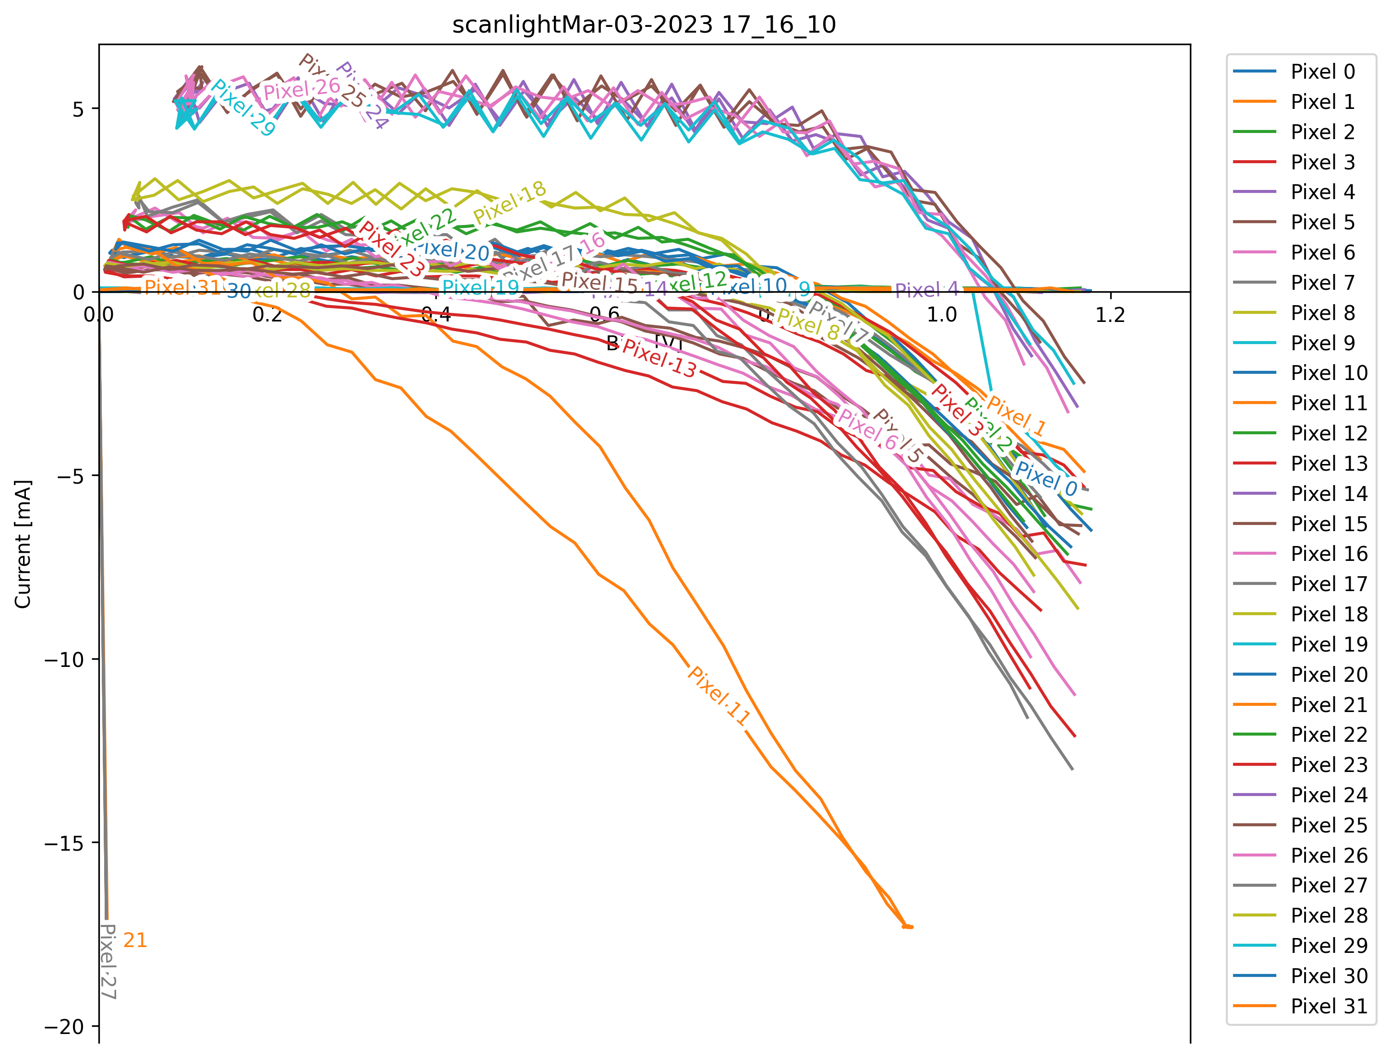
data/Testing PNO wait times/scanlightMar-03-2023 17_16_10.png
