AndChen153/Stability-Setup/data/Testing PNO wait times/scanlightMar-06-2023 12_50_20.png

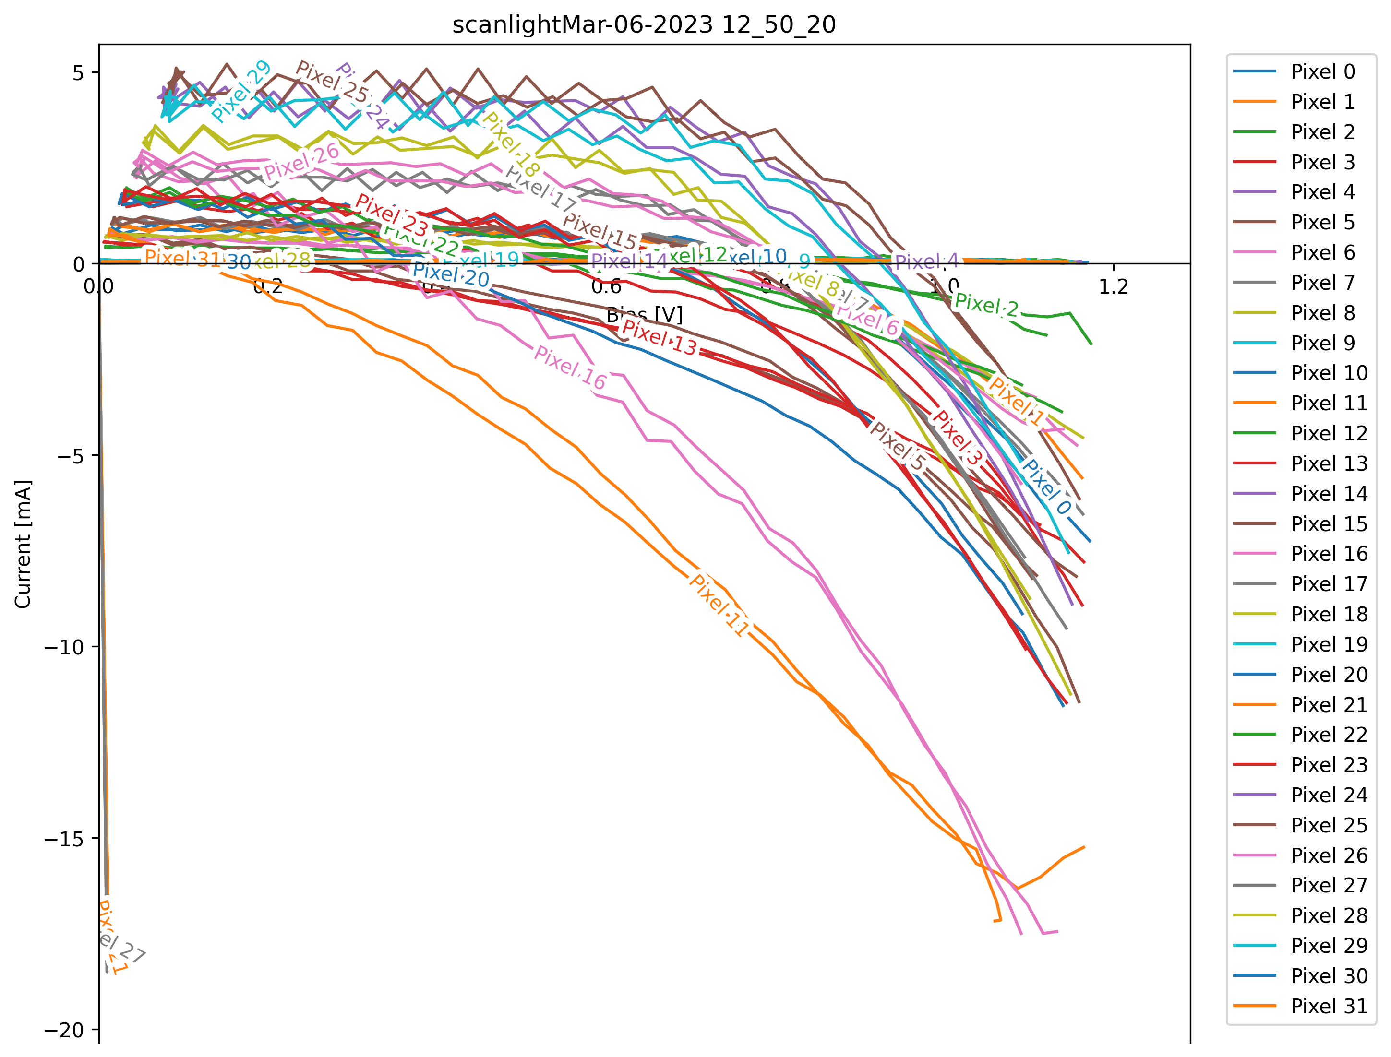
data/Testing PNO wait times/scanlightMar-06-2023 12_50_20.png
