AndChen153/Stability-Setup/(list of files, drawings)

Other design files:
pcb/altium/ERF8-060-05.0-L-DV-L-TR/ERF8-060-05.0-L-DV-L-TR.SchLib
pcb/altium/ERF8-060-05.0-L-DV-L-TR/Schlib1.SchLib
pcb/altium/ERF8-060-05.0-L-DV-L-TR/Sheet2.SchDoc
pcb/altium/LitosConnector/LitosConnector.PcbDoc
pcb/altium/LitosConnector/LitosConnector.SchDoc
pcb/old/altium/ERF8-060-05.0-L-DV-L-TR/ERF8-060-05.0-L-DV-L-TR.PrjPcb
pcb/old/altium/ERF8-060-05.0-L-DV-L-TR/ERF8-060-05.0-L-DV-L-TR.SchLib
pcb/old/altium/ERF8-060-05.0-L-DV-L-TR/Schlib1.SchLib
pcb/old/altium/ERF8-060-05.0-L-DV-L-TR/Sheet2.SchDoc
pcb/old/altium/LitosConnector/LitosConnector.PcbDoc
pcb/old/altium/LitosConnector/LitosConnector.PrjPcb
pcb/old/altium/LitosConnector/LitosConnector.SchDoc
