AndChen153/Stability-Setup/Stability-Setup_Python/controller/email_service.py

import os
import smtplib
from dotenv import load_dotenv
from helper.global_helpers import get_logger

# Load environment variables from .env file
load_dotenv()

class EmailSender:
    def __init__(self, username, password):
        # Retrieve credentials and settings from environment variables
        self.username = username
        self.password = password
        self.smtp_server = "smtp.gmail.com"
        self.smtp_port = 465

        # Validate essential variables are available
        if not self.username or not self.password:
            # TODO: add link here to instructions
            get_logger().log("Missing email credentials. Please set EMAIL_USER and EMAIL_PASS in your .env file.")

    def send_email(self, subject, body, to_email):
        """
        Sends an email with the given subject and body to the specified recipient.
        """
        if not self.username or not self.password:
            get_logger().log("Missing email credentials. Please set EMAIL_USER and EMAIL_PASS in your .env file.")
            return
        # Construct the email message
        message = f"Subject: {subject}\n\n{body}"

        try:
            # Establish a secure session with the SMTP server using SSL
            with smtplib.SMTP_SSL(self.smtp_server, self.smtp_port) as server:
                server.login(self.username, self.password)
                server.sendmail(self.username, to_email, message)
            get_logger().log("Email sent successfully.")
        except Exception as e:
            get_logger().log(f"Error sending email: {e}")

# Example usage
if __name__ == "__main__":
    sender = EmailSender()
    sender.send_email(
        subject="Test Email",
        body="Hello,\n\nThis is a test email sent using a Python class with environment variables.",
        to_email="recipient@example.com"
    )
