AndChen153/Stability-Setup/TestCode/i2cScan.ino

// --------------------------------------
// i2c_scanner
//
// Modified from https://playground.arduino.cc/Main/I2cScanner/
// --------------------------------------

#include <Wire.h>

// Set I2C bus to use: Wire, Wire1, etc.
#define WIRE Wire

void setup() {
  WIRE.begin();

  Serial.begin(9600);
  while (!Serial)
     delay(10);
  Serial.println(F("\nI2C Scanner"));
}


void loop() {
  byte error, address;
  int nDevices;

  Serial.println(F("Scanning..."));

  nDevices = 0;
  for(address = 1; address < 127; address++ )
  {
    // The i2c_scanner uses the return value of
    // the Write.endTransmisstion to see if
    // a device did acknowledge to the address.
    WIRE.beginTransmission(address);
    error = WIRE.endTransmission();

    if (error == 0)
    {
      Serial.print(F("I2C device found at address 0x"));
      if (address<16)
        Serial.print(F("0"));
      Serial.print(F(address,HEX));
      Serial.println(F("  !"));

      nDevices++;
    }
    else if (error==4)
    {
      Serial.print(F("Unknown error at address 0x"));
      if (address<16)
        Serial.print(F("0"));
      Serial.println(F(address,HEX));
    }
  }
  if (nDevices == 0)
    Serial.println(F("No I2C devices found\n"));
  else
    Serial.println(F("done\n"));

  delay(1000);           // wait 5 seconds for next scan
}
