AndChen153/Stability-Setup/(commit log)

2022-07-08 works for 1 pixel
    [ALLValsPixel5LightJV-Jul-06-2022 10_12_08.csv, AVGPixel5DarkJV-Jul-06-2022 10_02_25.csv, AVGPixel5LightJV-Jul-06-2022 10_06_04.csv, AllValsPixel5DarkJV-Jul-06-2022 10_09_46.csv, CostBreakdown.xlsx, Jul-06-2022 09_45_53.csv, Jul-06-2022 09_47_58.csv, Jul-06-2022 09_51_15.csv]
2022-07-11 mpp tracking
    [ALLValsPixel5LightJV-Jul-06-2022 10_12_08.csv, AVGPixel5DarkJV-Jul-06-2022 10_02_25.csv, AVGPixel5LightJV-Jul-06-2022 10_06_04.csv, AllValsPixel5DarkJV-Jul-06-2022 10_09_46.csv, Pixel6DarkJVJul-11-2022 16_12_12.csv, Pixel6LightJVJul-11-2022 16_13_10.csv, PnO_Jul-11-2022 18_20_28.csv, data.csv]
2022-07-28 8 pixels
    [AllDataJul-11-2022.xlsx, PnO_Jul-28-2022 02_34_06.csv, scan-dark_Jul-25-2022 15_12_29.csv, scan-light_Jul-25-2022 15_13_34.csv, scan_Jul-22-2022 14_47_30.csv, scan_Jul-22-2022 14_50_53.csv, scan_Jul-22-2022 14_54_06.csv, scan_Jul-22-2022 14_55_36.csv]
2022-08-24 switched to arduino due
2022-09-07 8pixel mppt v1
    [PnOSep-07-2022 13_32_39.csv, scandark_Sep-07-2022 11_51_46.csv, scandark_Sep-07-2022 12_05_51.csv, scandark_Sep-07-2022 12_07_11.csv, scandark_Sep-07-2022 12_09_36.csv, scanlight_Sep-07-2022 12_13_01.csv]
2022-09-16 mppt working
    [2022-09-09 -- Batch12_MPPTTEST_Log.csv, 2022-09-09 -- Batch12_MPPTTEST_summary.csv, MPPTComparison.xlsx, PnOSep-09-2022 10_18_42.csv, PnOSep-09-2022 11_16_06.csv, PnOSep-09-2022 11_22_45.csv, PnOSep-09-2022 11_28_59.csv, SK17 - MPPTTEST[1]_0_0.csv]
2022-09-28 working towards oop
    [Hours.xlsx]
2022-10-04 datavis and gui
    [Hours.xlsx]
2022-10-13 not working :(
    [scandarkOct-12-2022 20_14_50.csv, scandarkOct-12-2022 20_35_12.csv, scanlightOct-12-2022 20_18_57.csv, scanlightOct-12-2022 20_25_42.csv, scanlightOct-12-2022 20_30_22.csv]
2022-12-11 ready for pno long term test
    [PnODec-10-2022 17_30_31.csv, PnODec-10-2022 17_33_24.csv, PnODec-10-2022 17_37_04.csv, PnODec-10-2022 17_54_27.csv, scanlightDec-06-2022 21_24_37.csv, scanlightDec-10-2022 17_18_36.csv, scanlightDec-10-2022 17_21_25.csv, scanlightDec-10-2022 17_23_24.csv]
2022-12-12 first mppt long term test
    [PnODec-11-2022 12_48_32.csv, scandarkDec-11-2022 12_40_46.csv, scanlightDec-11-2022 12_42_28.csv]
2022-12-12 data upload
    [PnODec-09-2022 22_14_58.csv, PnODec-09-2022 22_15_40.csv, PnODec-09-2022 22_16_18.csv, PnODec-09-2022 22_20_04.csv, PnODec-10-2022 17_30_31.csv, PnODec-10-2022 17_33_24.csv, PnODec-10-2022 17_37_04.csv, PnODec-10-2022 17_54_27.csv]
2022-12-13 new data
    [PnODec-12-2022 16_06_31.csv, PnODec-12-2022 16_06_40.csv, PnODec-12-2022 16_08_27.csv, scanlightDec-12-2022 15_56_30.csv, scanlightDec-12-2022 16_04_41.csv, scanlightDec-12-2022 16_24_50.csv]
2022-12-14 fix data
    [Hours.xlsx]
2022-12-14 data up
    [PnODec-12-2022 16_06_31.csv, PnODec-12-2022 16_06_40.csv, PnODec-12-2022 16_08_27.csv, PnODec-13-2022 15_44_12.csv, scanlightDec-12-2022 15_56_30.csv, scanlightDec-12-2022 16_04_41.csv, scanlightDec-12-2022 16_24_50.csv, scanlightDec-13-2022 15_39_07.csv]
2023-02-21 multiplexer not working
    [scanlightFeb-21-2023 15_09_42.csv, scanlightFeb-21-2023 15_12_27.csv, scanlightFeb-21-2023 15_22_36.csv, scanlightFeb-21-2023 15_34_11.csv]
2023-03-03 4 device mppt and jv working
    [CostBreakdown.xlsx, PnODec-09-2022 22_14_58.csv, PnODec-09-2022 22_15_40.csv, PnODec-09-2022 22_16_18.csv, PnODec-09-2022 22_20_04.csv, PnODec-10-2022 17_30_31.csv, PnODec-10-2022 17_33_24.csv, PnODec-10-2022 17_37_04.csv]
2023-03-03 updated 4 device mppt
    [PnOMar-03-2023 16_13_30.csv, PnOMar-03-2023 16_14_05.csv, PnOMar-03-2023 16_16_03.csv, PnOMar-03-2023 16_17_02.csv, PnOMar-03-2023 16_19_24.csv, PnOMar-03-2023 16_21_38.csv, PnOMar-03-2023 16_23_31.csv, scanlightMar-03-2023 17_05_09.csv]
2023-03-05 more mppt updates
    [PnOMar-03-2023 17_31_40.csv, PnOMar-03-2023 18_02_58.csv, scanlightMar-03-2023 17_05_09.csv]
2023-03-15 data push
    [PnOMar-06-2023 13_26_50.csv, PnOMar-06-2023 13_53_23.csv, PnOMar-06-2023 14_19_19.csv, PnOMar-06-2023 14_52_59.csv, testingResults.csv]
2023-03-15 intermittent jv in pno trials
    [PnOMar-06-2023 12_52_31.csv, PnOMar-06-2023 13_26_50.csv, PnOMar-06-2023 13_53_23.csv, PnOMar-06-2023 14_19_19.csv, PnOMar-06-2023 14_52_59.csv, scanlightMar-03-2023 17_16_10.csv, scanlightMar-06-2023 12_50_20.csv, testingResults.csv]
2023-03-15 vmpp vals transfer
    [PnOMar-15-2023 13_29_55.csv, scanlightMar-15-2023 13_28_50.csv, scanlightMar-15-2023 13_34_51.csv]
2023-04-26 4 devices finished??
    [Apr-25-2023 15_08_02lightscan.csv, Apr-25-2023 15_14_05darkscan.csv, Apr-25-2023 15_15_20lightscan.csv, Apr-25-2023 15_17_01lightscan.csv, Apr-25-2023 15_30_59lightscan.csv, Apr-25-2023 15_33_00lightscan.csv, Apr-25-2023 15_34_06scan.csv, Apr-25-2023 15_39_01lightscan.csv]
2023-05-01 endof sem 2
    [2023-04-25 --Litos vs stability setup test_Log.csv, 2023-04-25 --Litos vs stability setup test_summary.csv, 2023-04-26 -- test2_Log.csv, 2023-04-26 -- test2_summary.csv, Apr-25-2023 15_08_02lightscan.csv, Apr-25-2023 15_14_05darkscan.csv, Apr-25-2023 15_15_20lightscan.csv, Apr-25-2023 15_17_01lightscan.csv]
2023-08-21 refactoring + bug fixes
    [Aug-20-2023 14_46_56lightscan.csv]
2023-08-22 fixed graphs not auto generating by returning absolute file path
    [Aug-20-2023 14_46_56lightscan.csv, Aug-20-2023 14_49_47lightscan.csv, Aug-20-2023 23_19_59lightscan.csv, Aug-20-2023 23_45_48lightscan.csv, Aug-22-2023 01_08_05lightscan.csv]
2023-10-26 individual arduino control and multithreading capabilities
    [2022-09-09 -- Batch12_MPPTTEST_Log.csv, 2022-09-09 -- Batch12_MPPTTEST_summary.csv, 2023-04-25 --Litos vs stability setup test_Log.csv, 2023-04-25 --Litos vs stability setup test_summary.csv, 2023-04-26 -- test2_Log.csv, 2023-04-26 -- test2_summary.csv, Apr-25-2023 15_08_02lightscan.csv, Apr-25-2023 15_14_05darkscan.csv]
2024-09-19 new gui and added constant voltage
    [2023-10-27 -- ind_test_Log.csv, 2023-10-27 -- ind_test_summary.csv, Apr-25-2023 15_50_06lightscan.csv, Apr-25-2023 15_51_12PnO.csv, Apr-26-2023 16_13_25lightscan.csv, Apr-26-2023 16_14_17PnO.csv, Nov-08-2023 11_56_41lightID1scan.csv, Nov-08-2023 11_56_41lightID2scan.csv]
2024-11-04 break up stabilitySetup.ino into multiple files for easier management
    [Nov-04-2024 14_02_19lightID2scan.csv]
2024-11-06 mppt algorithm that works!!!
    [B4[1]_0_0.csv, B4[1]_0_1.csv, B4[1]_1_0.csv, B4[1]_2_0.csv, B4[1]_2_1.csv, B4[1]_3_0.csv, B4[2]_0_0.csv, B4[2]_0_1.csv]
2024-11-08 improve code quality
    [2022-09-09 -- Batch12_MPPTTEST_Log.csv, 2022-09-09 -- Batch12_MPPTTEST_summary.csv, 2023-04-25 --Litos vs stability setup test_Log.csv, 2023-04-25 --Litos vs stability setup test_summary.csv, 2023-04-26 -- test2_Log.csv, 2023-04-26 -- test2_summary.csv, Apr-25-2023 15_08_02lightscan.csv, Apr-25-2023 15_14_05darkscan.csv]
2024-11-08 Removed ignored tracked files from Git index
    [2022-09-09 -- Batch12_MPPTTEST_Log.csv, 2022-09-09 -- Batch12_MPPTTEST_summary.csv, 2023-10-27 -- ind_test_Log.csv, 2023-10-27 -- ind_test_summary.csv, ALLValsPixel5LightJV-Jul-06-2022 10_12_08.csv, AVGPixel5DarkJV-Jul-06-2022 10_02_25.csv, AVGPixel5LightJV-Jul-06-2022 10_06_04.csv, AllDataJul-11-2022.xlsx]
2024-11-19 fix multithreader bug
    [Nov-13-2024 13_48_11lightID1scan.csv, Nov-13-2024 13_48_11lightID2scan.csv, Nov-13-2024 13_48_11lightID3scan.csv, Nov-13-2024 13_48_11lightID4scan.csv, Nov-13-2024 13_49_24ID1PnO.csv, Nov-13-2024 13_49_24ID2PnO.csv, Nov-13-2024 13_49_51ID1PnO.csv, Nov-13-2024 13_49_51ID2PnO.csv]
2024-12-03 data and mppt compare
    [2023-04-25 --Litos vs stability setup test_Log.csv, 2023-04-25 --Litos vs stability setup test_summary.csv, 2023-04-26 -- test2_Log.csv, 2023-04-26 -- test2_summary.csv, B4[1]_0_0.csv, B4[1]_0_1.csv, B4[1]_1_0.csv, B4[1]_2_0.csv]
2025-01-23 stopping commands work, no longer need to manually reset arduino
    [Stability-Setup_Arduino.ino, arduino_assignment.py, helper.cpp, helper.h, main_2_0.py, measurement.cpp]
2025-01-28 added plot viewing and creating functtions to GUI, removed data folder to simplify repo
    [2023-04-25 --Litos vs stability setup test_Log.csv, 2023-04-25 --Litos vs stability setup test_summary.csv, 2023-04-26 -- test2_Log.csv, 2023-04-26 -- test2_summary.csv, B4[1]_0_0.csv, B4[1]_0_1.csv, B4[1]_1_0.csv, B4[1]_2_0.csv]
2025-01-29 fix for arduino sensor init
    [Stability-Setup_Arduino.ino, arduinoAuto4DevicesMEGA_1_0.ino, arduinoAuto8Pixels1_0.ino, arduinoAuto8Pixels1_1.ino, arduinoAuto8Pixels1_2.ino, arduinoAutoOnePixel.ino, arduinoSensorFull.ino, controller_1_0.py]
2025-01-29 fix bug for pno not starting
    [multi_arduino_controller.py]
2025-02-12 PCB PUSH and hardware ID
    [BOM_stability_setup_1_1_2025-02-06.csv, ERF8-060-05.0-L-DV-L-TR.PrjPcb, ERF8-060-05.0-L-DV-L-TR.SchLib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]
2025-02-12 New UI not hooked up yet but plotting working
    [ERF8-060-05.0-L-DV-L-TR.PrjPcb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]
2025-02-23 New Circuit board code and hooked up to gui
2025-02-26 Fix for data size estimation
    [single_arduino_controller.py]
2025-03-01 fix email no password
    [email_service.py]
2025-03-01 quick fixes, not permanent
    [Stability-Setup_Arduino.ino, measurement.cpp, multi_arduino_controller.py, sensor.cpp, single_arduino_controller.py]
2025-03-02 GUI refactor and saving averaged data
    [to_puchase.xlsx]
2025-03-20 temp fix + todo update
    [measurement.cpp]
2025-03-26 automate plot full data button
2025-04-16 fix for arduino nano
    [Stability-Setup_Arduino.ino, helper.cpp, serial_com.cpp, serial_com.h]
2025-04-26 New pc-arduino communication protocol. MPPT delay fix. MPPT time fix.
    [Stability-Setup_Arduino.ino, arduinoAutoOnePixel.ino, measurement.cpp, multi_arduino_controller.py]
2025-04-30 UI fixes and new parameter
    [single_arduino_controller.py]
2025-04-30 added logging panel and UI fixes
    [arduino_assignment.py, email_service.py, multi_arduino_controller.py]
2025-04-30 Fix for outside of main thread updates to UI casuing seg faults
    [arduino_assignment.py, email_service.py, flash.py]
2025-06-26 Gating to help prevent outlandish mA
    [helper.cpp, helper.h, measurement.cpp]
2025-07-30 fix for 10 minute cap
    [measurement.cpp, single_arduino_controller.py]
2025-07-30 Connected save logs to button
2025-07-30 all pixels same color per device
2025-07-31 display voltage and current
2025-11-06 Revise README with async Arduino communication steps
2025-11-07 Update README with BOM and next steps
